darwinbeing/PB560/medtronic-pb560-ventilator-system-file-set-2/Mechanical Part Drawings/2963300/2963300_B_ECO-R214715.pdf

# 2963300, Revision B

Attribute Name | Attribute Value
Part Number | 2963300
Part Description | ELECTRIC FILTER WITH FOAM
Subclass | RSP PART - MECHANICAL
Product Family | RSP - VENTILATOR SYSTEMS
Part Category | FILTER
UOM | EA = EACH
Lifecycle Phase | Production
Release Date | 01/24/2013 13:55:03 GMT
Effectivity Date | 05/17/2013 07:00:00 GMT
Incorporation Date | 01/23/2013 21:19:53 GMT
Rev | B ECO-R214715

## Not Used

Owning Site: Agile Only | BOULDER
Model Number: Agile Only | RSP - PB560-520
Item Type: BPCS Add | P = Purchased Custom
Manufacturing Sites: Agile Only | N/A
Consuming Sites: Agile Only | GALWAY
Must Single Issue: BPCS Add | NO
Control Method: BPCS Add | NONE
Commodity Code: BPCS Add-Updt | RM10.00
Shelf Life Days:BPCS Add-Updt | 0
Item Class: BPCS Add-Updt | GL-66 PB500 Series Ventilators/Gen 1
Country of Origin: BPCS Add | FR = FRANCE
Legacy Site Agile BOM Load | USED FOR RSP AGILE DATA LOAD
Legacy Site Agile Part Load | USED FOR RSP AGILE DATA LOAD
Originator (Agile User Name) | Paul - RSP PLS Keller

## Attachment Destination Supplier

Notes | AIROX AML

## Replaced By (List new number) Supersedes (List old number) Matrix/Tab/Source Cntl Dwg #

## Page 1 of

# Pending Changes

ECO Number | ECO Type | Proposed Rev | Status | Description of Change | Change Analyst | Date Originated

## Page 2 of

# Change History

Rev | Lifecycle | Release Date | Incorp Date | Effective Date | ECO Number | ECO Type | Description of Change

Date Originated

B | Production | 01/24/2013 13:55:03 GMT | 01/23/2013 21:19:53 GMT | 05/17/2013 07:00:00 GMT | ECO-R214715 | RSP ECO - PRODUCTION
- UPDATE DRAWING
| | | | | | | TO COVIDIEN STANDARDS AS PER
| | | | | | | 10012400 DOCUMENT.
- UPDATED
| | | | | | | AFFECTED ITEMS PER ROHS PROCEDURE
| | | | | | | 10050020
- ADDED
| | | | | | | MANUFACTURE INFO ALONG WITH THE CERTIFICATE OF ROHS COMPLIANCE.
- ADDED COVIDIEN
| | | | | | | AS MANUFACTURER IN THE MANUFACTURE TAB.
- CHANGED ITEM
| | | | | | | TYPE FROM "P=PURCHASED" TO "P=PURCHASE CUSTOM" AND FROM "6=NON-INV" TO "6=NON-INV CUSTOM".
- FOR P/N
| | | | | | | 4096600.M00.023, ADDED ANGULAR TOLERANCE PER SHEET METAL TOLERANCE PROCEDURE 4- 070138-52.
- FOR #2963300
| | | | | | | CREATED BOM BY ADDING #10049689 AND #10049690.
- NO CHANGE IN FIT,
| | | | | | | FORM AND FUNCTION OF THE PARTS.
- PLEASE REFER
| | | | | | | CDP-RMS-0000518 AFFECTED ITEMS:
1) 2963300
2) 4096600.M00.002
3) 4096600.M00.003
4) 4096600.M00.023
5) 3821600

07/20/2012 07:55:30
GMT
A | Production | 01/14/2010 12:13:35 GMT | 01/14/2010 12:10:08 GMT | 05/13/2010 23:00:00 GMT | ECO-R179932 | RSP ECO -PRODUCTION | 1/BRINGING ITEMS TO CURRENT REV IN AGILE | 12/18/2009 08:55:43 GMT
00 | Production | 09/12/2007 10:40:32 GMT | 08/27/2007 08:13:20 GMT | 08/30/2007 23:00:00 GMT | ECO-R163956 | RSP ECO -PRODUCTION | INITIAL RELEASE OF LEGENDAIR XL2 AML PARTS, WITH REVISIONS. | 07/31/2007 09:10:08 GMT
| Pilot | 05/22/2007 13:21:27 GMT | | | ECO-R163056 | RSP ECO - BPCS PART UPDATE | INITIAL RELEASE OF LEGENDAIR XL2 P/NS ONTO GALWAY BPCS | 05/22/2007 12:35:01 GMT
| Pilot | 05/22/2007 07:44:32 GMT | | | ECO-R163013 | RSP ECO - BPCS PART UPDATE | INITIAL RELEASE OF LEGENDAIR XL2 P/NS ONTO GALWAY BPCS | 05/18/2007 11:52:27 GMT

## Page 3 of

# BOM

Part Number | Part Description | Rev | Qty | Line Item # | Ref Des | Notes | Alternate Part? | Balloon | Item Subclass | Lifecycle | Thumbnail
10049689 | IFU, GEN 1, FILTER, 6 PACK | C ECO-R250933 | 1 | 0 | | | NO | | RSP PART -LABEL/MANUAL | Production
10049690 | LABEL, GEN 1, FILTER, 6 PACK | C ECO-R250933 | 1 | 0 | | | NO | | RSP PART -LABEL/MANUAL | Production

## Page 4 of

# Manufacturers

Manufacturer Name | Manufacturer's Part number | Mfr. Part Status | Preference Code | Notes | Manufacturer Code | Manufacturer Status | RoHs Compliance Status | ROHS Inventory Status
AIR SAFETY LTD., | 7270 / 213 | QUALIFIED | PREFERRED | REFER TO COVIDIEN DRAWING 2963300 | | APPROVED | ROHS | Cleared

## Page 5 of

# Relationships

Criteria Met | Name | Description | Current Status | Rule | Type | Relation Note

## Page 6 of

# Attachments

Is Checked Out | Has Been Redlined | Filename | File Descripti on | File Size | File Type | Folder Number | Checkou t User | Checkou t Date | Modified Date | Last View Date | Checkou t Location | Version Create Date | Attachm ent Type | Thumbn ail | Checkin User | Label | Folder Descripti on | Folder Version
false | false | 2963300. SLDDRW | Approved Rev B, Source files | 681472.0 | SLDDRW | FOLDER0 306400 | | | 05/02/201 4 13:10:45 GMT | 05/02/201 4 13:10:44 GMT | | 11/20/201 2 11:24:57 GMT | | | Nikhil Mankar | | | 2
false | false | 2963300B 00.PDF | Approved Rev B | 29597.0 | PDF | FOLDER0 306399 | | | 05/02/201 4 13:16:49 GMT | 05/02/201 4 13:16:48 GMT | | 12/13/201 2 10:48:02 GMT | | | Nikhil Mankar | | | 3
false | false | 2963300A 00.pdf | Redlined Rev A to Rev B | 34547.0 | pdf | FOLDER0 306401 | | | 11/01/201 2 04:26:32 GMT | 11/01/201 2 04:26:32 GMT | | 11/01/201 2 04:26:32 GMT | | | Nikhil Mankar | | | 1

## Page 7 of

# History

Action | User | Local Client Time | User Action Time | Details | Comments | Rev
Get file attachment | Michael Duggan | 04/23/2015 11:03:58 GMT | 04/23/2015 12:03:58 PM | FOLDER0306399 V 3 2963300B00.PDF | | B ECO-R214715
Get file attachment | Michael Duggan | 04/23/2015 11:03:52 GMT | 04/23/2015 12:03:52 PM | FOLDER0306399 V 3 2963300B00.PDF | | B ECO-R214715
Get file attachment | Michael Duggan | 04/23/2015 09:27:04 GMT | 04/23/2015 10:27:04 AM | FOLDER0306399 V 3 2963300B00.PDF | | B ECO-R214715
Get file attachment | Brendan Boyle | 04/23/2015 09:17:01 GMT | 04/23/2015 10:17:01 AM | FOLDER0306399 V 3 2963300B00.PDF | | B ECO-R214715
Get file attachment | Tommy Duggan | 04/23/2015 09:16:48 GMT | 04/23/2015 10:16:48 AM | FOLDER0306399 V 3 2963300B00.PDF | | B ECO-R214715
Get file attachment | Martin Gargiulo | 03/20/2015 11:17:11 GMT | 03/20/2015 11:17:11 AM | FOLDER0306399 V 3 2963300B00.PDF | | B ECO-R214715
Get file attachment | Patricia Smith | 01/12/2015 09:28:06 GMT | 01/12/2015 09:28:06 AM | FOLDER0306399 V 3 2963300B00.PDF | | B ECO-R214715
Get file attachment | Sean Foley | 01/08/2015 16:34:33 GMT | 01/08/2015 04:34:33 PM | FOLDER0306399 V 3 2963300B00.PDF | | B ECO-R214715
Get file attachment | Liam Curley | 01/08/2015 12:25:46 GMT | 01/08/2015 12:25:46 PM | FOLDER0306399 V 3 2963300B00.PDF | | B ECO-R214715
Print Tab | Martin Gargiulo | 01/08/2015 09:47:50 GMT | 01/08/2015 09:47:50 AM | Manufacturers
Print Tab | Martin Gargiulo | 01/08/2015 09:47:30 GMT | 01/08/2015 09:47:30 AM | Manufacturers
Get file attachment | Martin Gargiulo | 01/08/2015 09:46:08 GMT | 01/08/2015 09:46:08 AM | FOLDER0306399 V 3 2963300B00.PDF | | B ECO-R214715
Get file attachment | Martin Gargiulo | 01/07/2015 14:53:24 GMT | 01/07/2015 02:53:24 PM | FOLDER0306399 V 3 2963300B00.PDF | | B ECO-R214715
Get file attachment | John Berry | 09/18/2014 10:22:37 GMT | 09/18/2014 11:22:37 AM | FOLDER0306399 V 3 2963300B00.PDF | | B ECO-R214715
Get file attachment | John Berry | 08/13/2014 13:52:04 GMT | 08/13/2014 02:52:04 PM | FOLDER0306399 V 3 2963300B00.PDF | | B ECO-R214715
Get file attachment | John Berry | 08/13/2014 13:51:58 GMT | 08/13/2014 02:51:58 PM | FOLDER0306399 V 3 2963300B00.PDF | | B ECO-R214715
Get file attachment | Sean Foley | 08/11/2014 10:22:22 GMT | 08/11/2014 11:22:22 AM | FOLDER0306399 V 3 2963300B00.PDF | | (B) ECO-R248733
Get file attachment | Sean Foley | 07/17/2014 08:15:34 GMT | 07/17/2014 09:15:34 AM | FOLDER0306399 V 3 2963300B00.PDF | | B ECO-R214715
Get file attachment | Gerard Cunningham | 07/07/2014 14:50:44 GMT | 07/07/2014 09:50:44 AM | FOLDER0306399 V 3 2963300B00.PDF | | B ECO-R214715
Get file attachment | Michael Munnelly | 06/23/2014 12:21:57 GMT | 06/23/2014 01:21:57 PM | FOLDER0306399 V 3 2963300B00.PDF | | B ECO-R214715
Get file attachment | Michael Munnelly | 06/23/2014 12:21:25 GMT | 06/23/2014 01:21:25 PM | OLDFILE575146 V 0 2963300A00.pdf | | A ECO-R179932
Get file attachment | Michael Munnelly | 06/23/2014 12:18:38 GMT | 06/23/2014 01:18:38 PM | FOLDER0306401 V 1 2963300A00.pdf
Get file attachment | Michael Munnelly | 06/23/2014 12:16:59 GMT | 06/23/2014 01:16:59 PM | FOLDER0306399 V 3 2963300B00.PDF | | B ECO-R214715
Get file attachment | Michael Munnelly | 06/23/2014 12:16:15 GMT | 06/23/2014 01:16:15 PM | FOLDER0306399 V 3 2963300B00.PDF | | B ECO-R214715
Get file attachment | Deirdre Smyth | 05/28/2014 08:46:12 GMT | 05/28/2014 09:46:12 AM | FOLDER0306399 V 3 2963300B00.PDF | | B ECO-R214715
Get file attachment | Deirdre Smyth | 05/28/2014 08:46:00 GMT | 05/28/2014 09:46:00 AM | FOLDER0306400 V 2 2963300.SLDDRW | | B ECO-R214715
View file attachment | Jennifer Wulff | 05/02/2014 13:16:48 GMT | 05/02/2014 06:16:48 AM | FOLDER0306399 V 3 2963300B00.PDF | | B ECO-R214715
View file attachment | Jennifer Wulff | 05/02/2014 13:11:23 GMT | 05/02/2014 06:11:23 AM | FOLDER0306399 V 3 2963300B00.PDF | | B ECO-R214715
View file attachment | Jennifer Wulff | 05/02/2014 13:10:44 GMT | 05/02/2014 06:10:44 AM | FOLDER0306400 V 2 2963300.SLDDRW | | B ECO-R214715

## Page 8 of

Get file attachment | Marie Burke | 04/23/2014 09:22:57 GMT | 04/23/2014 10:22:57 AM | FOLDER0306399 V 3 2963300B00.PDF | B ECO-R214715
Get file attachment | Adam Pearce | 04/23/2014 07:09:07 GMT | 04/23/2014 02:09:07 AM | FOLDER0306399 V 3 2963300B00.PDF | B ECO-R214715
Get file attachment | Sachiko Kageyama | 03/11/2014 05:15:04 GMT | 03/11/2014 12:15:04 AM | FOLDER0306399 V 3 2963300B00.PDF | B ECO-R214715
Get file attachment | Yvonne Spain | 11/06/2013 09:18:34 GMT | 11/06/2013 03:18:34 AM | FOLDER0306399 V 3 2963300B00.PDF | B ECO-R214715
Get file attachment | Dara O'Connor | 10/31/2013 08:25:18 GMT | 10/31/2013 08:25:18 AM | FOLDER0306399 V 3 2963300B00.PDF | B ECO-R214715
Get file attachment | Michael Feeney | 09/23/2013 14:40:23 GMT | 09/23/2013 03:40:23 PM | FOLDER0306399 V 3 2963300B00.PDF | B ECO-R214715
Get file attachment | Dara O'Connor | 09/11/2013 07:29:08 GMT | 09/11/2013 08:29:08 AM | FOLDER0306399 V 3 2963300B00.PDF | B ECO-R214715
Get file attachment | Melissa Vahey | 08/20/2013 10:50:14 GMT | 08/20/2013 03:50:14 AM | FOLDER0306399 V 3 2963300B00.PDF | B ECO-R214715
View file attachment | Deirdre Smyth | 06/25/2013 15:10:47 GMT | 06/25/2013 04:10:47 PM | FOLDER0306399 V 3 2963300B00.PDF | B ECO-R214715
View file attachment | Deirdre Smyth | 06/25/2013 14:36:32 GMT | 06/25/2013 03:36:32 PM | FOLDER0306399 V 3 2963300B00.PDF | B ECO-R214715
Get file attachment | Tommy Duggan | 05/17/2013 13:16:58 GMT | 05/17/2013 02:16:58 PM | FOLDER0306399 V 3 2963300B00.PDF | B ECO-R214715
Get file attachment | Mary Loftus-Burke | 05/17/2013 12:13:16 GMT | 05/17/2013 01:13:16 PM | FOLDER0306399 V 3 2963300B00.PDF | B ECO-R214715
Get file attachment | Dara O'Connor | 03/27/2013 11:44:28 GMT | 03/27/2013 11:44:28 AM | FOLDER0306399 V 3 2963300B00.PDF | B ECO-R214715
Get file attachment | Brian Keenan | 02/14/2013 11:41:16 GMT | 02/14/2013 05:41:16 AM | FOLDER0306399 V 3 2963300B00.PDF | B ECO-R214715
Open file attachment | Joseph Burke | 02/05/2013 10:14:51 GMT | 02/05/2013 10:14:51 AM | FOLDER0306399 V 3 2963300B00.PDF | B ECO-R214715
Print Tab | Patricia Smith | 01/24/2013 15:48:02 GMT | 01/24/2013 03:48:02 PM | BOM
Print Tab | Patricia Smith | 01/24/2013 15:43:46 GMT | 01/24/2013 03:43:46 PM | Manufacturers
Print Tab | Patricia Smith | 01/24/2013 15:38:53 GMT | 01/24/2013 03:38:53 PM | BOM
Get file attachment | Patricia Smith | 01/24/2013 15:34:41 GMT | 01/24/2013 03:34:41 PM | FOLDER0306399 V 3 2963300B00.PDF | B ECO-R214715
Modify Change Controlled | Teresa Searcy | 01/24/2013 13:55:04 GMT | 01/24/2013 06:55:04 AM | <Part Attributes.Item Type: BPCS Add>WAS<P=PURCHASED>I S<P = Purchased Custom> | B ECO-R214715
View file attachment | Sean Sidley | 01/24/2013 10:47:19 GMT | 01/24/2013 10:47:19 AM | FOLDER0306400 V 2 2963300.SLDDRW | (B) ECO-R214715
Get file attachment | Sean Sidley | 01/24/2013 10:47:14 GMT | 01/24/2013 10:47:14 AM | FOLDER0306400 V 2 2963300.SLDDRW
Get file attachment | Sean Sidley | 01/24/2013 10:47:05 GMT | 01/24/2013 10:47:05 AM | FOLDER0306399 V 3 2963300B00.PDF
Incorporate | Teresa Searcy | 01/23/2013 21:19:53 GMT | 01/23/2013 02:19:53 PM | | (B) ECO-R214715
Open file attachment | Teresa Searcy | 01/23/2013 21:19:26 GMT | 01/23/2013 02:19:26 PM | FOLDER0306399 V 3 2963300B00.PDF | (B) ECO-R214715
Open file attachment | Teresa Searcy | 01/23/2013 21:17:51 GMT | 01/23/2013 02:17:51 PM | FOLDER0306400 V 2 2963300.SLDDRW | (B) ECO-R214715
Modify | Teresa Searcy | 01/23/2013 21:17:00 GMT | 01/23/2013 02:17:00 PM | <Attachments.File Description>WAS<Proposed Rev B, Source files>IS<Approved Rev B, Source files> | (B) ECO-R214715
Modify | Teresa Searcy | 01/23/2013 21:16:51 GMT | 01/23/2013 02:16:51 PM | <Attachments.File Description>WAS<Proposed Rev B>IS<Approved Rev B> | (B) ECO-R214715
Unincorporate | Teresa Searcy | 01/23/2013 21:16:43 GMT | 01/23/2013 02:16:43 PM | | (B) ECO-R214715

## Page 9 of

View file attachment | Sean Sidley | 01/23/2013 16:49:43 GMT | 01/23/2013 04:49:43 PM | FOLDER0306400 V 2 2963300.SLDDRW | (B) ECO-R214715
Get file attachment | Sean Sidley | 01/23/2013 14:53:12 GMT | 01/23/2013 02:53:12 PM | FOLDER0306399 V 3 2963300B00.PDF | (B) ECO-R214715
Get file attachment | Sean Sidley | 01/23/2013 14:52:51 GMT | 01/23/2013 02:52:51 PM | FOLDER0306401 V 1 2963300A00.pdf | (B) ECO-R214715
Get file attachment | Tommy Duggan | 01/23/2013 13:08:30 GMT | 01/23/2013 01:08:30 PM | FOLDER0306399 V 3 2963300B00.PDF | (B) ECO-R214715
Get file attachment | Tommy Duggan | 01/23/2013 13:08:08 GMT | 01/23/2013 01:08:08 PM | FOLDER0306401 V 1 2963300A00.pdf | (B) ECO-R214715
Get file attachment | Patricia Smith | 01/23/2013 12:45:55 GMT | 01/23/2013 12:45:55 PM | FOLDER0306399 V 3 2963300B00.PDF | (B) ECO-R214715
Get file attachment | Patricia Smith | 01/23/2013 12:45:55 GMT | 01/23/2013 12:45:55 PM | FOLDER0306401 V 1 2963300A00.pdf | (B) ECO-R214715
Get file attachment | Derek Wynne | 01/23/2013 09:10:29 GMT | 01/23/2013 09:10:29 AM | FOLDER0306399 V 3 2963300B00.PDF
Get file attachment | Derek Wynne | 01/23/2013 09:08:56 GMT | 01/23/2013 09:08:56 AM | FOLDER0306401 V 1 2963300A00.pdf
Get file attachment | Gearoid Roche | 01/22/2013 18:21:14 GMT | 01/22/2013 12:21:14 PM | FOLDER0306399 V 3 2963300B00.PDF | (B) ECO-R214715
Get file attachment | Gearoid Roche | 01/22/2013 18:20:46 GMT | 01/22/2013 12:20:46 PM | FOLDER0306401 V 1 2963300A00.pdf | (B) ECO-R214715
Get file attachment | John Sheehan | 01/22/2013 17:01:10 GMT | 01/22/2013 05:01:10 PM | FOLDER0306399 V 3 2963300B00.PDF | (B) ECO-R214715
Get file attachment | John Sheehan | 01/22/2013 17:00:45 GMT | 01/22/2013 05:00:45 PM | FOLDER0306401 V 1 2963300A00.pdf | (B) ECO-R214715
Incorporate | Teresa Searcy | 01/22/2013 14:22:02 GMT | 01/22/2013 07:22:02 AM | | (B) ECO-R214715
Get file attachment | Sean Sidley | 01/16/2013 09:10:31 GMT | 01/16/2013 09:10:31 AM | FOLDER0306401 V 1 2963300A00.pdf | (B) ECO-R214715
Get file attachment | Sean Sidley | 01/16/2013 09:09:58 GMT | 01/16/2013 09:09:58 AM | FOLDER0306399 V 3 2963300B00.PDF | (B) ECO-R214715
Get file attachment | Nikhil Mankar | 01/16/2013 09:09:02 GMT | 01/16/2013 01:09:02 AM | FOLDER0306401 V 1 2963300A00.pdf
Get file attachment | Sean Sidley | 01/16/2013 09:08:46 GMT | 01/16/2013 09:08:46 AM | FOLDER0306401 V 1 2963300A00.pdf
Get file attachment | George Winski | 01/10/2013 18:03:22 GMT | 01/10/2013 12:03:22 PM | FOLDER0306399 V 3 2963300B00.PDF | (B) ECO-R214715
Get file attachment | George Winski | 01/10/2013 18:02:47 GMT | 01/10/2013 12:02:47 PM | OLDFILE575146 V 0 2963300A00.pdf | A ECO-R179932
Get file attachment | Sean Sidley | 01/10/2013 14:16:17 GMT | 01/10/2013 02:16:17 PM | FOLDER0306399 V 3 2963300B00.PDF
Get file attachment | Sean Sidley | 01/10/2013 14:15:58 GMT | 01/10/2013 02:15:58 PM | FOLDER0306401 V 1 2963300A00.pdf
Get file attachment | Nikhil Mankar | 01/10/2013 09:15:34 GMT | 01/10/2013 01:15:34 AM | OLDFILE575146 V 0 2963300A00.pdf | A ECO-R179932
Get file attachment | Nikhil Mankar | 01/10/2013 09:15:21 GMT | 01/10/2013 01:15:21 AM | FOLDER0306399 V 3 2963300B00.PDF | (B) ECO-R214715
Unincorporate | Teresa Searcy | 01/09/2013 14:16:26 GMT | 01/09/2013 07:16:26 AM | | (B) ECO-R214715
Get file attachment | Nikhil Mankar | 01/09/2013 13:52:24 GMT | 01/09/2013 05:52:24 AM | FOLDER0306399 V 3 2963300B00.PDF | (B) ECO-R214715
View file attachment | Mairead Kilbane | 01/09/2013 13:29:18 GMT | 01/09/2013 01:29:18 PM | OLDFILE575146 V 0 2963300A00.pdf | A ECO-R179932
View file attachment | Mairead Kilbane | 01/09/2013 13:26:25 GMT | 01/09/2013 01:26:25 PM | OLDFILE575146 V 0 2963300A00.pdf | A ECO-R179932
Get file attachment | Brian Keenan | 01/09/2013 13:13:23 GMT | 01/09/2013 07:13:23 AM | OLDFILE575146 V 0 2963300A00.pdf | A ECO-R179932
Get file attachment | Michael Feeney | 01/09/2013 13:10:03 GMT | 01/09/2013 01:10:03 PM | OLDFILE575146 V 0 2963300A00.pdf | A ECO-R179932

## Page 10 of

Get file attachment | Sean Sidley | 01/09/2013 13:09:33 GMT | 01/09/2013 01:09:33 PM | OLDFILE575146 V 0 2963300A00.pdf | A ECO-R179932
Get file attachment | Nikhil Mankar | 01/09/2013 12:59:23 GMT | 01/09/2013 04:59:23 AM | FOLDER0306401 V 1 2963300A00.pdf | (B) ECO-R214715
Get file attachment | Nikhil Mankar | 01/09/2013 12:59:03 GMT | 01/09/2013 04:59:03 AM | OLDFILE597544 V 0 2963300A00.pdf | A ECO-R179932
Get file attachment | Nikhil Mankar | 01/09/2013 12:58:48 GMT | 01/09/2013 04:58:48 AM | FOLDER0306399 V 3 2963300B00.PDF | (B) ECO-R214715
Get file attachment | George Winski | 01/07/2013 17:41:23 GMT | 01/07/2013 11:41:23 AM | FOLDER0306401 V 1 2963300A00.pdf | (B) ECO-R214715
Get file attachment | Nikhil Mankar | 01/07/2013 10:53:04 GMT | 01/07/2013 02:53:04 AM | FOLDER0306399 V 3 2963300B00.PDF
Get file attachment | Tommy Duggan | 01/04/2013 14:28:17 GMT | 01/04/2013 02:28:17 PM | FOLDER0306399 V 3 2963300B00.PDF | (B) ECO-R214715
Get file attachment | Nikhil Mankar | 01/04/2013 03:46:35 GMT | 01/03/2013 07:46:35 PM | FOLDER0306399 V 3 2963300B00.PDF
Get file attachment | George Winski | 01/03/2013 20:01:14 GMT | 01/03/2013 02:01:14 PM | FOLDER0306399 V 3 2963300B00.PDF | (B) ECO-R214715
Get file attachment | Tommy Duggan | 01/03/2013 16:38:44 GMT | 01/03/2013 04:38:44 PM | FOLDER0306399 V 3 2963300B00.PDF | (B) ECO-R214715
Get file attachment | Tommy Duggan | 01/03/2013 16:38:25 GMT | 01/03/2013 04:38:25 PM | FOLDER0306401 V 1 2963300A00.pdf | (B) ECO-R214715
Get file attachment | Derek Wynne | 01/02/2013 08:15:57 GMT | 01/02/2013 08:15:57 AM | FOLDER0306399 V 3 2963300B00.PDF
Get file attachment | George Winski | 12/20/2012 21:13:11 GMT | 12/20/2012 03:13:11 PM | FOLDER0306399 V 3 2963300B00.PDF | (B) ECO-R214715
Get file attachment | Sean Sidley | 12/20/2012 16:20:11 GMT | 12/20/2012 04:20:11 PM | FOLDER0306399 V 3 2963300B00.PDF
Get file attachment | Sean Sidley | 12/20/2012 16:19:55 GMT | 12/20/2012 04:19:55 PM | FOLDER0306401 V 1 2963300A00.pdf
Get file attachment | Sean Sidley | 12/20/2012 16:10:02 GMT | 12/20/2012 04:10:02 PM | FOLDER0306401 V 1 2963300A00.pdf
Get file attachment | Patricia Smith | 12/17/2012 11:15:50 GMT | 12/17/2012 11:15:50 AM | FOLDER0306399 V 3 2963300B00.PDF | (B) ECO-R214715
Get file attachment | Patricia Smith | 12/17/2012 11:15:50 GMT | 12/17/2012 11:15:50 AM | FOLDER0306401 V 1 2963300A00.pdf | (B) ECO-R214715
Get file attachment | Patricia Smith | 12/17/2012 11:15:43 GMT | 12/17/2012 11:15:43 AM | FOLDER0306399 V 3 2963300B00.PDF | (B) ECO-R214715
Get file attachment | Gearoid Roche | 12/14/2012 12:29:02 GMT | 12/14/2012 06:29:02 AM | FOLDER0306399 V 3 2963300B00.PDF | (B) ECO-R214715
Get file attachment | Gearoid Roche | 12/14/2012 12:28:36 GMT | 12/14/2012 06:28:36 AM | FOLDER0306401 V 1 2963300A00.pdf | (B) ECO-R214715
Get file attachment | John Sheehan | 12/13/2012 17:28:56 GMT | 12/13/2012 11:28:56 AM | FOLDER0306399 V 3 2963300B00.PDF | (B) ECO-R214715
Get file attachment | John Sheehan | 12/13/2012 17:28:06 GMT | 12/13/2012 11:28:06 AM | FOLDER0306401 V 1 2963300A00.pdf | (B) ECO-R214715
Get file attachment | Michael Jaramillo | 12/13/2012 17:05:40 GMT | 12/13/2012 10:05:40 AM | FOLDER0306401 V 1 2963300A00.pdf
Get file attachment | Michael Jaramillo | 12/13/2012 17:05:24 GMT | 12/13/2012 10:05:24 AM | FOLDER0306399 V 3 2963300B00.PDF
Incorporate | Teresa Searcy | 12/13/2012 15:28:26 GMT | 12/13/2012 08:28:26 AM | | (B) ECO-R214715
Get file attachment | Teresa Searcy | 12/13/2012 15:01:13 GMT | 12/13/2012 08:01:13 AM | FOLDER0306399 V 3 2963300B00.PDF | (B) ECO-R214715
Checkin file attachment | Nikhil Mankar | 12/13/2012 10:48:02 GMT | 12/13/2012 02:48:02 AM | FOLDER0306399 V 3 2963300B00.PDF | (B) ECO-R214715
Checkout file attachment | Nikhil Mankar | 12/13/2012 10:47:30 GMT | 12/13/2012 02:47:30 AM | FOLDER0306399 V 2 2963300B00.PDF | (B) ECO-R214715
Unincorporate | Teresa Searcy | 12/11/2012 14:23:23 GMT | 12/11/2012 07:23:23 AM | | (B) ECO-R214715

## Page 11 of

Get file attachment | Sean Sidley | 12/10/2012 12:18:18 GMT | 12/10/2012 12:18:18 PM | FOLDER0306401 V 1 2963300A00.pdf
Get file attachment | Sean Sidley | 12/10/2012 12:17:51 GMT | 12/10/2012 12:17:51 PM | FOLDER0306399 V 2 2963300B00.PDF
Get file attachment | Sean Sidley | 12/10/2012 12:17:22 GMT | 12/10/2012 12:17:22 PM | FOLDER0306401 V 1 2963300A00.pdf
Get file attachment | Gearoid Roche | 12/10/2012 10:55:06 GMT | 12/10/2012 04:55:06 AM | FOLDER0306399 V 2 2963300B00.PDF | (B) ECO-R214715
Get file attachment | Gearoid Roche | 12/10/2012 10:54:50 GMT | 12/10/2012 04:54:50 AM | FOLDER0306401 V 1 2963300A00.pdf | (B) ECO-R214715
Open file attachment | John Horiuchi | 12/05/2012 17:25:56 GMT | 12/05/2012 11:25:56 AM | FOLDER0306401 V 1 2963300A00.pdf | (B) ECO-R214715
Open file attachment | John Horiuchi | 12/05/2012 17:25:34 GMT | 12/05/2012 11:25:34 AM | FOLDER0306399 V 2 2963300B00.PDF | (B) ECO-R214715
Incorporate | Teresa Searcy | 12/05/2012 17:09:35 GMT | 12/05/2012 10:09:35 AM | | (B) ECO-R214715
Get file attachment | Teresa Searcy | 12/05/2012 17:00:05 GMT | 12/05/2012 10:00:05 AM | FOLDER0306399 V 2 2963300B00.PDF | (B) ECO-R214715
Modify | Teresa Searcy | 12/05/2012 16:48:30 GMT | 12/05/2012 09:48:30 AM | <Part Attributes.Model Number: Agile Only>WAS<>IS<RSP - PB560-520> | (B) ECO-R214715
Get file attachment | Teresa Searcy | 12/05/2012 16:47:13 GMT | 12/05/2012 09:47:13 AM | FOLDER0306399 V 2 2963300B00.PDF | (B) ECO-R214715
Get file attachment | Michael Jaramillo | 11/30/2012 20:12:59 GMT | 11/30/2012 01:12:59 PM | FOLDER0306399 V 2 2963300B00.PDF
Get file attachment | Michael Jaramillo | 11/30/2012 20:12:52 GMT | 11/30/2012 01:12:52 PM | FOLDER0306399 V 2 2963300B00.PDF
Get file attachment | Michael Feeney | 11/27/2012 14:43:30 GMT | 11/27/2012 02:43:30 PM | OLDFILE575146 V 0 2963300A00.pdf | A ECO-R179932
Get file attachment | Nikhil Mankar | 11/22/2012 03:42:30 GMT | 11/21/2012 07:42:30 PM | FOLDER0306399 V 2 2963300B00.PDF
Get file attachment | Michael Jaramillo | 11/21/2012 18:03:46 GMT | 11/21/2012 11:03:46 AM | FOLDER0306401 V 1 2963300A00.pdf
Get file attachment | Michael Jaramillo | 11/21/2012 17:54:31 GMT | 11/21/2012 10:54:31 AM | FOLDER0306399 V 2 2963300B00.PDF
Get file attachment | Sean Sidley | 11/20/2012 16:22:23 GMT | 11/20/2012 04:22:23 PM | FOLDER0306399 V 2 2963300B00.PDF
Get file attachment | Sean Sidley | 11/20/2012 16:22:09 GMT | 11/20/2012 04:22:09 PM | FOLDER0306401 V 1 2963300A00.pdf
Checkin file attachment | Nikhil Mankar | 11/20/2012 11:25:33 GMT | 11/20/2012 03:25:33 AM | FOLDER0306399 V 2 2963300B00.PDF | (B) ECO-R214715
Checkout file attachment | Nikhil Mankar | 11/20/2012 11:25:03 GMT | 11/20/2012 03:25:03 AM | FOLDER0306399 V 1 2963300B00.PDF | (B) ECO-R214715
Checkin file attachment | Nikhil Mankar | 11/20/2012 11:24:57 GMT | 11/20/2012 03:24:57 AM | FOLDER0306400 V 2 2963300.SLDDRW | (B) ECO-R214715
Checkout file attachment | Nikhil Mankar | 11/20/2012 11:24:28 GMT | 11/20/2012 03:24:28 AM | FOLDER0306400 V 1 2963300B00.zip | (B) ECO-R214715
Get file attachment | Nikhil Mankar | 11/20/2012 11:12:16 GMT | 11/20/2012 03:12:16 AM | FOLDER0306401 V 1 2963300A00.pdf | (B) ECO-R214715
Get file attachment | Nikhil Mankar | 11/20/2012 11:11:43 GMT | 11/20/2012 03:11:43 AM | FOLDER0306399 V 1 2963300B00.PDF
Get file attachment | Michael Feeney | 11/20/2012 09:04:18 GMT | 11/20/2012 09:04:18 AM | FOLDER0306401 V 1 2963300A00.pdf | (B) ECO-R214715
Get file attachment | Michael Feeney | 11/20/2012 09:04:12 GMT | 11/20/2012 09:04:12 AM | FOLDER0306399 V 1 2963300B00.PDF | (B) ECO-R214715
Get file attachment | Nikhil Mankar | 11/02/2012 10:11:34 GMT | 11/02/2012 03:11:34 AM | FOLDER0306399 V 1 2963300B00.PDF
Get file attachment | Nikhil Mankar | 11/02/2012 09:54:58 GMT | 11/02/2012 02:54:58 AM | FOLDER0306399 V 1 2963300B00.PDF

## Page 12 of

Get file attachment | Nikhil Mankar | 11/02/2012 09:54:28 GMT | 11/02/2012 02:54:28 AM | FOLDER0306401 V 1 2963300A00.pdf
Get file attachment | Nikhil Mankar | 11/02/2012 09:44:19 GMT | 11/02/2012 02:44:19 AM | FOLDER0306399 V 1 2963300B00.PDF
Add file attachment | Nikhil Mankar | 11/01/2012 04:26:32 GMT | 10/31/2012 09:26:32 PM | FOLDER0306400 V 1 2963300B00.zip | (B) ECO-R214715
Add file attachment | Nikhil Mankar | 11/01/2012 04:26:32 GMT | 10/31/2012 09:26:32 PM | FOLDER0306401 V 1 2963300A00.pdf | (B) ECO-R214715
Add file attachment | Nikhil Mankar | 11/01/2012 04:26:31 GMT | 10/31/2012 09:26:31 PM | FOLDER0306399 V 1 2963300B00.PDF | (B) ECO-R214715
Remove file attachment | Nikhil Mankar | 11/01/2012 04:25:14 GMT | 10/31/2012 09:25:14 PM | FOLDER0249370 V 1 2963300A00-REDLINE.pdf | (B) ECO-R214715
Remove file attachment | Nikhil Mankar | 11/01/2012 04:25:14 GMT | 10/31/2012 09:25:14 PM | FOLDER0249369 V 1 2963300B00.zip | (B) ECO-R214715
Remove file attachment | Nikhil Mankar | 11/01/2012 04:25:13 GMT | 10/31/2012 09:25:13 PM | FOLDER0249368 V 1 2963300B00.PDF | (B) ECO-R214715
Get file attachment | Nikhil Mankar | 11/01/2012 04:03:25 GMT | 10/31/2012 09:03:25 PM | FOLDER0249368 V 1 2963300B00.PDF
Open file attachment | John Horiuchi | 10/22/2012 13:58:06 GMT | 10/22/2012 08:58:06 AM | FOLDER0249370 V 1 2963300A00-REDLINE.pdf | (B) ECO-R214715
Open file attachment | John Horiuchi | 10/22/2012 13:57:03 GMT | 10/22/2012 08:57:03 AM | FOLDER0249368 V 1 2963300B00.PDF | (B) ECO-R214715
Get file attachment | Sean Sidley | 10/22/2012 13:25:03 GMT | 10/22/2012 02:25:03 PM | FOLDER0249368 V 1 2963300B00.PDF
Get file attachment | Sean Sidley | 10/22/2012 13:24:44 GMT | 10/22/2012 02:24:44 PM | FOLDER0249370 V 1 2963300A00-REDLINE.pdf
Get file attachment | Michael Feeney | 10/22/2012 11:28:15 GMT | 10/22/2012 12:28:15 PM | FOLDER0249370 V 1 2963300A00-REDLINE.pdf | (B) ECO-R214715
Get file attachment | Michael Feeney | 10/22/2012 11:28:06 GMT | 10/22/2012 12:28:06 PM | FOLDER0249368 V 1 2963300B00.PDF | (B) ECO-R214715
Get file attachment | Michael Feeney | 10/22/2012 11:27:59 GMT | 10/22/2012 12:27:59 PM | FOLDER0249369 V 1 2963300B00.zip | (B) ECO-R214715
Get file attachment | Nikhil Mankar | 10/22/2012 06:44:37 GMT | 10/21/2012 11:44:37 PM | FOLDER0249368 V 1 2963300B00.PDF | (B) ECO-R214715
Get file attachment | Nikhil Mankar | 10/19/2012 17:23:53 GMT | 10/19/2012 10:23:53 AM | FOLDER0249368 V 1 2963300B00.PDF
Get file attachment | Nikhil Mankar | 10/19/2012 06:22:49 GMT | 10/18/2012 11:22:49 PM | FOLDER0249368 V 1 2963300B00.PDF | (B) ECO-R214715
Get file attachment | Nikhil Mankar | 10/19/2012 06:22:29 GMT | 10/18/2012 11:22:29 PM | FOLDER0249368 V 1 2963300B00.PDF | (B) ECO-R214715
Get file attachment | Sara Jane Daly | 08/20/2012 10:48:32 GMT | 08/20/2012 11:48:32 AM | OLDFILE575146 V 0 2963300A00.pdf | A ECO-R179932
Get file attachment | Sara Jane Daly | 08/20/2012 08:07:57 GMT | 08/20/2012 09:07:57 AM | OLDFILE575146 V 0 2963300A00.pdf | A ECO-R179932
Get file attachment | George Winski | 08/13/2012 14:31:50 GMT | 08/13/2012 09:31:50 AM | OLDFILE575146 V 0 2963300A00.pdf | A ECO-R179932
Get file attachment | George Winski | 08/13/2012 14:24:20 GMT | 08/13/2012 09:24:20 AM | OLDFILE575146 V 0 2963300A00.pdf | A ECO-R179932
Get file attachment | George Winski | 08/08/2012 17:57:02 GMT | 08/08/2012 12:57:02 PM | FOLDER0249368 V 1 2963300B00.PDF | (B) ECO-R214715
Get file attachment | George Winski | 08/08/2012 17:56:49 GMT | 08/08/2012 12:56:49 PM | FOLDER0249370 V 1 2963300A00-REDLINE.pdf | (B) ECO-R214715
Get file attachment | George Winski | 08/08/2012 17:30:47 GMT | 08/08/2012 12:30:47 PM | FOLDER0249370 V 1 2963300A00-REDLINE.pdf | (B) ECO-R214715
Add file attachment | Rathnakara Narayana | 08/06/2012 09:11:02 GMT | 08/06/2012 02:11:02 AM | FOLDER0249368 V 1 2963300B00.PDF | (B) ECO-R214715
Add file attachment | Rathnakara Narayana | 08/06/2012 09:11:02 GMT | 08/06/2012 02:11:02 AM | FOLDER0249370 V 1 2963300A00-REDLINE.pdf | (B) ECO-R214715
Add file attachment | Rathnakara Narayana | 08/06/2012 09:11:02 GMT | 08/06/2012 02:11:02 AM | FOLDER0249369 V 1 2963300B00.zip | (B) ECO-R214715

## Page 13 of

Remove file attachment | Rathnakara Narayana | 08/06/2012 09:09:35 GMT | 08/06/2012 02:09:35 AM | FOLDER0249315 V 1 2963300B00.PDF | (B) ECO-R214715
Remove file attachment | Rathnakara Narayana | 08/06/2012 09:09:35 GMT | 08/06/2012 02:09:35 AM | FOLDER0249317 V 1 2963300A00-REDLINE.pdf | (B) ECO-R214715
Remove file attachment | Rathnakara Narayana | 08/06/2012 09:09:35 GMT | 08/06/2012 02:09:35 AM | FOLDER0249314 V 1 2963300B00.zip | (B) ECO-R214715
Get file attachment | Nikhil Mankar | 08/06/2012 09:01:09 GMT | 08/06/2012 02:01:09 AM | FOLDER0249317 V 1 2963300A00-REDLINE.pdf | (B) ECO-R214715
Get file attachment | Nikhil Mankar | 08/06/2012 08:56:45 GMT | 08/06/2012 01:56:45 AM | OLDFILE575146 V 0 2963300A00.pdf | A ECO-R179932
Get file attachment | Nikhil Mankar | 08/06/2012 08:56:33 GMT | 08/06/2012 01:56:33 AM | FOLDER0249315 V 1 2963300B00.PDF | (B) ECO-R214715
Add file attachment | Rathnakara Narayana | 08/06/2012 06:55:40 GMT | 08/05/2012 11:55:40 PM | FOLDER0249317 V 1 2963300A00-REDLINE.pdf | (B) ECO-R214715
Remove file attachment | Rathnakara Narayana | 08/06/2012 06:55:12 GMT | 08/05/2012 11:55:12 PM | FOLDER0249316 V 1 2963300B00.zip | (B) ECO-R214715
Add file attachment | Rathnakara Narayana | 08/06/2012 06:53:55 GMT | 08/05/2012 11:53:55 PM | FOLDER0249314 V 1 2963300B00.zip | (B) ECO-R214715
Add file attachment | Rathnakara Narayana | 08/06/2012 06:53:55 GMT | 08/05/2012 11:53:55 PM | FOLDER0249316 V 1 2963300B00.zip | (B) ECO-R214715
Add file attachment | Rathnakara Narayana | 08/06/2012 06:53:55 GMT | 08/05/2012 11:53:55 PM | FOLDER0249315 V 1 2963300B00.PDF | (B) ECO-R214715
Remove file attachment | Rathnakara Narayana | 08/06/2012 06:50:12 GMT | 08/05/2012 11:50:12 PM | FOLDER0249313 V 1 2963300A00.pdf | (B) ECO-R214715
Remove file attachment | Rathnakara Narayana | 08/06/2012 06:50:12 GMT | 08/05/2012 11:50:12 PM | FOLDER0249312 V 1 2963300A00.pdf | (B) ECO-R214715
Open file attachment | Rathnakara Narayana | 08/06/2012 06:05:05 GMT | 08/05/2012 11:05:05 PM | OLDFILE575146 V 0 | A ECO-R179932
View file attachment | Rathnakara Narayana | 08/06/2012 06:04:50 GMT | 08/05/2012 11:04:50 PM | OLDFILE575146 V 0 2963300A00.pdf | A ECO-R179932
Get file attachment | Michael Feeney | 08/02/2012 09:45:50 GMT | 08/02/2012 10:45:50 AM | OLDFILE575146 V 0 2963300A00.pdf | A ECO-R179932
Get file attachment | Nikhil Mankar | 07/30/2012 05:45:01 GMT | 07/29/2012 10:45:01 PM | OLDFILE575146 V 0 2963300A00.pdf | A ECO-R179932
Open file attachment | Rathnakara Narayana | 07/26/2012 11:16:57 GMT | 07/26/2012 04:16:57 AM | OLDFILE575146 V 0 | A ECO-R179932
Open file attachment | Rathnakara Narayana | 07/25/2012 13:40:55 GMT | 07/25/2012 06:40:55 AM | OLDFILE575146 V 0 | A ECO-R179932
Open file attachment | Rathnakara Narayana | 07/24/2012 09:21:52 GMT | 07/24/2012 02:21:52 AM | OLDFILE575146 V 0 | A ECO-R179932
Get file attachment | Brendan Ryan | 07/18/2012 14:19:37 GMT | 07/18/2012 09:19:37 AM | OLDFILE575146 V 0 2963300A00.pdf | A ECO-R179932
Get file attachment | Nikhil Mankar | 07/09/2012 11:20:23 GMT | 07/09/2012 04:20:23 AM | OLDFILE575146 V 0 2963300A00.pdf | A ECO-R179932
Get file attachment | Nikhil Mankar | 07/09/2012 11:19:55 GMT | 07/09/2012 04:19:55 AM | OLDFILE575146 V 0 2963300A00.pdf | A ECO-R179932
Get file attachment | Nikhil Mankar | 07/09/2012 11:19:55 GMT | 07/09/2012 04:19:55 AM | OLDFILE597544 V 0 2963300A00.pdf | A ECO-R179932
Get file attachment | George Winski | 06/22/2012 18:53:39 GMT | 06/22/2012 01:53:39 PM | OLDFILE575146 V 0 2963300A00.pdf | A ECO-R179932
Get file attachment | Nikhil Mankar | 05/25/2012 11:11:33 GMT | 05/25/2012 04:11:33 AM | OLDFILE597544 V 0 2963300A00.pdf | A ECO-R179932
Get file attachment | Nikhil Mankar | 05/25/2012 11:11:33 GMT | 05/25/2012 04:11:33 AM | OLDFILE575146 V 0 2963300A00.pdf | A ECO-R179932
Get file attachment | Nikhil Mankar | 05/25/2012 10:36:15 GMT | 05/25/2012 03:36:15 AM | OLDFILE597544 V 0 2963300A00.pdf | A ECO-R179932
Get file attachment | Nikhil Mankar | 05/25/2012 10:36:15 GMT | 05/25/2012 03:36:15 AM | OLDFILE575146 V 0 2963300A00.pdf | A ECO-R179932
Get file attachment | Deirdre Smyth | 05/11/2012 10:51:29 GMT | 05/11/2012 11:51:29 AM | OLDFILE575146 V 0 2963300A00.pdf | A ECO-R179932
Get file attachment | Michael Feeney | 04/27/2012 13:19:31 GMT | 04/27/2012 02:19:31 PM | OLDFILE597544 V 0 2963300A00.pdf | A ECO-R179932

## Page 14 of

Get file attachment | Martin Walsh | 04/27/2012 10:37:21 GMT | 04/27/2012 11:37:21 AM | OLDFILE597544 V 0 2963300A00.pdf | A ECO-R179932
Get file attachment | Patricia Smith | 04/17/2012 07:20:34 GMT | 04/17/2012 08:20:34 AM | OLDFILE575146 V 0 2963300A00.pdf | A ECO-R179932
Get file attachment | Nikhil Mankar | 03/27/2012 08:57:15 GMT | 03/27/2012 01:57:15 AM | OLDFILE575146 V 0 2963300A00.pdf | A ECO-R179932
Get file attachment | Nikhil Mankar | 03/27/2012 08:57:14 GMT | 03/27/2012 01:57:14 AM | OLDFILE597544 V 0 2963300A00.pdf | A ECO-R179932
Get file attachment | Sean Foley | 02/20/2012 11:34:24 GMT | 02/20/2012 11:34:24 AM | OLDFILE575146 V 0 2963300A00.pdf | A ECO-R179932
Get file attachment | Louise Murphy | 11/28/2011 11:47:07 GMT | 11/28/2011 05:47:07 AM | OLDFILE575146 V 0 2963300A00.pdf | A ECO-R179932
Get file attachment | Dara O'Connor | 11/28/2011 08:19:34 GMT | 11/28/2011 08:19:34 AM | OLDFILE575146 V 0 2963300A00.pdf | A ECO-R179932
Get file attachment | Padraic Murphy | 11/25/2011 13:20:51 GMT | 11/25/2011 01:20:51 PM | OLDFILE575146 V 0 2963300A00.pdf | A ECO-R179932
Get file attachment | Padraic Murphy | 11/25/2011 13:19:18 GMT | 11/25/2011 01:19:18 PM | OLDFILE575146 V 0 2963300A00.pdf | A ECO-R179932
Get file attachment | Thomas Stenson | 11/25/2011 12:15:01 GMT | 11/25/2011 12:15:01 PM | OLDFILE575146 V 0 2963300A00.pdf | A ECO-R179932
Get file attachment | Deirdre Smyth | 11/25/2011 10:49:46 GMT | 11/25/2011 10:49:46 AM | OLDFILE575146 V 0 2963300A00.pdf | A ECO-R179932
Get file attachment | Tommy Duggan | 11/24/2011 17:24:49 GMT | 11/24/2011 05:24:49 PM | OLDFILE575146 V 0 2963300A00.pdf | A ECO-R179932
View file attachment | Deirdre Smyth | 09/21/2011 11:29:12 GMT | 09/21/2011 06:29:12 AM | OLDFILE575146 V 0 2963300A00.pdf | A ECO-R179932
View file attachment | Thomas Stenson | 09/12/2011 13:08:12 GMT | 09/12/2011 02:08:12 PM | OLDFILE575146 V 0 2963300A00.pdf | A ECO-R179932
Get file attachment | John Berry | 08/11/2011 14:35:24 GMT | 08/11/2011 03:35:24 PM | OLDFILE575146 V 0 2963300A00.pdf | A ECO-R179932
Get file attachment | Enda Horrigan | 08/10/2011 12:41:23 GMT | 08/10/2011 01:41:23 PM | OLDFILE575146 V 0 2963300A00.pdf | A ECO-R179932
Get file attachment | John Berry | 08/02/2011 09:00:06 GMT | 08/02/2011 10:00:06 AM | OLDFILE575146 V 0 2963300A00.pdf | A ECO-R179932
Get file attachment | John Berry | 07/21/2011 11:29:41 GMT | 07/21/2011 06:29:41 AM | OLDFILE575146 V 0 2963300A00.pdf | A ECO-R179932
Get file attachment | John Berry | 07/21/2011 11:12:32 GMT | 07/21/2011 06:12:32 AM | OLDFILE597544 V 0 2963300A00.pdf | A ECO-R179932
Get file attachment | John Berry | 07/21/2011 11:08:59 GMT | 07/21/2011 06:08:59 AM | OLDFILE575146 V 0 2963300A00.pdf | A ECO-R179932
Get file attachment | Elizabeth - RSP BOU Malo | 07/11/2011 22:48:04 GMT | 07/11/2011 10:48:04 PM | approved rev A | A ECO-R179932
Get file attachment | Elizabeth - RSP BOU Malo | 07/11/2011 22:43:18 GMT | 07/11/2011 10:43:18 PM | approved rev A | A ECO-R179932
Get file attachment | Thomas - RSP GAL Stenson | 06/27/2011 14:19:41 GMT | 06/27/2011 03:19:40 PM | approved rev A | A ECO-R179932
Get file attachment | Rajiv - RSP GAL Kumar | 06/24/2011 08:17:40 GMT | 06/24/2011 03:17:40 PM | approved rev A | A ECO-R179932
Get file attachment | John - RSP GAL Berry | 06/01/2011 15:56:55 GMT | 06/01/2011 10:56:55 PM | approved rev A | A ECO-R179932
Get file attachment | Adam - RSP GOS Pearce | 02/15/2011 09:10:55 GMT | 02/15/2011 03:10:55 PM | approved rev A | A ECO-R179932
View file attachment | Adam - RSP GOS Pearce | 02/15/2011 09:10:25 GMT | 02/15/2011 03:10:25 PM | approved rev A | A ECO-R179932
Open file attachment | Chris - RSP BOU Vogel | 12/08/2010 16:21:42 GMT | 12/08/2010 03:21:41 PM | approved rev A | A ECO-R179932
Get file attachment | Pat - RSP GAL Finn | 11/25/2010 11:56:02 GMT | 11/25/2010 05:56:02 PM | approved rev A | A ECO-R179932
Get file attachment | Andrew - RSP BOU Gano | 10/19/2010 22:51:28 GMT | 10/19/2010 10:51:28 PM | proposed rev A | A ECO-R179932
Get file attachment | Sean - RSP GAL Knight | 10/14/2010 17:08:23 GMT | 10/15/2010 12:08:23 AM | approved rev A | A ECO-R179932
Get file attachment | Dara - RSP GAL O'Connor | 10/04/2010 10:09:37 GMT | 10/04/2010 05:09:37 PM | approved rev A | A ECO-R179932
Get file attachment | Tom - RSP GAL Tuohy | 09/29/2010 13:46:45 GMT | 09/29/2010 08:46:45 PM | proposed rev A | A ECO-R179932
View file attachment | Tom - RSP GAL Tuohy | 09/29/2010 13:46:29 GMT | 09/29/2010 08:46:29 PM | approved rev A | A ECO-R179932
Get file attachment | Tom - RSP GAL Tuohy | 09/29/2010 13:43:25 GMT | 09/29/2010 08:43:25 PM | proposed rev A | A ECO-R179932
View file attachment | Sean - RSP GAL Knight | 09/22/2010 12:18:59 GMT | 09/22/2010 07:19:00 PM | approved rev A | A ECO-R179932

## Page 15 of

Get file attachment | Sean - RSP GAL Knight | 09/22/2010 12:18:52 GMT | 09/22/2010 07:18:53 PM | approved rev A | A ECO-R179932
Get file attachment | Sean - RSP GAL Knight | 09/22/2010 12:18:39 GMT | 09/22/2010 07:18:40 PM | approved rev A | A ECO-R179932
Get file attachment | Tony - RSP GAL Naughton | 09/14/2010 23:18:32 GMT | 09/15/2010 12:18:32 AM | approved rev A | A ECO-R179932
Get file attachment | Tony - RSP GAL Naughton | 09/14/2010 23:18:20 GMT | 09/15/2010 12:18:20 AM | approved rev A | A ECO-R179932
Get file attachment | Deirdre - RSP GAL Smyth | 09/14/2010 13:59:01 GMT | 09/14/2010 08:59:01 PM | approved rev A | A ECO-R179932
Get file attachment | Niall - RSP GAL Meenaghan | 09/09/2010 13:52:41 GMT | 09/09/2010 08:52:41 PM | approved rev A | A ECO-R179932
Get file attachment | Dara - RSP GAL O'Connor | 09/08/2010 12:32:34 GMT | 09/08/2010 07:32:34 PM | approved rev A | A ECO-R179932
Get file attachment | Sean - RSP GAL Knight | 09/08/2010 11:34:07 GMT | 09/08/2010 06:34:07 PM | approved rev A | A ECO-R179932
Get file attachment | Michael - RSP GAL Feeney | 09/08/2010 08:42:10 GMT | 09/08/2010 03:42:10 PM | approved rev A | A ECO-R179932
Get file attachment | Sean - RSP GAL Knight | 09/08/2010 08:19:14 GMT | 09/08/2010 03:19:15 PM | approved rev A | A ECO-R179932
Get file attachment | Michael - RSP GAL Feeney | 09/07/2010 12:40:16 GMT | 09/07/2010 07:40:16 PM | approved rev A | A ECO-R179932
Get file attachment | Niall - RSP GAL Meenaghan | 09/01/2010 15:10:52 GMT | 09/01/2010 10:10:52 PM | approved rev A | A ECO-R179932
Get file attachment | Deirdre - RSP GAL Smyth | 08/25/2010 14:15:41 GMT | 08/25/2010 09:15:41 PM | approved rev A | A ECO-R179932
Get file attachment | Niall - RSP GAL Meenaghan | 08/11/2010 11:55:59 GMT | 08/11/2010 06:55:59 PM | approved rev A | A ECO-R179932
Get file attachment | Niall - RSP GAL Meenaghan | 08/11/2010 11:47:40 GMT | 08/11/2010 06:47:40 PM | approved rev A | A ECO-R179932
Get file attachment | Sean - RSP GAL Knight | 08/11/2010 11:04:51 GMT | 08/11/2010 06:04:50 PM | approved rev A | A ECO-R179932
Get file attachment | Deirdre - RSP GAL Smyth | 08/10/2010 15:35:50 GMT | 08/10/2010 10:35:50 PM | approved rev A | A ECO-R179932
Get file attachment | Deirdre - RSP GAL Smyth | 08/10/2010 15:32:34 GMT | 08/10/2010 10:32:34 PM | approved rev A | A ECO-R179932
Get file attachment | Sean - RSP GAL Knight | 08/09/2010 15:38:57 GMT | 08/09/2010 10:38:57 PM | approved rev A | A ECO-R179932
Get file attachment | Sean - RSP GAL Knight | 07/23/2010 13:54:27 GMT | 07/23/2010 08:54:27 PM | approved rev A | A ECO-R179932
Get file attachment | Brian - RSP GAL Keenan | 07/12/2010 11:55:49 GMT | 07/12/2010 06:55:49 PM | approved rev A | A ECO-R179932
Get file attachment | Martin - RSP GAL Gargiulo | 06/18/2010 11:34:45 GMT | 06/18/2010 06:34:45 PM | approved rev A | A ECO-R179932
Get file attachment | Mairead - RSP GAL Kilbane | 06/09/2010 09:58:23 GMT | 06/09/2010 04:58:23 PM | approved rev A | A ECO-R179932
Get file attachment | Martin - RSP GAL Gargiulo | 06/01/2010 08:54:24 GMT | 06/01/2010 03:54:24 PM | approved rev A | A ECO-R179932
Get file attachment | Martin - RSP GAL Gargiulo | 06/01/2010 08:44:30 GMT | 06/01/2010 03:44:30 PM | approved rev A | A ECO-R179932
Get file attachment | Deirdre - RSP GAL Smyth | 05/19/2010 08:45:55 GMT | 05/19/2010 03:45:55 PM | approved rev A | A ECO-R179932
Get file attachment | Deirdre - RSP GAL Smyth | 05/19/2010 07:55:21 GMT | 05/19/2010 02:55:21 PM | approved rev A | A ECO-R179932
Get file attachment | Deirdre - RSP GAL Smyth | 05/19/2010 07:48:34 GMT | 05/19/2010 02:48:34 PM | approved rev A | A ECO-R179932
Get file attachment | Deirdre - RSP GAL Smyth | 05/19/2010 07:41:55 GMT | 05/19/2010 02:41:55 PM | approved rev A | A ECO-R179932
Get file attachment | Michael - RSP GAL Duggan | 05/07/2010 10:25:23 GMT | 05/07/2010 05:25:23 PM | approved rev A | A ECO-R179932
Get file attachment | Deirdre - RSP GAL Smyth | 05/05/2010 12:51:37 GMT | 05/05/2010 07:51:37 PM | approved rev A | A ECO-R179932
Get file attachment | Siobhán - RSP GAL McGrath | 05/04/2010 13:58:34 GMT | 05/04/2010 08:58:34 PM | approved rev A | A ECO-R179932
Get file attachment | Siobhán - RSP GAL McGrath | 05/04/2010 13:40:27 GMT | 05/04/2010 08:40:27 PM | proposed rev A | A ECO-R179932
Get file attachment | Sean - RSP GAL Sidley | 04/23/2010 10:30:49 GMT | 04/23/2010 05:30:49 PM | approved rev A | A ECO-R179932
Get file attachment | Sean - RSP GAL Sidley | 04/20/2010 11:57:07 GMT | 04/20/2010 06:57:07 PM | approved rev A | A ECO-R179932
Get file attachment | Sean - RSP GAL Sidley | 03/19/2010 09:19:18 GMT | 03/19/2010 03:19:18 PM | approved rev A | A ECO-R179932
Get file attachment | Patricia - RSP GAL Mooney | 03/16/2010 18:23:17 GMT | 03/17/2010 12:23:17 AM | approved rev A | A ECO-R179932
Get file attachment | Sean - RSP GAL Sidley | 03/09/2010 08:59:58 GMT | 03/09/2010 02:59:58 PM | approved rev A | A ECO-R179932
Get file attachment | Niamh - RSP GAL Healy | 02/18/2010 15:45:54 GMT | 02/18/2010 09:45:54 PM | approved rev A | A ECO-R179932
Get file attachment | Martin - RSP GAL Gargiulo | 02/16/2010 16:55:04 GMT | 02/16/2010 10:55:04 PM | approved rev A | A ECO-R179932
Get file attachment | Martin - RSP GAL Gargiulo | 02/08/2010 15:31:43 GMT | 02/08/2010 09:31:43 PM | proposed rev A | A ECO-R179932
Get file attachment | Sean - RSP GAL Sidley | 02/02/2010 11:36:03 GMT | 02/02/2010 05:36:03 PM | approved rev A | A ECO-R179932
Get file attachment | Sean - RSP GAL Sidley | 02/02/2010 11:35:35 GMT | 02/02/2010 05:35:35 PM | approved rev A | A ECO-R179932
Get file attachment | Martina - RSP GAL O'Connor | 01/20/2010 15:11:20 GMT | 01/20/2010 09:11:20 PM | approved rev A | A ECO-R179932
Open file attachment | Martin - RSP GAL Gargiulo | 01/19/2010 15:46:21 GMT | 01/19/2010 09:46:21 PM | approved rev A | A ECO-R179932
Get file attachment | Martina - RSP GAL O'Connor | 01/14/2010 14:59:58 GMT | 01/14/2010 08:59:58 PM | approved rev A | A ECO-R179932
Incorporate | Martina - RSP GAL O'Connor | 01/14/2010 12:10:08 GMT | 01/14/2010 06:10:08 PM | | (A)
Get file attachment | Matthew - RSP GAL O'Neill | 01/14/2010 11:55:39 GMT | 01/14/2010 05:55:39 PM | approved rev A | (A) ECO-R179932
Get file attachment | Martina - RSP GAL O'Connor | 01/14/2010 11:24:06 GMT | 01/14/2010 05:24:06 PM | approved rev A | (A) ECO-R179932

## Page 16 of

Get file attachment | Martin - RSP GAL Gargiulo | 01/14/2010 09:27:40 GMT | 01/14/2010 03:27:40 PM | approved rev A | (A) ECO-R179932
Get file attachment | Martin - RSP GAL Gargiulo | 01/14/2010 09:23:35 GMT | 01/14/2010 03:23:35 PM | approved rev A | (A) ECO-R179932
Get file attachment | Martin - RSP GAL Gargiulo | 01/14/2010 09:23:12 GMT | 01/14/2010 03:23:12 PM | proposed rev A | (A) ECO-R179932
Add file attachment | Matthew - RSP GAL O'Neill | 01/11/2010 08:29:29 GMT | 01/11/2010 02:29:29 PM | approved rev A | (A) ECO-R179932
Get file attachment | Matthew - RSP GAL O'Neill | 01/08/2010 10:02:20 GMT | 01/08/2010 04:02:20 PM | proposed rev A | (A) ECO-R179932
Get file attachment | Matthew - RSP GAL O'Neill | 01/08/2010 08:28:58 GMT | 01/08/2010 02:28:58 PM | proposed rev A | (A) ECO-R179932
Unincorporate | Martina - RSP GAL O'Connor | 01/07/2010 15:18:16 GMT | 01/07/2010 09:18:16 PM | | (A)
Get file attachment | Paul - RSP GAL Sherlock | 01/07/2010 13:57:56 GMT | 01/07/2010 07:57:56 PM | proposed rev A | (A) ECO-R179932
Get file attachment | Nicolas - RSP GAL Richard | 01/07/2010 10:54:06 GMT | 01/07/2010 04:54:07 PM | proposed rev A | (A) ECO-R179932
View file attachment | Nicolas - RSP GAL Richard | 01/07/2010 10:53:55 GMT | 01/07/2010 04:53:56 PM | proposed rev A | 00 ECO-R163956
Get file attachment | Martin - RSP GAL Gargiulo | 01/06/2010 12:19:58 GMT | 01/06/2010 06:19:58 PM | proposed rev A | (A) ECO-R179932
Get file attachment | Derek - RSP GAL Kelly | 01/04/2010 09:49:54 GMT | 01/04/2010 03:49:54 PM | proposed rev A | (A) ECO-R179932
Get file attachment | Matthew - RSP GAL O'Neill | 12/31/2009 10:24:40 GMT | 12/31/2009 04:24:40 PM | proposed rev A | (A) ECO-R179932
Get file attachment | Caroline - RSP GAL Greaney | 12/23/2009 14:16:41 GMT | 12/23/2009 08:16:41 PM | proposed rev A | (A) ECO-R179932
Get file attachment | Derek - RSP GAL Wynne | 12/23/2009 12:52:19 GMT | 12/23/2009 06:52:19 PM | proposed rev A | (A) ECO-R179932
Get file attachment | Derek - RSP GAL Wynne | 12/23/2009 12:41:49 GMT | 12/23/2009 06:41:49 PM | proposed rev A | (A) ECO-R179932
Get file attachment | Tommy - RSP GAL Duggan | 12/23/2009 12:18:02 GMT | 12/23/2009 06:18:02 PM | proposed rev A | (A) ECO-R179932
Incorporate | Martina - RSP GAL O'Connor | 12/23/2009 11:21:37 GMT | 12/23/2009 05:21:38 PM | | (A)
Get file attachment | Martin - RSP GAL Gargiulo | 12/23/2009 10:24:48 GMT | 12/23/2009 04:24:48 PM | proposed rev A | (A) ECO-R179932
Get file attachment | Gearoid - RSP GAL Roche | 12/21/2009 09:34:55 GMT | 12/21/2009 03:34:55 PM | proposed rev A | (A) ECO-R179932
Get file attachment | Michael - RSP GAL Feeney | 12/18/2009 14:24:18 GMT | 12/18/2009 08:24:18 PM | proposed rev A | (A) ECO-R179932
Get file attachment | Martina - RSP GAL O'Connor | 12/18/2009 13:51:03 GMT | 12/18/2009 07:51:03 PM | proposed rev A | (A) ECO-R179932
Add file attachment | Matthew - RSP GAL O'Neill | 12/18/2009 10:49:26 GMT | 12/18/2009 04:49:26 PM | proposed rev A | (A) ECO-R179932
Remove file attachment | Matthew - RSP GAL O'Neill | 12/18/2009 10:41:39 GMT | 12/18/2009 04:41:39 PM | proposed rev A | (A) ECO-R179932
Add file attachment | Matthew - RSP GAL O'Neill | 12/18/2009 10:41:20 GMT | 12/18/2009 04:41:20 PM | proposed rev A | (A) ECO-R179932
Print Tab | Elizabeth - RSP CB Mladenik | 11/12/2008 00:18:49 GMT | 11/11/2008 10:18:49 PM | Manufacturers
Get file attachment | Francis - RSP PAU Labadesse | 07/30/2008 14:40:46 GMT | 07/30/2008 01:40:46 PM | Proposed Rev A | (A) ECO-R168700
Get file attachment | Claude - RSP PAU Andrieux | 07/29/2008 12:38:26 GMT | 07/29/2008 11:38:26 AM | Proposed Rev A | (A) ECO-R168700
Get file attachment | Michael - RSP GAL Duggan | 07/29/2008 08:46:51 GMT | 07/29/2008 03:46:51 PM | Proposed Rev A | (A) ECO-R168700
View file attachment | Declan - RSP GAL McKinney | 07/29/2008 08:34:46 GMT | 07/29/2008 03:34:45 PM | Proposed Rev A | 00 ECO-R163956
Modify | Liam - RSP GAL Curley | 07/29/2008 08:32:45 GMT | 07/29/2008 03:32:45 PM | <Part Attributes.Item Class: BPCS Add-Updt> WAS <GL-48>; IS <GL-66> | (A) ECO-R168700
View file attachment | Declan - RSP GAL McKinney | 07/29/2008 07:58:00 GMT | 07/29/2008 02:58:00 PM | Proposed Rev A | 00 ECO-R163956
Get file attachment | Declan - RSP GAL McKinney | 07/29/2008 07:55:49 GMT | 07/29/2008 02:55:49 PM | Proposed Rev A | (A) ECO-R168700
Get file attachment | Claude - RSP PAU Andrieux | 07/29/2008 07:22:56 GMT | 07/29/2008 06:22:56 AM | Proposed Rev A | (A) ECO-R168700
Get file attachment | Claude - RSP PAU Andrieux | 07/29/2008 07:18:59 GMT | 07/29/2008 06:18:59 AM | Proposed Rev A | (A) ECO-R168700
View file attachment | Claude - RSP PAU Andrieux | 07/29/2008 07:18:41 GMT | 07/29/2008 06:18:41 AM | Proposed Rev A | 00 ECO-R163956
View file attachment | Darlene - RSP BOU Johnson | 07/28/2008 19:23:42 GMT | 07/28/2008 07:23:40 PM | Proposed Rev A | (A) ECO-R168700
Incorporate | Darlene - RSP BOU Johnson | 07/28/2008 19:23:41 GMT | 07/28/2008 07:23:39 PM | | (A)
Get file attachment | Donal - RSP CB Nolan | 07/25/2008 19:15:54 GMT | 07/25/2008 06:15:54 PM | Proposed Rev A | (A) ECO-R168700
Get file attachment | Michael - RSP GAL Duggan | 07/25/2008 10:53:09 GMT | 07/25/2008 05:53:09 PM | Proposed Rev A | (A) ECO-R168700
Get file attachment | Fabien - RSP PAU Cotteaux | 07/25/2008 09:22:32 GMT | 07/25/2008 08:22:32 AM | Proposed Rev A | (A) ECO-R168700
Get file attachment | Gearoid - RSP GAL Roche | 07/25/2008 08:02:00 GMT | 07/25/2008 03:02:00 PM | Proposed Rev A | (A) ECO-R168700
Get file attachment | Kenneth - RSP GAL Burke | 07/25/2008 08:00:20 GMT | 07/25/2008 03:00:20 PM | Proposed Rev A | (A) ECO-R168700
Get file attachment | Kenneth - RSP GAL Burke | 07/25/2008 07:57:45 GMT | 07/25/2008 02:57:45 PM | Proposed Rev A | (A) ECO-R168700
Get file attachment | Francis - RSP PAU Labadesse | 07/25/2008 06:40:54 GMT | 07/25/2008 05:40:54 AM | Proposed Rev A | (A) ECO-R168700
Open file attachment | Susan - RSP BOU Heuman | 07/24/2008 22:27:59 GMT | 07/24/2008 10:27:59 PM | Proposed Rev A | (A) ECO-R168700

## Page 17 of

Get file attachment | Gabe - RSP CB Sanchez | 07/24/2008 19:57:10 GMT | 07/24/2008 06:57:11 PM | Proposed Rev A | (A) ECO-R168700
Add file attachment | Bijal - RSP CB Patel | 07/24/2008 19:10:18 GMT | 07/24/2008 06:10:18 PM | Proposed Rev A | (A) ECO-R168700
Modify | Shirley - RSP BOU Reed | 05/21/2008 16:33:13 GMT | 05/21/2008 04:33:13 PM | <Part Attributes.Owning Site: Agile Only> WAS <PLEASANTON>; IS <BOULDER> | 00 ECO-R163956
Modify | Shirley - RSP BOU Reed | 05/21/2008 16:33:13 GMT | 05/21/2008 04:33:13 PM | <Part Attributes.Country of Origin: BPCS Add> WAS <FR>; IS <FR = FRANCE> | 00 ECO-R163956
Print Tab | Pauline - RSP GAL Coyne | 09/27/2007 13:43:36 GMT | 09/27/2007 08:43:36 PM | Manufacturers
Incorporate | Mary - RSP GAL Loftus-Burke | 08/27/2007 08:13:20 GMT | 08/27/2007 03:13:20 PM | | (00)
Modify | Martin - RSP GAL Gargiulo | 08/03/2007 07:43:16 GMT | 08/03/2007 02:43:16 PM | <Title Block.Part Description> WAS <TBD>; IS <ELECTRIC FILTER WITH FOAM> | (00) ECO-R163956
Modify | Martin - RSP GAL Gargiulo | 07/31/2007 09:05:29 GMT | 07/31/2007 04:05:29 PM | <Additional Info.Notes> WAS <NULL>; IS <AIROX AML> | (AML) ECO-R162955
Create | Paul - RSP PLS Keller | 05/11/2007 16:58:19 GMT | 05/11/2007 03:58:19 PM

## Page 18 of
