darwinbeing/PB560/pb560-vent-files-4/Purchased Part Drawings/10073069/10073069D00.docx

NOTES: UNLESS OTHERWISE SPECIFIED.

1. APPLICABLE STANDARDS/SPECIFICATIONS:

ASME Y14.3-2012, ORTHOGRAPHIC AND PICTORIAL VIEWS.

ASME Y14.5-2009, DIMENSIONS AND TOLERANCES.

ASME Y14.38.-2013, ABBREVIATIONS AND ACRONYMS.

2. ALL DIMENSIONS ARE IN MILLIMETERS.
3. MATERIAL: 125 MICRONS MATTE POLYCARBONATE (LEXAN 8B35) SUBSURFACE PRINT.
4. COLOR/TINTS: BLACK PANTONE 2C, COOL GREY PANTONE 6C.
5. ADHESIVE: PRESSURE SENSITIVE ADHESIVE (3M467)
6. SCREEN PRINTING PER ARTWORK 10073068 REV D. ARTWORK FOR REFERENCE ONLY.
7. PRINT AS PER LOCAL MANUFACTURING PROCEDURES. CENTER ARTWORK ON LABEL.
8. ALCOHOL RESISTANT INK.
9. PART/COMPONENT TO BE RoHS COMPLIANT.

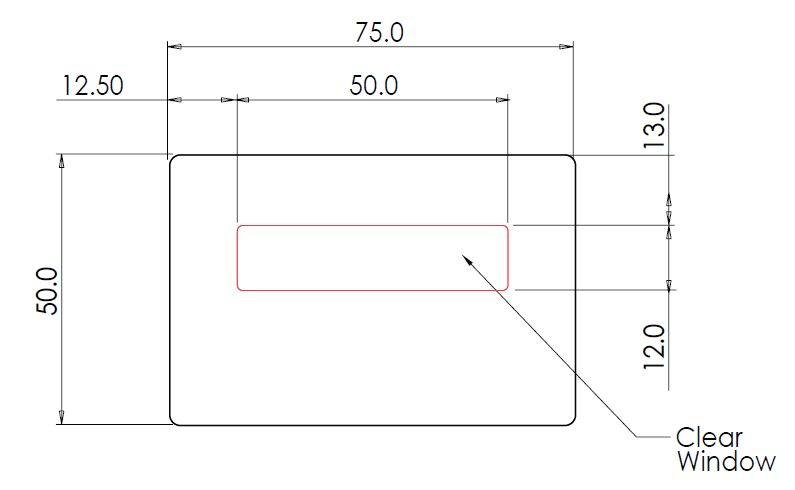
[picture p15: figure]

COVIDIEN 6135 Gunbarrel Avenue Boulder, CO 80301 ã 2016 COVIDIEN ALL RIGHTS RESERVED. TITLE: LABEL,560 PRODUCT LABEL, 4096600 A DRAWING NUMBER 10073069 SHEET 2 of 2 REV D PROPRIETARY & CONFIDENTIAL: THIS DOCUMENT MAY NOT BE COPIED, DISCLOSED, OR USED IN WHOLE OR IN PART WITHOUT THE CONSENT OF COVI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

PROPRIETARY & CONFIDENTIAL: THIS DOCUMENT MAY NOT BE COPIED, DISCLOSED, OR USED IN WHOLE OR IN PART WITHOUT THE CONSENT OF COVIDIEN TITLE: COVIDIEN LABEL,560 PRODUCT LABEL, 4096600 6135 Gunbarrel Avenue Boulder, Colorado 80301 GENERAL DIMENSIONAL TOLERANCES © 2016 COVIDIEN ALL RIGHTS RESERVED. DEC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

REVISIONS REV DESCRIPTION D RELEASE/CHANGE PER EC037804
