darwinbeing/PB560/pb560-vent-files-4/BOM Drawings/PB560 Ventilator/10073069D00.pdf

## REVISIONS

REV | DESCRIPTION
D | RELEASE/CHANGE PER EC037804

PROPRIETARY & CONFIDENTIAL: THIS DOCUMENT MAY NOT BE COPIED, DISCLOSED, OR USED IN WHOLE OR IN PART WITHOUT THE CONSENT OF COVIDIEN
TITLE: | COVIDIEN

### LABEL,560 PRODUCT LABEL, 4096600

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

GENERAL DIMENSIONAL TOLERANCES | © 2 0 1 6 C O V I D I E N A L L R I G H T S R E S E R V E D .
DEC. | DEC. | DEC. | DRAWN: DATE: 1/27/16 | SIZE | DRAWING NUMBER | REV.
.X ± | .XX ± | .XXX ± | CHECKED: SEE AGILE DATE: SEE AGILE | A | 10073069 | D
0.25 | .2 | N/A | APPROVED: SEE AGILE DATE: SEE AGILE | SCALE: NTS | SHEET 1 OF 2

Template 10026665 Rev B

NOTES: UNLESS OTHERWISE SPECIFIED.

## 1. APPLICABLE STANDARDS/SPECIFICATIONS:

ASME Y14.3-2012, ORTHOGRAPHIC AND PICTORIAL VIEWS. ASME Y14.5-2009, DIMENSIONS AND TOLERANCES.
ASME Y14.38.-2013, ABBREVIATIONS AND ACRONYMS.
2. ALL DIMENSIONS ARE IN MILLIMETERS.

## 3. MATERIAL: 125 MICRONS MATTE POLYCARBONATE (LEXAN 8B35)

SUBSURFACE PRINT.

4. COLOR/TINTS: BLACK PANTONE 2C, COOL GREY PANTONE 6C.

## 5. ADHESIVE: PRESSURE SENSITIVE ADHESIVE (3M467)

## 6. SCREEN PRINTING PER ARTWORK 10073068 REV D. ARTWORK FOR

REFERENCE ONLY.

7. PRINT AS PER LOCAL MANUFACTURING PROCEDURES. CENTER ARTWORK ON LABEL.
8. ALCOHOL RESISTANT INK.
9. PART/COMPONENT TO BE RoHS COMPLIANT.

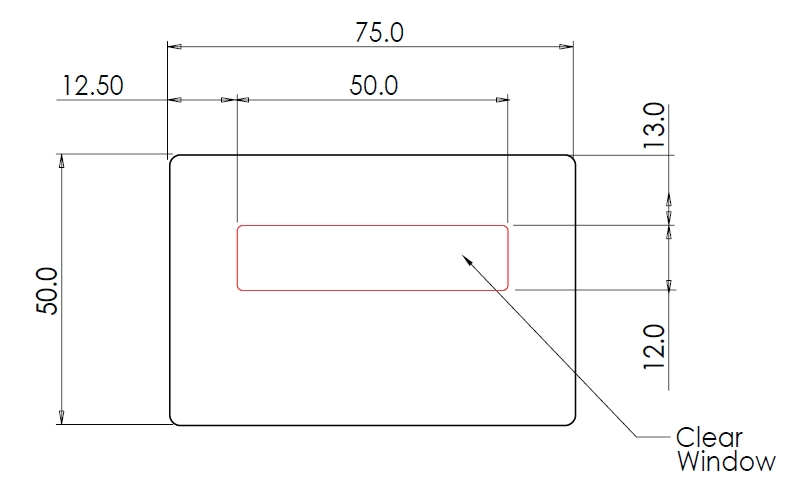
[picture p21: figure]

### COVIDIEN

6135 Gunbarrel Avenue
Boulder, CO 80301
ã 2016 COVIDIEN ALL RIGHTS RESERVED.

TITLE:
LABEL,560 PRODUCT LABEL,
4096600

A

DRAWING NUMBER
10073069

SHEET 2 of 2

REV
D

PROPRIETARY & CONFIDENTIAL: THIS DOCUMENT MAY NOT BE COPIED, DISCLOSED, OR USED IN WHOLE OR IN PART WITHOUT THE CONSENT OF COVIDIEN.
Template 10026665 Rev B
