darwinbeing/PB560/pb560-vent-files-4/BOMS/4096600 - PB560 Ventilator.xls

Level | Bubble Number | Item Number | Item Description | Item Rev | Qty | UOM | Item Lifecycle Phase | Ref Des | Subclass | Sites | Preferred Status
1 | 1 | PT00100434 | PRINT SPEC, LABEL, CARTON, PB560 | A EC116124 | 2 | Each | Production |  | Part | GYRM
2 | 10 | 10053480 | 7.87" [200 MM] X 3.94" [100 MM] BLANK LABEL ROLL STOCK | B MC010040 | 1 | Each | Production |  | Part | GYRM | Preferred
2 | 20 | DC00102634 | ARTWORK, SHIPPING LABEL, PB560 | A EC116124 | 0 |  | Production |  | Document | GYRM
1 | 2 | 10002231 | LABEL, BATTERY CHARGE DATE, LEGENDAIR, XL2 | A MC007914 | 1 | Each | Production |  | Part | GYRM | Preferred
1 | 3 | PT00098355 | LABEL, PB 540, CLASS 9 UN 3481 | A EC119189 | 1 | Each | Production |  | Part | GYRM | Preferred
1 | 4 | 10047943 | OUTER SHIPPING CARTON 15.83" X 13.07" X 15.43" | A ECO-R219449 | 1 | Each | Production |  | Part | GYRM | Preferred
1 | 5 | 2962700 | O2 FITTING MALE | A ECO-R223442 | 1 | Each | Production |  | Part | GYRM | Preferred
1 | 6 | 10106588 | PB560 PORTABLE VENTILATOR | H EC123596 | 1 | Each | Production |  | Part | GYRM | Preferred
2 | 10 | 10029086 | LOW STATIC POLYIMIDE FILM TAPE, REF: 5419 | C ECO-R252636 | 0 | Millimeter | Production |  | Part | GYRM | Preferred
2 | 11 | 2969500 | SILICONE TUBING DIAMETER 3.2 ID | 01 ECO-R219109 | .82 | Meter | Production |  | Part | GYRM | Preferred
2 | 12 | 2969600 | SILICONE TUBING DIAMETER 1.6X4.8 | A ECO-R224023 | .47 | Meter | Production |  | Part | GYRM | Alternate
2 | 13 | 10038115 | SILICONE TUBING DIAMETER 15X21 | A ECO-R222677 | 0.062 | Meter | Production |  | Part | GYRM | Preferred
2 | 14 | 2970400 | T-SHAPED CONNECTOR 2.4 PLASTIC | A ECO-R224891 | 1 | Each | Production |  | Part | GYRM | Preferred
2 | 15 | 2970300 | STRAIGHT CONNECTOR 2.4X3.2 PLASTIC | A ECO-R224891 | 1 | Each | Production |  | Part | GYRM | Preferred
2 | 16 | 2966800 | POLYAMIDE TUBING 6X4(0.2) | 02 ECO-R217722 | .200 | Meter | Production |  | Part | GYRM | Preferred
2 | 20 | 3832100 | SOFTWARE REFERENCE DRAWING PB540 POWER SUPPLY | F ECO-R196247 | 1 | Each | Production |  | Part | GYRM
2 | 21 | 10079556 | CONICAL FITTING, INSPIRATORY MODULE, PB560 | B ECO-R214792 | 1 | Each | Production |  | Part | GYRM | Preferred
2 | 22 | 10038094 | LABEL, INSPIRATORY FIO2, PB560 | B01 ECO-R214654 | 1 | Each | Production |  | Part | GYRM
3 | 0 | 10046719 | PB560, ARTWORK, INSPIRATORY FIO2 LABEL | A ECO-R256379 | 1 |  | Production |  | Document | BDRM
2 | 23 | 10038096 | LABEL, EXHAL. VALVE, PROX PRESSURE, PB560 | A01 ECO-R214654 | 1 | Each | Production |  | Part | GYRM
3 | 0 | 10038087 | PB560, ARTWORK, EXHAL VALVE / PROX PRESSURE LABEL | A ECO-R256379 | 1 |  | Production |  | Document | BDRM
2 | 24 | 3842600 | INTERNAL FIO2 CABLE RB 0505 | C ECO-R213924 | 1 | Each | Production |  | Part | GYRM
2 | 30 | 3835500 | USB FIRMWARE | A ECO-R171373 | 1 | Each | Production |  | Part | GYRM
2 | 31 | 3824300 | EXPIRATION BLOC | B ECO-R214792 | 1 | Each | Production |  | Part | GYRM | Preferred
2 | 32 | 10038095 | LABEL, EXPIRATORY SINGLE USE, PB560 | A01 ECO-R214654 | 1 | Each | Production |  | Part | GYRM
3 | 0 | 10038088 | PB560, ARTWORK, EXPIRATORY SINGLE USE LABEL | A ECO-R256379 | 1 |  | Production |  | Document | BDRM
2 | 33 | 3824200 | PB500 EXPIRATORY CONICAL FITTING SUPPORT | B ECO-R213924 | 1 | Each | Production |  | Part | GYRM
3 | 0 | 3808800 | EXPIRATORY CONICAL FITTING SUPPORT | A ECO-R234515 | 0 | Each | Production |  | Part | BDRM
2 | 34 | 2964000 | BAFFLE CONDUIT, FLUTED | A ECO-R223442 | 2 | Each | Production |  | Part | GYRM | Preferred
2 | 35 | 10038091 | LABEL, VALVE CONNECTION, PB560 | B01 ECO-R216094 | 1 | Each | Production |  | Part | GYRM | Preferred
3 | 0 | 10046718 | PB560, ARTWORK, VALVE CONNECTION LABEL | A ECO-R256379 | 1 |  | Production |  | Document | BDRM
2 | 41 | 3811100 | LABEL, PB 540, BATTERY ASSY. | A01 ECO-R215328 | 1 | Each | Production |  | Part | GYRM | Preferred
2 | 42 | 2966300 | ADHESIVE STOP DIAMETER 8 THICKNESS 2.2 | B ECO-R217722 | 6 | Each | Production |  | Part | GYRM | Alternate
2 | 43 | 3823900 | BATTERY COVER RB0505 | C ECO-R213924 | 1 | Each | Production |  | Part | GYRM
3 | 0 | 3822700 | BATTERY HOUSING LEGENDAIR | B ECO-R226884 | 0 | Each | Production |  | Part | BDRM | Preferred
2 | 44 | 10044547 | LABEL, PRODUCT, 520, 540, 560, O2 RA | A01 ECO-R216094 | 1 | Each | Production |  | Part | GYRM | Preferred
3 | 0 | 10044548 | A/W, LABEL, PRODUCT, 520, 560, O2 RA | A ECO-R256379 | 1 |  | Production |  | Document | CBRM
2 | 45 | 10004932 | LOWER HOUSING,R/A II,PB540/560 | C ECO-R214792 | 1 | Each | Production |  | Part | GYRM | Preferred
3 | 0 | 10000916 | LOWER HOUSING,R/A II,PB5X0 | B ECO-R214792 | 0 | Each | Production |  | Part | CBRM | Preferred
2 | 46 | 2973900 | SILICONE STOPPER | 00 ECO-R216078 | 2 | Each | Production |  | Part | GYRM | Preferred
2 | 51 | 2966100 | ZINC-PLATED STEEL TCB SCREW HEXALOBE M3X5 | A ECO-R224554 | 4 | Each | Production |  | Part | GYRM | Preferred
2 | 52 | 3812500 | SHIELDING PLATE MOTOR HARNESS | A ECO-R214584 | 1 | Each | Production |  | Part | GYRM | Preferred
2 | 53 | 10096315 | BLOWER DRIVER CARD | A ECO-R252633 | 1 | Each | Production |  | Part | GYRM | Preferred
3 | 0 | 10022135 | CAPACITOR CERAMIC, 100NF, +/-10%, 50V, X7R,0805 | C ECO-R252633 | 12 | Each | Production | C1,C3,C5,C6,C9,C12,C15,C19,C21,C24,C25,C26 | Part | CBRM | Preferred
3 | 0 | 10022506 | CAPACITOR,100UF,+/-20%,50V | E ECO-R252633 | 1 | Each | Production | C2 | Part | CBRM | Preferred
3 | 0 | 10022507 | CAPACITOR CERAMIC, 2.2NF, +/-10%,50V, X7R, 0603 | C ECO-R252633 | 4 | Each | Production | C7,C11,C14,C17 | Part | CBRM | Preferred
3 | 0 | 10022508 | CAPACITOR CERAMIC,10NF,+/-10%,50V,0603 | C ECO-R252633 | 2 | Each | Production | C8,C20 | Part | CBRM | Preferred
3 | 0 | 10022509 | CAPACITOR,220NF,+/-10% ,50V, X7R,1206 | C ECO-R252633 | 3 | Each | Production | C10,C13,C16 | Part | CBRM | Preferred
3 | 0 | 10022510 | CAPACITOR,330NF,+/-10%,16V,0805,X7R | C ECO-R252633 | 1 | Each | Production | C18 | Part | CBRM | Preferred
3 | 0 | 10022514 | DIODE ZENER, 3W-600W,30V,SMB | D EC103617 | 7 | Each | Production | D1,D18,D19,D20,D21,D22,D23 | Part | CBRM | Alternate
3 | 0 | 10022515 | DIODE SCHOTTKY, 500MA,40V,SOD323 | C ECO-R252633 | 6 | Each | Production | D2,D3,D4,D5,D6,D7 | Part | CBRM | Preferred
3 | 0 | 10022517 | DIODE ZENER, 15V, 500MW,SOD80 | C ECO-R252633 | 3 | Each | Production | D11,D12,D13 | Part | CBRM | Preferred
3 | 0 | 10022518 | DIODE SCHOTTKY, 200MA,30V,SOD23DIO | C ECO-R252633 | 4 | Each | Production | D14,D15,D16,D24 | Part | CBRM | Preferred
3 | 0 | 10022519 | DIODE SCHOTTKY, 15A, 45V,TO-252 | B ECO-R252633 | 1 | Each | Production | D17 | Part | CBRM | Preferred
3 | 0 | 10022531 | FUSE 5A + SUPPORT CMS | B ECO-R252633 | 1 | Each | Production | F1 | Part | CBRM | Preferred
3 | 0 | 10022533 | FILTER, 1K, 100MHZ, 0.8OHM, 50MA, 0603 | B ECO-R252633 | 7 | Each | Production | FI3,FI4,FI5,FI6,FI7,FI8,FI9 | Part | CBRM | Preferred
3 | 0 | 10022534 | IC BRUSHLESS DC MOTOR CONTROLLER | C ECO-R252633 | 1 | Each | Production | IC1 | Part | CBRM | Preferred
3 | 0 | 10022536 | RECTIFIER SINGLE CHANNEL DRIVER | C ECO-R252633 | 3 | Each | Production | IC3,IC4,IC5 | Part | CBRM | Preferred
3 | 0 | 10022537 | IC, VOLTAGE REGULATOR, 15V,500MA,DPACK | B ECO-R252633 | 1 | Each | Production | IC6 | Part | CBRM | Preferred
3 | 0 | 10022538 | CONNECTOR, 2 CONTACTS,MICROFIT 3.0 | B ECO-R252633 | 1 | Each | Production | J1 | Part | CBRM | Preferred
3 | 0 | 10022541 | COPPER WIRE, SWG20 DIA: 0.91 | B ECO-R252633 | 1 | Each | Production | J4 | Part | CBRM | Preferred
3 | 0 | 10022542 | CONNECTOR, O2 VALVE, 2 CONTACTS | C ECO-R252633 | 1 | Each | Production | J3 | Part | CBRM | Preferred
3 | 0 | 10022543 | CONNECTOR,8 CONTACTS, 2.54PIN PITCH | C ECO-R252633 | 1 | Each | Production | J6 | Part | CBRM | Preferred
3 | 0 | 10022547 | RESISTOR, 0.047 OHM, 1W, +/-5%,2512 | C ECO-R252633 | 1 | Each | Production | R1 | Part | CBRM | Preferred
3 | 0 | 10022549 | RESISTOR,100KOHM,0.063W,+/-1%,0603 | C ECO-R252633 | 3 | Each | Production | R3,R4,R7 | Part | CBRM | Preferred
3 | 0 | 10022550 | RESISTOR,680OHM, 0.063W, +/-1%,0603 | C ECO-R252633 | 3 | Each | Production | R6,R9,R10 | Part | CBRM | Preferred
3 | 0 | 10022555 | RESISTOR,0.1 OHM,1W,+/-5%,2512 | C ECO-R252633 | 1 | Each | Production | R40 | Part | CBRM | Preferred
3 | 0 | 10022558 | TRANSISTOR MOSFET, 30V, 0.93A, 0.25 OHM, N CHANNEL | B ECO-R252633 | 3 | Each | Production | T1,T8,T10 | Part | CBRM | Preferred
3 | 0 | 10022559 | TRANSISTOR MOSFET, 60V, 16.7A, N CHANNEL | B ECO-R252633 | 6 | Each | Production | T2,T3,T4,T5,T6,T7 | Part | CBRM | Preferred
3 | 0 | 10022561 | CAPACITOR TANTALUM,22UF,+/-10%,35V | D ECO-R252633 | 1 | Each | Production | C4 | Part | CBRM | Preferred
3 | 0 | 10022562 | DIODE SCHOTTKY, 1A, 200V,SMA | C ECO-R252633 | 3 | Each | Production | D8,D9,D10 | Part | CBRM | Preferred
3 | 0 | 10022924 | TEST POINT | B ECO-R252633 | 1 | Each | Production | PT1 | Part | CBRM | Preferred
3 | 0 | 10052305 | PCB CONNECTOR HE10, 10 PINS | B ECO-R252633 | 1 | Each | Production | J2 | Part | CBRM | Preferred
3 | 0 | 10095969 | CAPACITOR,470UF, +/-20%,25V | A ECO-R252633 | 1 | Each | Production | C27 | Part | CBRM | Preferred
3 | 0 | 10095970 | IC TIMER | A ECO-R252633 | 1 | Each | Production | IC2 | Part | CBRM | Preferred
3 | 0 | 10095971 | INDUCTOR 22UH,1.8-2A | A ECO-R252633 | 1 | Each | Production | L1 | Part | CBRM | Preferred
3 | 0 | 10095972 | TRANSISTOR MOSFET, 60V, 50A, P CHANNEL | A ECO-R255176 | 1 | Each | Production | T9 | Part | CBRM | Preferred
3 | 0 | 10095973 | CAPACITOR ARRAY, 47PF, 50V, +/-10%,NPO,0612 | A ECO-R252633 | 2 | Each | Production | C22,C23 | Part | CBRM | Preferred
3 | 0 | 10095974 | CAPACITOR,1000UF,+/-20%,35V | A ECO-R252633 | 2 | Each | Production | C28,C29 | Part | CBRM | Preferred
3 | 0 | 10095975 | RESISTOR,10K OHM.0.063W,+/-1%,0603 | A ECO-R252633 | 4 | Each | Production | R2,R5,R37,R42 | Part | CBRM | Preferred
3 | 0 | 10095977 | RESISTOR,4.7KOHM,0.063W,+/-1% | A ECO-R252633 | 1 | Each | Production | R8 | Part | CBRM | Preferred
3 | 0 | 10095979 | RESISTOR,100 OHM,0.063W,+/-1%, 0603 | A ECO-R252633 | 3 | Each | Production | R11,R12,R13 | Part | CBRM | Preferred
3 | 0 | 10095980 | RESISTOR, 10 OHM,0.063W, +/-1%, 0603 | A ECO-R252633 | 6 | Each | Production | R20,R30,R31,R32,R33,R35 | Part | CBRM | Preferred
3 | 0 | 10095981 | RESISTOR, 1K OHM, 0.063W,+/-1%, 0603 | A ECO-R252633 | 3 | Each | Production | R38,R39,R50 | Part | CBRM | Preferred
3 | 0 | 10095983 | RESISTOR, 22 K OHM,0.063W, +/-1%,0603 | A ECO-R252633 | 1 | Each | Production | R41 | Part | CBRM | Preferred
3 | 0 | 10095984 | RESISTOR,1 KOHM,0.25W,+/-1%,1206 | A ECO-R252633 | 3 | Each | Production | R58,R59,R60 | Part | CBRM | Preferred
3 | 0 | 10096505 | PRINTED CIRCUIT, DRIVER BOARD RB0505 | A MC002637 | 1 | Each | Production |  | Part | CBRM | Preferred
3 | 0 | 4096600.E00.001 | BLOWER COMMAND BOARD SCH | 03 ECO-R256396 | 1 |  | Production |  | Document | CBRM
3 | 1 | 3846100 | CPU/BLOWER DRIVER HARNESS | D ECO-R252633 | 1 | Each | Production |  | Part | CBRM | Preferred
3 | 2 | 3838600 | PC BOARD TRACABILITY LABEL | C ECO-R252633 | 1 | Each | Production |  | Part | CBRM | Preferred
2 | 54 | 3812400 | HEXAGONAL SPACER M/F M3 LG5 | A ECO-R214792 | 4 | Each | Production |  | Part | GYRM | Preferred
2 | 55 | 2877500 | NEOPRENE CELLULAR ADHESIVE STRIP | B ECO-R224554 | .2 | Meter | Production |  | Part | GYRM | Preferred
2 | 56 | 3828200 | BLOWER | C EC088044 | 1 | Each | Production |  | Part | GYRM | Preferred
2 | 57 | 10037006 | P-CLIP PLASTIC COLLAR | C ECO-R223442 | 1 | Each | Production |  | Part | GYRM | Preferred
2 | 59 | 3822500 | POWER SUPPLY/BLOWER DRIVER HARNESS RB0505 | C ECO-R215345 | 1 | Each | Production |  | Part | GYRM | Preferred
2 | 61 | 3823600 | UPPER HOUSING RB0505 | C ECO-R213924 | 1 | Each | Production |  | Part | GYRM
3 | 0 | 3808400 | LEGENDAIR UPPER CASING | B ECO-R226884 | 0 | Each | Production |  | Part | BDRM | Preferred
2 | 62 | 3825500 | KEYPAD PB560 | E EC098854 | 1 | Each | Production |  | Part | GYRM | Preferred
2 | 63 | 3823200 | HANDLE RB0505 | B ECO-R226544 | 1 | Each | Production |  | Part | GYRM
2 | 64 | 2960600 | ZINC-PLATED STEEL COUNTERSUNK SCREW HEXALOBE M4X10 | A ECO-R224554 | 7 | Each | Production |  | Part | GYRM | Preferred
2 | 65 | 3828300 | LABEL, PB 540, TUBING DIAGRAM | A01 ECO-R215328 | 1 | Each | Production |  | Part | GYRM | Preferred
2 | 66 | PT00096186 | EMI Aluminum Foil Shielding Tape 1170, 3/4 in, 18yd | A EC117729 | 0.06 | Roll | Production |  | Part | GYRM | Preferred
2 | 67 | 4-076684-00 | GASKET, EMC, CHOMERICS, 8.5" LONG GUI COMMS | A MC009888 | 0.05 | Each | Production |  | Part | GYRM | Preferred
2 | 71 | 2962600 | O2 FEMALE CONNECTOR WITH VALVE | A ECO-R223442 | 1 | Each | Production |  | Part | GYRM | Preferred
2 | 72 | 2951700 | LABEL ELECTROSTATIC PROTECTION | 00 ECO-R220499 | 1 | Each | Production |  | Part | GYRM | Preferred
2 | 73 | PT00094490 | LABEL, AIR INLET, PB560 | A EC116124 | 1 | Each | Production |  | Part | GYRM | Preferred
3 | 10 | DC00088905 | ARTWORK, PB560, AIR INLET LABEL | A EC116124 | 0 |  | Production |  | Document | BDRM
2 | 74 | 10093284 | PB500 POWER SWITCH COVER RETAINER | A ECO-R224662 | 1 | Each | Production |  | Part | GYRM
2 | 75 | 10000915 | ALARM REPEATER HARNESS,R/A II,PB5X0 | B ECO-R214584 | 1 | Each | Production |  | Part | GYRM | Preferred
2 | 77 | 3814200 | SWITCH COVER | A ECO-R214792 | 1 | Each | Production |  | Part | GYRM | Preferred
2 | 78 | 2699400 | DIN 6799 Ø3.2 RETAINING RING | 00 MC002909 | 1 | Each | Production |  | Part | GYRM | Preferred
2 | 79 | 3809700 | KNURLED CAPTIVE KNOB | A ECO-R214584 | 1 | Each | Production |  | Part | GYRM | Preferred
2 | 81 | 10049560 | COOLING FAN WITH CABLE | D EC119181 | 1 | Each | Production |  | Part | GYRM | Preferred
2 | 82 | 10000265 | ZINC-PLATED STEEL TCB SCREW HEXALOBE D3.0X25 | B ECO-R223089 | 2 | Each | Production |  | Part | GYRM | Preferred
2 | 83 | 10096510 | BATTERY CONNECTION CARD RB0505 | A ECO-R252633 | 1 | Each | Production |  | Part | GYRM | Preferred
3 | 0 | 10022508 | CAPACITOR CERAMIC,10NF,+/-10%,50V,0603 | C ECO-R252633 | 2 | Each | Production | C1,C2 | Part | BDRM | Preferred
3 | 0 | 10022532 | FILTER CC, 1MHZ-1GHZ, 10A, 50V | B EC130338 | 1 | Each | Production | FI1 | Part | BDRM | Preferred
3 | 0 | 10022623 | CAPACITOR,47 PF,+/-5%,50V,0402 | C ECO-R252636 | 2 | Each | Production | C3,C4 | Part | BDRM | Preferred
3 | 0 | 10022907 | SMD FERRITE 200MA | B ECO-R252636 | 2 | Each | Production | FI2,FI3 | Part | BDRM | Preferred
3 | 0 | 10023418 | CONNECTOR, 10 CONTACTS, HE10 | A ECO-R252633 | 1 | Each | Production | J1 | Part | BDRM | Preferred
3 | 0 | 10023419 | CONNECTOR, 1 CONTACTS, TEST PROBE | A ECO-R252636 | 1 | Each | Production | J6 | Part | BDRM | Preferred
3 | 0 | 10023420 | CONNECTOR, 2 CONTACTS, PIN SPACE 2.54, SM | B ECO-R252636 | 3 | Each | Production | J3,J4,J5 | Part | BDRM | Preferred
3 | 0 | 10096506 | PRINTED CIRCUIT, BATTERY BOARD | A MC002637 | 1 | Each | Production |  | Part | BDRM | Preferred
3 | 0 | 4096600.E01.001 | BATTERY CONNECTION BOARD SCH | 02 ECO-R256396 | 1 |  | Production |  | Document | BDRM
3 | 1 | 3838600 | PC BOARD TRACABILITY LABEL | C ECO-R252633 | 1 | Each | Production |  | Part | BDRM | Preferred
2 | 84 | 10096511 | POWER SUPPLY BOARD - TANTALUM LESS | C EC123226 | 1 | Each | Production |  | Part | GYRM | Preferred
3 | 0 | 10022131 | RESISTOR, 27K OHM, 0.063W, +/-0.1%,0603 | C ECO-R252636 | 2 | Each | Production | R1,R124 | Part | CBRM | Preferred
3 | 0 | 10022135 | CAPACITOR CERAMIC, 100NF, +/-10%, 50V, X7R,0805 | C ECO-R252633 | 15 | Each | Production | C23,C31,C55,C70,C79,C106,C109,C110,C112,C113,C131,C132,C133,C140,C141 | Part | CBRM | Preferred
3 | 0 | 10022508 | CAPACITOR CERAMIC,10NF,+/-10%,50V,0603 | C ECO-R252633 | 15 | Each | Production | C18,C19,C22,C37,C47,C49,C52,C83,C99,C111,C115,C116,C117,C118,C119 | Part | CBRM | Preferred
3 | 0 | 10022510 | CAPACITOR,330NF,+/-10%,16V,0805,X7R | C ECO-R252633 | 1 | Each | Production | C76 | Part | CBRM | Preferred
3 | 0 | 10022532 | FILTER CC, 1MHZ-1GHZ, 10A, 50V | B EC130338 | 3 | Each | Production | FLTR1,FLTR2,FLTR3 | Part | CBRM | Preferred
3 | 0 | 10022539 | RESISTOR, 39K OHM, 0.063W, +/-0.1%, 0603 | B ECO-R252636 | 1 | Each | Production | R121 | Part | CBRM | Preferred
3 | 0 | 10022546 | CAPACITOR, 1UF, +/-10%, 16V, 0805 | A ECO-R252636 | 2 | Each | Production | C32,C57 | Part | CBRM | Preferred
3 | 0 | 10022549 | RESISTOR,100KOHM,0.063W,+/-1%,0603 | C ECO-R252633 | 15 | Each | Production | R15,R20,R31,R32,R42,R43,R53,R54,R58,R65,R94,R96,R97,R111,R123 | Part | CBRM | Preferred
3 | 0 | 10022558 | TRANSISTOR MOSFET, 30V, 0.93A, 0.25 OHM, N CHANNEL | B ECO-R252633 | 2 | Each | Production | T23,T29 | Part | CBRM | Preferred
3 | 0 | 10022559 | TRANSISTOR MOSFET, 60V, 16.7A, N CHANNEL | B ECO-R252633 | 2 | Each | Production | T24,T27 | Part | CBRM | Preferred
3 | 0 | 10022607 | CAPACITOR,100NF,16V,+/-10%,X7R,0402 | D EC113997 | 43 | Each | Production | C1,C3,C4,C5,C6,C8,C9,C12,C13,C15,C17,C25,C35,C36,C46,C58,C59,C63,C64,C69,C71,C75,C78,C82,C85,C86,C87,C88,C91,C92,C93,C96,C97,C101,C102,C103,C104,C105,C108,C122,C123,C124,C126 | Part | CBRM | Preferred
3 | 0 | 10022609 | CAPACITOR, 33PF, +/-5%,50V,NPO, 0603 | B ECO-R252636 | 1 | Each | Production | C7 | Part | CBRM | Preferred
3 | 0 | 10022613 | CAPACITOR CERAMIC,4.7NF,+/-10%,50V,0603 | C ECO-R252636 | 1 | Each | Production | C24 | Part | CBRM | Alternate
3 | 0 | 10022616 | CAPACITOR,4.7UF,+/-10%,16V, X5R, 0805 | A ECO-R252636 | 2 | Each | Production | C30,C80 | Part | CBRM | Preferred
3 | 0 | 10022618 | CAPACITOR,2.2UF,+/-10%,16V,1206 | A ECO-R252636 | 1 | Each | Production | C33 | Part | CBRM | Preferred
3 | 0 | 10022620 | CAPACITOR,220NF,+/-20%,16V,0603 | C ECO-R252636 | 2 | Each | Production | C38,C39 | Part | CBRM | Preferred
3 | 0 | 10022621 | CAPACITOR ELECTROLYTIC, 330UF,35V | A ECO-R252636 | 2 | Each | Production | C42,C125 | Part | CBRM | Preferred
3 | 0 | 10022622 | CAPACITOR ELECTROLYTIC, 220UF,16V+/-20% | C ECO-R252636 | 1 | Each | Production | C44 | Part | CBRM | Preferred
3 | 0 | 10022623 | CAPACITOR,47 PF,+/-5%,50V,0402 | C ECO-R252636 | 7 | Each | Production | C48,C120,C121,C127,C128,C129,C130 | Part | CBRM | Preferred
3 | 0 | 10022625 | CAPACITOR ELECTROLYTIC, 100UF,35V,+/-10% | A ECO-R252636 | 1 | Each | Production | C54 | Part | CBRM | Preferred
3 | 0 | 10022627 | CAPACITOR,33NF,+/-10%,16V,X7R,0603 | B ECO-R252636 | 1 | Each | Production | C72 | Part | CBRM | Preferred
3 | 0 | 10022628 | CAPACITOR,1NF,+/-10%,50V,X7R,0603 | A ECO-R252636 | 1 | Each | Production | C74 | Part | CBRM | Preferred
3 | 0 | 10022630 | CAPACITOR,1UF,+/-10%,6.3V,X5R,0603 | A ECO-R252636 | 1 | Each | Production | C84 | Part | CBRM | Preferred
3 | 0 | 10022632 | CAPACITOR CERAMIC,22PF,+/-5%,50V,0603 | C ECO-R252636 | 2 | Each | Production | C94,C95 | Part | CBRM | Preferred
3 | 0 | 10022652 | DIODE SCHOTTKY, 30V, 200MA | C ECO-R252636 | 4 | Each | Production | D1,D17,D18,D20 | Part | CBRM | Preferred
3 | 0 | 10022653 | DIODE SCHOTTKY DOUBLE,30V, 200MA,SOT23 | C ECO-R252636 | 5 | Each | Production | D2,D7,D14,D15,D16 | Part | CBRM | Preferred
3 | 0 | 10022654 | DIODE TRANSIENT 600W,36V | C EC093850 | 2 | Each | Production | D3,D21 | Part | CBRM | Preferred
3 | 0 | 10022655 | DIODE ZENER, 0.35W,4.7V | C ECO-R252636 | 1 | Each | Production | D4 | Part | CBRM | Preferred
3 | 0 | 10022656 | DIODE SCHOTTKY, 3A, 40V | B ECO-R252636 | 3 | Each | Production | D5,D6,D11 | Part | CBRM | Preferred
3 | 0 | 10022657 | DIODE ZENER, 0.35,5.1V, SOT23 | B ECO-R252636 | 2 | Each | Production | D10,D12 | Part | CBRM | Preferred
3 | 0 | 10022658 | DIODE, 33V, VCL 53.3V, 1500W | A ECO-R252636 | 1 | Each | Production | D13 | Part | CBRM | Preferred
3 | 0 | 10022695 | RESISTOR,27K OHM, 0.063W, +/-1%, 0603 | B ECO-R252636 | 1 | Each | Production | R18 | Part | CBRM | Preferred
3 | 0 | 10022696 | RESISTOR,10.2K OHM, 0.063W, +/-0.1%,0603 | A ECO-R252636 | 1 | Each | Production | R2 | Part | CBRM | Preferred
3 | 0 | 10022697 | RESISTOR,470 OHM, 0.125W,+/-1%, 0805 | C ECO-R252636 | 1 | Each | Production | R3 | Part | CBRM | Preferred
3 | 0 | 10022698 | RESISTOR,12K OHM,0.063W,+/-1%,0603 | B ECO-R252636 | 1 | Each | Production | R4 | Part | CBRM | Preferred
3 | 0 | 10022699 | RESISTOR,27 OHM,0.063W,+/-1%,0603 | B ECO-R252636 | 2 | Each | Production | R5,R6 | Part | CBRM | Preferred
3 | 0 | 10022700 | RESISTOR,1.5K OHM,0.063W,+/-1%,0603 | C ECO-R252636 | 1 | Each | Production | R7 | Part | CBRM | Preferred
3 | 0 | 10022704 | RESISTOR,470 OHM, 0.063W,+/-1%,0603 | B ECO-R252636 | 1 | Each | Production | R14 | Part | CBRM | Preferred
3 | 0 | 10022708 | RESISTOR,110K OHM,0.603W,+/-0.1%,0603 | A ECO-R252636 | 2 | Each | Production | R19,R33 | Part | CBRM | Preferred
3 | 0 | 10022710 | RESISTOR, 0.015 OHM, 1W,+/-1%,2010 | C ECO-R252636 | 1 | Each | Production | R45 | Part | CBRM | Preferred
3 | 0 | 10022712 | RESISTOR,33K OHM,0.063W,+/-1%,0603 | B ECO-R252636 | 2 | Each | Production | R52,R109 | Part | CBRM | Preferred
3 | 0 | 10022713 | RESISTOR,40.2K OHM,0.063W,+/-0.1%,0603 | B ECO-R252636 | 2 | Each | Production | R55,R120 | Part | CBRM | Preferred
3 | 0 | 10022714 | RESISTOR,5.6K OHM,0.063W,+/-1%,0603 | B ECO-R252636 | 1 | Each | Production | R59 | Part | CBRM | Preferred
3 | 0 | 10022716 | RESISTOR,0.015 OHM, 0.5W,+/-1%,1206 | B ECO-R252636 | 1 | Each | Production | R62 | Part | CBRM | Alternate
3 | 0 | 10022720 | RESISTOR,1.24K OHM,0.063W.+/-1%,0603 | C ECO-R252636 | 2 | Each | Production | R74,R76 | Part | CBRM | Preferred
3 | 0 | 10022721 | RESISTOR,0.015 OHM,2W,+/-1%,2512 | B ECO-R252636 | 1 | Each | Production | R75 | Part | CBRM | Alternate
3 | 0 | 10022722 | RESISTOR,1.5M OHM,0.063W,+/-1%,0603 | B ECO-R252636 | 2 | Each | Production | R79,R108 | Part | CBRM | Preferred
3 | 0 | 10022723 | RESISTOR,0.05 OHM,1W,+/-1%,2010 | C ECO-R252636 | 1 | Each | Production | R80 | Part | CBRM | Preferred
3 | 0 | 10022726 | RESISTOR,2.87K OHM,0.063W,+/-0.1%,0603 | B ECO-R252636 | 1 | Each | Production | R85 | Part | CBRM | Preferred
3 | 0 | 10022727 | RESISTOR,86.6K OHM,0.063W,+/-1%,0603 | A ECO-R252636 | 1 | Each | Production | R87 | Part | CBRM | Preferred
3 | 0 | 10022728 | RESISTOR,390 OHM,2W,+.-5%,SM2 | B ECO-R252636 | 2 | Each | Production | R88,R126 | Part | CBRM | Preferred
3 | 0 | 10022730 | RESISTOR,16.2K OHM,0.063W,+/-0.1%,0603 | B ECO-R252636 | 1 | Each | Production | R91 | Part | CBRM | Preferred
3 | 0 | 10022731 | RESISTOR,3.3K OHM,0.063W,+/-1%,0603 | C ECO-R252636 | 1 | Each | Production | R92 | Part | CBRM | Preferred
3 | 0 | 10022733 | RESISTOR,33 OHM,0.063W,+/-1%,0603 | B ECO-R252636 | 1 | Each | Production | R95 | Part | CBRM | Preferred
3 | 0 | 10022734 | RESISTOR,47K OHM,0.063W,+/-1%,0603 | B ECO-R252636 | 2 | Each | Production | R8,R102 | Part | CBRM | Preferred
3 | 0 | 10022735 | RESISTOR,2.7K OHM,0.063W,+/-1%,0603 | B ECO-R252636 | 1 | Each | Production | R103 | Part | CBRM | Preferred
3 | 0 | 10022736 | RESISTOR,1M OHM,0.063W,+/-1%,0603 | C ECO-R252636 | 3 | Each | Production | R104,R110,R113 | Part | CBRM | Preferred
3 | 0 | 10022737 | RESISTOR,66.5K OHM,0.063W,+/-0.1%,0603 | B ECO-R252636 | 1 | Each | Production | R107 | Part | CBRM | Preferred
3 | 0 | 10022739 | IC, COMPARATOR, SOT23-6 | B ECO-R252636 | 1 | Each | Production | IC6 | Part | CBRM | Alternate
3 | 0 | 10022740 | RESISTOR,1.5K OHM,0.250W,+/-1%,1206 | B ECO-R252636 | 1 | Each | Production | R114 | Part | CBRM | Preferred
3 | 0 | 10022741 | INDUCTOR, POWER CHOKE, 47UH, 8A | A ECO-R252636 | 1 | Each | Production | L3 | Part | CBRM | Preferred
3 | 0 | 10022742 | RESISTOR,100 OHM,0.25W,+/-1%,1206 | A ECO-R252636 | 1 | Each | Production | R116 | Part | CBRM | Preferred
3 | 0 | 10022743 | RESISTOR,270 OHM,0.125W,+/-1%,0805 | B ECO-R252636 | 1 | Each | Production | R117 | Part | CBRM | Preferred
3 | 0 | 10022744 | RESISTOR,470K OHM,0.063W,+/-1%,0603 | C ECO-R252636 | 2 | Each | Production | R118,R122 | Part | CBRM | Preferred
3 | 0 | 10022867 | USB MINI B | B ECO-R252636 | 1 | Each | Production | J1 | Part | CBRM | Preferred
3 | 0 | 10022868 | CONNECTOR, ZH RIGHT, PINS 6 / 1.5 MM 1A/50V | A ECO-R252636 | 1 | Each | Production | J2 | Part | CBRM | Preferred
3 | 0 | 10022871 | IC SOCKET CONNECTOR SIZE 1, 6 CIRCUITS, 4.5 A | B ECO-R252636 | 1 | Each | Production | J5 | Part | CBRM | Alternate
3 | 0 | 10022872 | CONNECTOR HEADER, 2 CIRCUITS, 2.54MM, 4A, 250V | B ECO-R252636 | 1 | Each | Production | J6 | Part | CBRM | Preferred
3 | 0 | 10022874 | CONNECTOR MICRO-FIT, 2 CIRCUITS,3MM,5A,250V | B ECO-R252636 | 1 | Each | Production | J9 | Part | CBRM | Preferred
3 | 0 | 10022875 | CONNECTOR FEMALE,2.54MM SPACING,8.5MM +/-0.15 | B ECO-R252636 | 1 | Each | Production | J10 | Part | CBRM | Preferred
3 | 0 | 10022876 | CONNECTOR USB A | B ECO-R252636 | 2 | Each | Production | J12,J13 | Part | CBRM | Preferred
3 | 0 | 10022877 | ZH RIGHT CONNECTOR PINS 4 / 1.5 MM 1A/50V | A ECO-R252636 | 1 | Each | Production | J14 | Part | CBRM | Preferred
3 | 0 | 10022878 | FUSE HOLDER 5X20 | B ECO-R252636 | 1 | Each | Production | F1 | Part | CBRM | Preferred
3 | 0 | 10022886 | DUAL DIFFERENTIAL COMPARATOR, SOIC8 | C ECO-R252636 | 1 | Each | Production | IC1 | Part | CBRM | Preferred
3 | 0 | 10022887 | SINGLE 2 INPUT POSITIVE AND GATE, SOT23 | A ECO-R252636 | 1 | Each | Production | IC2 | Part | CBRM | Preferred
3 | 0 | 10022888 | MICROCON,8 BIT, FLASH 64K,RAM3966 BYTES,TQFP64 | A ECO-R252636 | 1 | Each | Production | IC3 | Part | CBRM | Preferred
3 | 0 | 10022890 | IC, SERIAL TO 1-WIRE DRIVER, SOIC8 | B ECO-R252636 | 1 | Each | Production | IC5 | Part | CBRM | Preferred
3 | 0 | 10022891 | IC,CURRENT SHUNT MONITOR,MSOP | A ECO-R252636 | 1 | Each | Production | IC7 | Part | CBRM | Preferred
3 | 0 | 10022892 | REGULATOR 3.3 V 2% 500MA LOW DROPOUT,DPACK | B ECO-R252636 | 1 | Each | Production | IC8 | Part | CBRM | Preferred
3 | 0 | 10022895 | REGULATOR, 5.5V TO 36V,3A | C ECO-R252636 | 1 | Each | Production | IC11 | Part | CBRM | Preferred
3 | 0 | 10022898 | IC,MICROCONTROLLER,TQFP100 | A ECO-R252636 | 1 | Each | Production | IC15 | Part | CBRM | Preferred
3 | 0 | 10022900 | IC,EEPROM,2.5V-5.5V,12C SERIES, 64KBYTES, SOIC8 | B ECO-R252636 | 1 | Each | Production | IC17 | Part | CBRM | Preferred
3 | 0 | 10022901 | IC,NON INVERTING BUS TRANSCEIVER,MSOP | B ECO-R252636 | 3 | Each | Production | IC18,IC19,IC20 | Part | CBRM | Alternate
3 | 0 | 10022904 | IC,REGULATOR, 24V +/-4%, 500MA, DPACK | A ECO-R252636 | 1 | Each | Production | IC25 | Part | CBRM | Preferred
3 | 0 | 10022905 | IC,BUS SWITCH,SC70 | B ECO-R252636 | 2 | Each | Production | IC26,IC27 | Part | CBRM | Preferred
3 | 0 | 10022906 | IC,VOLTAGE REGULATOR,5V +/-4%,500MA, DPACK | B ECO-R252636 | 1 | Each | Production | IC28 | Part | CBRM | Preferred
3 | 0 | 10022907 | SMD FERRITE 200MA | B ECO-R252636 | 18 | Each | Production | L6,L15,L16,L17,L18,L19,L20,L21,L22,L23,L43,L44,L45,L46,L47,L48,L49,L50 | Part | CBRM | Preferred
3 | 0 | 10022908 | INDUCTOR,33UH +/-10% | B ECO-R252636 | 1 | Each | Production | L2 | Part | CBRM | Preferred
3 | 0 | 10022910 | INDUCTOR, MINIATURE, 220UH, 220MA,WE-TPC | A ECO-R252636 | 1 | Each | Production | L4 | Part | CBRM | Preferred
3 | 0 | 10022911 | SMD FERRITE, 1A,1206 | B ECO-R252636 | 2 | Each | Production | L5,L61 | Part | CBRM | Preferred
3 | 0 | 10022912 | INDUCTOR, 47UH +/-20%,3.8A,WE-PD-XXL | A ECO-R252636 | 1 | Each | Production | L12 | Part | CBRM | Preferred
3 | 0 | 10022913 | INDUCTOR,470NH,450MA +/-20%,C1206 | A ECO-R252636 | 2 | Each | Production | L13,L14 | Part | CBRM | Preferred
3 | 0 | 10022922 | IC,RESONATOR, 6MHZ +/-0.5%,CMS | A ECO-R252636 | 1 | Each | Production | Q1 | Part | CBRM | Preferred
3 | 0 | 10022924 | TEST POINT | B ECO-R252633 | 1 | Each | Production | PT1 | Part | CBRM | Preferred
3 | 0 | 10022926 | SMD VARISTOR, 5.5V,C0603 | A ECO-R252636 | 5 | Each | Production | ML1,ML2,ML3,ML6,ML8 | Part | CBRM | Preferred
3 | 0 | 10022927 | VARISTOR, CMS PROTECTION, 30VRMS, 38 VDC, 1206, | A ECO-R252636 | 1 | Each | Production | ML4 | Part | CBRM | Preferred
3 | 0 | 10022928 | RESETTABLE FUSE, 1.1A,C1812 | A ECO-R252636 | 1 | Each | Production | PCT1 | Part | CBRM | Preferred
3 | 0 | 10022929 | THERMISTOR, 10K OHM, B4300. +/-5% | A ECO-R252636 | 1 | Each | Production | CT1 | Part | CBRM | Preferred
3 | 0 | 10022930 | SWITCH SOCKET 2 POLES | A ECO-R252636 | 1 | Each | Production | SW1 | Part | CBRM | Preferred
3 | 0 | 10022933 | RSPTRANSISTOR MOSFET, P CHANNEL, 30V,0.6A | B ECO-R252636 | 5 | Each | Production | T2,T6,T11,T16,T31 | Part | CBRM | Preferred
3 | 0 | 10022946 | VARISTOR, CMS PROTECTION ESD SURGE SUPPRESSOR,C0603 | B ECO-R252636 | 6 | Each | Production | PG1,PG2,PG3,PG4,PG5,PG6 | Part | CBRM | Preferred
3 | 0 | 10039579 | CAPACITOR CERAMIC, 10UF,+/-10%,16V | A ECO-R252636 | 2 | Each | Production | C2,C45 | Part | CBRM | Preferred
3 | 0 | 10039581 | CAPACITOR CERAMIC, 10UF,+/-10%,50V | C EC114250 | 19 | Each | Production | C10,C11,C14,C20,C26,C27,C28,C40,C41,C43,C51,C60,C66,C67,C73,C114,C136,C137,C138 | Part | CBRM | Preferred
3 | 0 | 10039582 | CAPACITOR CERAMIC, 4.7UF,+/-10%,50V | B EC114250 | 5 | Each | Production | C21,C29,C90,C134,C135 | Part | CBRM | Preferred
3 | 0 | 10039583 | CAPACITOR CERAMIC, 22UF,+/-10%,25V | A ECO-R252636 | 1 | Each | Production | C107 | Part | CBRM | Preferred
3 | 0 | 10039584 | CAPACITOR CERAMIC, 22UF,+/-10%,16V | B ECO-R252636 | 2 | Each | Production | C34,C65 | Part | CBRM | Preferred
3 | 0 | 10039585 | CAPACITOR CERAMIC, 100UF,+/-20%,6.3V | A ECO-R252636 | 1 | Each | Production | C89 | Part | CBRM | Preferred
3 | 0 | 10039586 | DIODE SCHOTTKY, 40V, 500MA | A ECO-R252636 | 2 | Each | Production | D8,D9 | Part | CBRM | Preferred
3 | 0 | 10039587 | FERRITE, SMD, 220OHM | A ECO-R252636 | 6 | Each | Production | L1,L7,L10,L24,L25,L26 | Part | CBRM | Preferred
3 | 0 | 10039588 | COMMON MODE CHOKE COIL 550OHM | A ECO-R252636 | 3 | Each | Production | L8,L9,L11 | Part | CBRM | Preferred
3 | 0 | 10039639 | POWER SUPPLY BOARD - TANTALUM LESS SCHEMATIC | C ECO-R256396 | 1 |  | Production |  | Document | CBRM
3 | 0 | 10052332 | HEADER CONNECTOR, VERTICAL, 26 PINS | A ECO-R252636 | 1 | Each | Production | J7 | Part | CBRM | Preferred
3 | 0 | 10095972 | TRANSISTOR MOSFET, 60V, 50A, P CHANNEL | A ECO-R255176 | 9 | Each | Production | T3,T4,T5,T9,T10,T14,T15,T25,T26 | Part | CBRM | Preferred
3 | 0 | 10095973 | CAPACITOR ARRAY, 47PF, 50V, +/-10%,NPO,0612 | A ECO-R252633 | 5 | Each | Production | C53,C61,C62,C98,C100 | Part | CBRM | Preferred
3 | 0 | 10095975 | RESISTOR,10K OHM.0.063W,+/-1%,0603 | A ECO-R252633 | 32 | Each | Production | R10,R12,R16,R21,R23,R24,R25,R27,R28,R29,R30,R34,R36,R37,R38,R39,R40,R41,R46,R49,R50,R51,R60,R68,R77,R83,R84,R86,R89,R98,R105,R106 | Part | CBRM | Preferred
3 | 0 | 10095977 | RESISTOR,4.7KOHM,0.063W,+/-1% | A ECO-R252633 | 2 | Each | Production | R17,R26 | Part | CBRM | Preferred
3 | 0 | 10095979 | RESISTOR,100 OHM,0.063W,+/-1%, 0603 | A ECO-R252633 | 1 | Each | Production | R11 | Part | CBRM | Preferred
3 | 0 | 10095981 | RESISTOR, 1K OHM, 0.063W,+/-1%, 0603 | A ECO-R252633 | 2 | Each | Production | R82,R93 | Part | CBRM | Preferred
3 | 0 | 10095983 | RESISTOR, 22 K OHM,0.063W, +/-1%,0603 | A ECO-R252633 | 1 | Each | Production | R119 | Part | CBRM | Preferred
3 | 0 | 10095984 | RESISTOR,1 KOHM,0.25W,+/-1%,1206 | A ECO-R252633 | 3 | Each | Production | R69,R99,R115 | Part | CBRM | Preferred
3 | 0 | 10096508 | PRINTED CIRCUIT, PS BOARD TANTALUM LESS | A MC002637 | 1 | Each | Production |  | Part | CBRM | Preferred
3 | 0 | 10097253 | DIODE SCHOTTKY, 40V, 1A | A ECO-R252636 | 3 | Each | Production | CR1,CR2,D19 | Part | CBRM | Preferred
3 | 0 | 10097270 | RESISTOR,1.37K OHM,0.063W,+/-0.1%,0603 | A ECO-R252636 | 1 | Each | Production | R90 | Part | CBRM | Preferred
3 | 0 | 10097271 | RESISTOR, 100K OHM, 0.063W,+/-0.1%,0603 | A ECO-R252636 | 3 | Each | Production | R44,R64,R125 | Part | CBRM | Preferred
3 | 0 | 10097272 | RESISTOR, PRECISION,10K OHM, 0.063W,+/-0.1%,0603 | A ECO-R252636 | 12 | Each | Production | R9,R22,R35,R47,R56,R57,R66,R70,R71,R72,R78,R112 | Part | CBRM | Preferred
3 | 0 | 10097273 | RESISTOR,PRECISION, 3.24K OHM, 0.063W,+/-0.1%,0603 | A ECO-R252636 | 1 | Each | Production | R73 | Part | CBRM | Preferred
3 | 0 | 10097274 | TRANSISTOR MOSFET N CHANNEL 60V, 0.18A | A ECO-R252636 | 8 | Each | Production | T7,T8,T12,T13,T17,T18,T28,T30 | Part | CBRM | Preferred
3 | 0 | 10098978 | CAPACITOR,470PF,+/-10%,50V,0402 | A ECO-R252636 | 1 | Each | Production | C16 | Part | CBRM | Preferred
3 | 0 | 10098979 | CAPACITOR,220NF,+/-10%,16V,X7R,1206 | A ECO-R252636 | 1 | Each | Production | C50 | Part | CBRM | Preferred
3 | 0 | 10098980 | CAPACITOR,56PF,50V,+/-5%,0603,NPO | A ECO-R252636 | 1 | Each | Production | C68 | Part | CBRM | Preferred
3 | 0 | 10098981 | CAPACITOR,100PF,50V,+/-5%,C0G,0402 | A ECO-R252636 | 2 | Each | Production | C77,C81 | Part | CBRM | Preferred
3 | 0 | 10098993 | RESISTOR,39K OHM,0.063W,+/-1%,0603 | A ECO-R252636 | 2 | Each | Production | R48,R61 | Part | CBRM | Preferred
3 | 0 | 10098999 | RESISTOR,47K OHM,0.063W,+/-0.1%,0603 | A ECO-R252636 | 1 | Each | Production | R63 | Part | CBRM | Preferred
3 | 0 | 10099001 | RESISTOR,1.62K OHM,0.063W,+/0.1%,0603 | A ECO-R252636 | 1 | Each | Production | R67 | Part | CBRM | Preferred
3 | 0 | 10099002 | RESISTOR,13.7K OHM,0.063W,+/-0.1%,0603 | A ECO-R252636 | 1 | Each | Production | R81 | Part | CBRM | Preferred
3 | 0 | 10099005 | CONNECTOR KK PC BOARD 12 CIRCUITS, 3.96MM,5A,250V | A ECO-R252636 | 1 | Each | Production | J3 | Part | CBRM | Preferred
3 | 0 | 10099008 | CONNECTOR KK PC BOARD, 3 CIRCUITS, 3.96MM, 5A, 250V | A ECO-R252636 | 1 | Each | Production | J4 | Part | CBRM | Preferred
3 | 0 | 10099011 | MOSFET TRANS N CHANNEL,40V,12A,0.007 OHM, SO8 | A ECO-R252636 | 4 | Each | Production | T19,T20,T21,T22 | Part | CBRM | Preferred
3 | 0 | 10099014 | USB/UART, LQFP | A ECO-R252636 | 1 | Each | Production | IC4 | Part | CBRM | Preferred
3 | 0 | 10099015 | IC,CURRENT AMPLIFIER,MSOP | A ECO-R252636 | 2 | Each | Production | IC9,IC14 | Part | CBRM | Preferred
3 | 0 | 10099016 | IC,SYNCHRONOUS CONTROLLER,SSOP | A ECO-R252636 | 1 | Each | Production | IC10 | Part | CBRM | Preferred
3 | 0 | 10099017 | IC,SWITCHING REGULATOR,SSOP | A ECO-R252636 | 1 | Each | Production | IC13 | Part | CBRM | Preferred
3 | 0 | 10099018 | IC,RAM,3V3,64KX16,10NS,TSOP | A ECO-R252636 | 1 | Each | Production | IC16 | Part | CBRM | Preferred
3 | 0 | 10099020 | IC,RAIL TO RAIL COMPARATOR, 44V, SOT23 | A ECO-R252636 | 2 | Each | Production | IC21,IC22 | Part | CBRM | Preferred
3 | 0 | 10099522 | DIL SWITCH, 2 WAY, SMD, 25MA | A ECO-R252636 | 1 | Each | Production | SW2 | Part | CBRM | Preferred
3 | 0 | 10099523 | IC,VOLTAGE REFERENCE,5MA,3V +/-2%,SOT23 | A ECO-R252636 | 1 | Each | Production | IC12 | Part | CBRM | Preferred
3 | 0 | 10099524 | IC,VOLTAGE REFERENCE,SHUNT, 5V,SOT23 | A ECO-R252636 | 2 | Each | Production | IC23,IC24 | Part | CBRM | Preferred
3 | 0 | 10103068 | CRYSTAL,QUARTZ, 12MHZ, ROHS | A ECO-R252636 | 1 | Each | Production | Q3 | Part | CBRM | Preferred
3 | 0 | 10103070 | LARGE CYLINDRICAL HEAD DOMED 6 LOBES STAINLESS M3X12, ROHS | A ECO-R252636 | 1 | Each | Production |  | Part | CBRM | Preferred
3 | 0 | PT00101516 | POWER SUPPLY, 220VAC, 33VDC, 100W | A MC010712 | 1 | Each | Production |  | Part | CBRM | Preferred
3 | 1 | 10022925 | PLASTIC HEXAGONAL SPACERS CLIP 16MM | B ECO-R252636 | 2 | Each | Production |  | Part | CBRM | Preferred
3 | 3 | 10022707 | ADHESIVE, DP460 | A ECO-R252636 | 1 | Each | Production |  | Part | CBRM | Preferred
3 | 4 | 10023294 | PLASTIC SPACER, 2 M3 LG12 | B ECO-R252636 | 1 | Each | Production |  | Part | CBRM | Preferred
3 | 5 | 10100017 | HEXAGONAL SPACER, THREADED F/F, M4, LG8 | B EC114250 | 2 | Each | Production |  | Part | CBRM | Preferred
3 | 6 | 10100018 | PLASTIC PCB SPACER, CLIP/THREAD, M4, 15.9MM | A ECO-R252636 | 2 | Each | Production |  | Part | CBRM | Preferred
3 | 7 | 3838600 | PC BOARD TRACABILITY LABEL | C ECO-R252633 | 1 | Each | Production |  | Part | CBRM | Preferred
3 | 8 | 3826300 | LABEL, ATTENTION/CAUTION, MAINS WARNING, PURITAN BENNETT 540 | A01 ECO-R252636 | 1 | Each | Production |  | Part | CBRM | Preferred
3 | 9 | 10022909 | FUSE, 10A | B ECO-R252636 | 1 | Each | Production |  | Part | CBRM | Preferred
2 | 85 | 2957500 | ZINC-PLATED STEEL TCB SCREW HEXALOBE D3.5X8 | A ECO-R224891 | 8 | Each | Production |  | Part | GYRM | Preferred
2 | 86 | 3810200 | STOP COMMUTATION CARD | A ECO-R215345 | 1 | Each | Production |  | Part | GYRM | Preferred
2 | 87 | 3845900 | CPU/POWER SUPPLY HARNESS | D ECO-R214792 | 1 | Each | Production |  | Part | GYRM | Preferred
2 | 88 | GR106768 | BUZZER PCBA | B ECO-R252636 | 1 | Each | Production |  | Part | GYRM | Preferred
3 | 0 | 10021385 | RESISTOR,4.7 KOHM,+/-1%.0.063W,0402 | A ECO-R252636 | 1 | Each | Production | R40 | Part | BDRM | Preferred
3 | 0 | 10021387 | RESISTOR, 220 OHM,+/-1%, 0.063W, 0402 | B ECO-R252636 | 1 | Each | Production | R37 | Part | BDRM | Preferred
3 | 0 | 10021388 | RESISTOR, 180 KOHM, +/-1%, 0.063W.0402 | B ECO-R252636 | 1 | Each | Production | R41 | Part | BDRM | Preferred
3 | 0 | 10021389 | RESISTOR, 1.5 MOHM,0.063W, 0402 | B ECO-R252636 | 1 | Each | Production | R43 | Part | BDRM | Preferred
3 | 0 | 10021390 | CAPACITOR,4.7NF,16V,+/-10%,0402 | B ECO-R252636 | 1 | Each | Production | C35 | Part | BDRM | Preferred
3 | 0 | 10021391 | RESISTOR, 680 KOHM,+/-1%, 0.063W, 0402 | B ECO-R252636 | 1 | Each | Production | R44 | Part | BDRM | Preferred
3 | 0 | 10021462 | RESISTOR, 1 MOHM, +/-1%,0.063W,0402 | B ECO-R252636 | 1 | Each | Production | R46 | Part | BDRM | Preferred
3 | 0 | 10021463 | CAPACITOR,47UF,16V,1210,X5R | C ECO-R252636 | 2 | Each | Production | C21,C23 | Part | BDRM | Preferred
3 | 0 | 10021468 | RESISTOR, 137 KOHM, +/-1%,0.063W,0402 | B ECO-R252636 | 1 | Each | Production | R26 | Part | BDRM | Preferred
3 | 0 | 10021556 | RESISTOR, 68 KOHM,+/-1%, 0.063W, 0402 | B ECO-R252636 | 1 | Each | Production | R27 | Part | BDRM | Preferred
3 | 0 | 10021557 | RESISTOR,0 OHM,0.063W,0402 | B ECO-R252636 | 2 | Each | Production | R30,R31 | Part | BDRM | Preferred
3 | 0 | 10021558 | RESISTOR, 33 K OHM, +/-1%, 0.063W,0402 | B ECO-R252636 | 1 | Each | Production | R35 | Part | BDRM | Preferred
3 | 0 | 10022129 | BATTERY NI-MH TYPE V150H 4.8V | B ECO-R252636 | 1 | Each | Production | BAT1 | Part | BDRM | Preferred
3 | 0 | 10022130 | BUZZER | B ECO-R252636 | 2 | Each | Production | BUZ1,BUZ2 | Part | BDRM | Preferred
3 | 0 | 10022132 | CAPACITOR, CERAMIC, 680 PF, 50V, +/-5%, 0402 | B ECO-R252636 | 2 | Each | Production | C4,C6 | Part | BDRM | Preferred
3 | 0 | 10022133 | CAPACITOR ELECTROLYTIC,470UF,40V,+/-20% | A ECO-R252636 | 1 | Each | Production | C12 | Part | BDRM | Preferred
3 | 0 | 10022134 | CAPACITOR CERAMIC, 330 NF, 16V, X7R, 0603,+/-10% | A ECO-R252636 | 1 | Each | Production | C20 | Part | BDRM | Preferred
3 | 0 | 10022137 | CAPACITOR CERAMIC,10UF,16V,X5R,+/-10%,1206 | B EC123352 | 3 | Each | Production | C22,C26,C29 | Part | BDRM | Alternate
3 | 0 | 10022139 | DIODE ZENER, 2.7V, 0.35W, SOT23 | B ECO-R252636 | 1 | Each | Production | D5 | Part | BDRM | Preferred
3 | 0 | 10022140 | DIODE SCHOTTKY, 20V, 1A, DO216AA | A ECO-R252636 | 6 | Each | Production | D8,D10,D11,D12,D13,D14 | Part | BDRM | Preferred
3 | 0 | 10022141 | FUSE, FAST ACTING, SMD, 500MA | A ECO-R252636 | 1 | Each | Production | FU1 | Part | BDRM | Preferred
3 | 0 | 10022144 | IC, DOUBLE LOW POWER OPERATIONAL AMPLIFIER | A ECO-R252636 | 2 | Each | Production | IC2,IC3 | Part | BDRM | Preferred
3 | 0 | 10022145 | OPERATIONAL AMPLIFIER, SOT23-5 | A ECO-R252636 | 1 | Each | Production | IC4 | Part | BDRM | Preferred
3 | 0 | 10022147 | IC, CHARGE CONTROLLER, NICD/NIMH | B ECO-R252636 | 1 | Each | Production | IC6 | Part | BDRM | Preferred
3 | 0 | 10022148 | IC, COMPARATOR WITH VOLTAGE REF, 1.8V, SOT23 | B ECO-R252636 | 2 | Each | Production | IC7,IC9 | Part | BDRM | Alternate
3 | 0 | 10022149 | RESISTOR 100K OHM, 0.063W, +/-1%, 0402 | B ECO-R252636 | 14 | Each | Production | R1,R2,R3,R10,R24,R29,R38,R39,R42,R47,R59,R63,R64,R67 | Part | BDRM | Preferred
3 | 0 | 10022150 | RESISTOR,10K OHM, 0.063W, +/-1%, 0402 | B ECO-R252636 | 14 | Each | Production | R4,R5,R16,R17,R32,R34,R49,R51,R52,R61,R62,R66,R68,R70 | Part | BDRM | Preferred
3 | 0 | 10022151 | RESISTOR 59 KOHMS, 0.063W, +/-1% 0402 | B ECO-R252636 | 2 | Each | Production | R6,R45 | Part | BDRM | Preferred
3 | 0 | 10022152 | RESISTOR, 51.1 KOHM, 0.063W, +/-1%,0402 | B ECO-R252636 | 1 | Each | Production | R7 | Part | BDRM | Preferred
3 | 0 | 10022153 | RESISTOR, 1 KOHM, 0.063W,+/-1%, 0402 | B ECO-R252636 | 2 | Each | Production | R8,R33 | Part | BDRM | Preferred
3 | 0 | 10022154 | RESISTOR,32.4 KOHMS,0.063W,+/-1%,0402 | B ECO-R252636 | 2 | Each | Production | R9,R28 | Part | BDRM | Preferred
3 | 0 | 10022155 | RESISTOR,105 KOHM,0.063W,+/-1%,0402 | B ECO-R252636 | 1 | Each | Production | R11 | Part | BDRM | Preferred
3 | 0 | 10022156 | RESISTOR, 470 OHM, 0.063W, +/-1%, 0402 | B ECO-R252636 | 2 | Each | Production | R12,R22 | Part | BDRM | Preferred
3 | 0 | 10022158 | SWITCHING REGULATOR,40V, 1.3 A | A ECO-R252636 | 1 | Each | Production | IC8 | Part | BDRM | Preferred
3 | 0 | 10022162 | INDUCTOR, STORAGE 10UH, WE-TPC | A ECO-R252636 | 1 | Each | Production | L2 | Part | BDRM | Preferred
3 | 0 | 10022518 | DIODE SCHOTTKY, 200MA,30V,SOD23DIO | C ECO-R252633 | 3 | Each | Production | D3,D4,D9 | Part | BDRM | Preferred
3 | 0 | 10022607 | CAPACITOR,100NF,16V,+/-10%,X7R,0402 | D EC113997 | 16 | Each | Production | C5,C7,C8,C9,C10,C11,C15,C16,C17,C18,C19,C25,C30,C31,C32,C33 | Part | BDRM | Preferred
3 | 0 | 10022624 | INDUCTOR, STORAGE, 15UH, WE-TPC | A ECO-R252636 | 2 | Each | Production | L3,L4 | Part | BDRM | Preferred
3 | 0 | 10022627 | CAPACITOR,33NF,+/-10%,16V,X7R,0603 | B ECO-R252636 | 2 | Each | Production | C13,C14 | Part | BDRM | Preferred
3 | 0 | 10022653 | DIODE SCHOTTKY DOUBLE,30V, 200MA,SOT23 | C ECO-R252636 | 4 | Each | Production | D2,D6,D16,D17 | Part | BDRM | Preferred
3 | 0 | 10022657 | DIODE ZENER, 0.35,5.1V, SOT23 | B ECO-R252636 | 1 | Each | Production | D7 | Part | BDRM | Preferred
3 | 0 | 10022697 | RESISTOR,470 OHM, 0.125W,+/-1%, 0805 | C ECO-R252636 | 1 | Each | Production | R71 | Part | BDRM | Preferred
3 | 0 | 10022725 | RESISTOR, 1.5 OHM,+/-1%,0.063W,0402 | B ECO-R252636 | 4 | Each | Production | R13,R14,R19,R20 | Part | BDRM | Preferred
3 | 0 | 10022745 | RESISTOR, 33 OHM, +/-1%,0.063W, 0402 | B ECO-R252636 | 1 | Each | Production | R15 | Part | BDRM | Preferred
3 | 0 | 10022881 | RESISTOR, 150 KOHM,+/-1%,0.063W,0402 | B ECO-R252636 | 2 | Each | Production | R18,R21 | Part | BDRM | Preferred
3 | 0 | 10022911 | SMD FERRITE, 1A,1206 | B ECO-R252636 | 1 | Each | Production | L1 | Part | BDRM | Preferred
3 | 0 | 10022957 | RESISTOR, 2.2 KOHM, +/-1%, 0.063W, 0402 | B ECO-R252636 | 2 | Each | Production | R23,R65 | Part | BDRM | Preferred
3 | 0 | 10022958 | CAPACITOR, 10NF, 16V +/2%, 0805 | A ECO-R252636 | 1 | Each | Production | C3 | Part | BDRM | Preferred
3 | 0 | 10022966 | CAPACITOR CERAMIC, 220PF, 50V,+/-5%, NPO,0402 | C ECO-R252636 | 1 | Each | Production | C2 | Part | BDRM | Preferred
3 | 0 | 10023292 | RESISTOR,200 KOHM,+/-1%,0.063W,0402 | B ECO-R252636 | 1 | Each | Production | R69 | Part | BDRM | Preferred
3 | 0 | 10024439 | RESISTOR, 15 KOHM, +/-1%,0.063W,0402 | B ECO-R252636 | 1 | Each | Production | R55 | Part | BDRM | Preferred
3 | 0 | 10024440 | RESISTOR, 182 KOHM,+/-1%, 0.063W,0402 | B ECO-R252636 | 1 | Each | Production | R56 | Part | BDRM | Preferred
3 | 0 | 10024441 | RESISTOR, 54.9 KOHM, +/-1%, 0.063W,0402 | B ECO-R252636 | 1 | Each | Production | R57 | Part | BDRM | Preferred
3 | 0 | 10024442 | RESISTOR, 4.99 KOHM, +/-1%, 1/16W,0402 | B ECO-R252636 | 1 | Each | Production | R58 | Part | BDRM | Preferred
3 | 0 | 10024443 | TRANSISTOR, BIPOLAR, NPN, 45V, 100MA, SOT23 | B ECO-R252636 | 2 | Each | Production | T1,T3 | Part | BDRM | Preferred
3 | 0 | 10024444 | TRANSISTOR, BIPOLAR, PNP, 45V, 100MA, SOT23 | B ECO-R252636 | 2 | Each | Production | T2,T4 | Part | BDRM | Preferred
3 | 0 | 10024445 | TRANSISTOR, MOSFET, N CHANNEL, 20V, 5A, SOT23 | A ECO-R252636 | 5 | Each | Production | T5,T7,T9,T10,T13 | Part | BDRM | Preferred
3 | 0 | 10024446 | TRANSISTOR, MOSFET, P CHANNEL, 12V, 3.8A, SOT23 | A ECO-R252636 | 4 | Each | Production | T6,T8,T11,T12 | Part | BDRM | Preferred
3 | 0 | 10025553 | DIL, SLIDE SWITCH | A ECO-R252636 | 1 | Each | Production | SW1 | Part | BDRM | Preferred
3 | 0 | 10025554 | RESISTOR, 47 KOHM +/-1% 0,063W,0402 | B ECO-R252636 | 2 | Each | Production | R53,R54 | Part | BDRM | Preferred
3 | 0 | 10025604 | RESISTOR 33 OHM +/- 1% 0,125W,0805 | B ECO-R252636 | 1 | Each | Production | R36 | Part | BDRM | Preferred
3 | 0 | 10025605 | DIODE ZENER 0,35W 6,8V 2% | B ECO-R252636 | 1 | Each | Production | D15 | Part | BDRM | Preferred
3 | 0 | 10095973 | CAPACITOR ARRAY, 47PF, 50V, +/-10%,NPO,0612 | A ECO-R252633 | 1 | Each | Production | C1 | Part | BDRM | Preferred
3 | 0 | 10098981 | CAPACITOR,100PF,50V,+/-5%,C0G,0402 | A ECO-R252636 | 2 | Each | Production | C27,C28 | Part | BDRM | Preferred
3 | 0 | 10099021 | CAPACITOR CERAMIC,X7R,1UF,25V,+/10%, 0805 | A ECO-R252636 | 1 | Each | Production | C24 | Part | BDRM | Preferred
3 | 0 | 10099024 | FERRITE, 1K AT 100MHZ, 0.8 OHM, 50MA | A ECO-R252636 | 1 | Each | Production | FI1 | Part | BDRM | Preferred
3 | 0 | 10099025 | VOLTAGE COMPARATOR | A ECO-R252636 | 1 | Each | Production | IC1 | Part | BDRM | Preferred
3 | 0 | 10099026 | IC,ADJUSTABLE REGULATOR,0.1A | A ECO-R252636 | 1 | Each | Production | IC5 | Part | BDRM | Preferred
3 | 0 | 10099028 | CONNECTOR,FEMALE 7-PIN CPU | A ECO-R252636 | 1 | Each | Production | J2 | Part | BDRM | Preferred
3 | 0 | 10125624 | SCHEMATIC DIAGRAM BUZZER CARD | A ECO-R256396 | 1 |  | Production |  | Document | BDRM
3 | 0 | GR106771 | PRINTED CIRCUIT, BUZZER BOARD RB0505 | A MC002637 | 1 | Each | Production |  | Part | BDRM | Preferred
3 | 1 | 10099027 | CONNECTOR, CRIMP | A ECO-R252636 | 7 | Each | Production |  | Part | BDRM | Preferred
3 | 2 | 10022165 | WHITE CABLE, LENGTH 60 MM, FOR J1 | B EC062254 | 7 | Each | Production |  | Part | BDRM | Preferred
3 | 3 | 10022161 | ADHESIVE | A ECO-R252636 | 1 | Each | Production |  | Part | BDRM | Preferred
3 | 4 | 3838600 | PC BOARD TRACABILITY LABEL | C ECO-R252633 | 1 | Each | Production |  | Part | BDRM | Preferred
2 | 92 | GR106769 | CPU CARD | B ECO-R251873 | 1 | Each | Production |  | Part | GYRM | Preferred
3 | 0 | 10020993 | QUARTZ, 8 MHZ, 100PPM,SMD | C ECO-R252636 | 1 | Each | Production | Q1 | Part | CBRM | Preferred
3 | 0 | 10020994 | DIODE ZENER, 500MW, 12V, SOD-80C | C ECO-R252636 | 1 | Each | Production | D12 | Part | CBRM | Preferred
3 | 0 | 10022135 | CAPACITOR CERAMIC, 100NF, +/-10%, 50V, X7R,0805 | C ECO-R252633 | 6 | Each | Production | C46,C62,C69,C79,C82,C105 | Part | CBRM | Preferred
3 | 0 | 10022157 | TRANSISTOR, P CHANNEL, 50V, 0.13A, 5 OHM, SOT23 | C ECO-R252636 | 2 | Each | Production | T3,T19 | Part | CBRM | Preferred
3 | 0 | 10022505 | UART, LQFP64 | B ECO-R252636 | 1 | Each | Production | IC1 | Part | CBRM | Preferred
3 | 0 | 10022508 | CAPACITOR CERAMIC,10NF,+/-10%,50V,0603 | C ECO-R252633 | 6 | Each | Production | C39,C43,C45,C50,C53,C97 | Part | CBRM | Preferred
3 | 0 | 10022510 | CAPACITOR,330NF,+/-10%,16V,0805,X7R | C ECO-R252633 | 1 | Each | Production | C6 | Part | CBRM | Preferred
3 | 0 | 10022511 | TRANSCEIVER, 3.3V TO 5V,TSSOP | C ECO-R252636 | 1 | Each | Production | IC2 | Part | CBRM | Alternate
3 | 0 | 10022542 | CONNECTOR, O2 VALVE, 2 CONTACTS | C ECO-R252633 | 1 | Each | Production | J21 | Part | CBRM | Preferred
3 | 0 | 10022544 | RESISTOR, 470 OHM, 0.063W, +/-5% | C ECO-R252636 | 1 | Each | Production | L5 | Part | CBRM | Preferred
3 | 0 | 10022607 | CAPACITOR,100NF,16V,+/-10%,X7R,0402 | D EC113997 | 45 | Each | Production | C2,C4,C5,C9,C10,C11,C20,C22,C23,C24,C25,C26,C27,C28,C29,C30,C33,C36,C37,C42,C44,C49,C51,C60,C63,C66,C70,C74,C76,C77,C78,C80,C83,C87,C90,C91,C93,C95,C98,C103,C107,C110,C116,C120,C140 | Part | CBRM | Preferred
3 | 0 | 10022608 | CAPACITOR TANTALUM, 10UF, 25V, +/-10% | D EC074855 | 3 | Each | Production | C81,C85,C108 | Part | CBRM | Alternate
3 | 0 | 10022612 | MICROCONTROLLER, 16BITS, 512BYTE FLASH, 320KBYTE XFLASH | B ECO-R252636 | 1 | Each | Production | IC4 | Part | CBRM | Preferred
3 | 0 | 10022613 | CAPACITOR CERAMIC,4.7NF,+/-10%,50V,0603 | C ECO-R252636 | 6 | Each | Production | C61,C64,C68,C71,C96,C104 | Part | CBRM | Alternate
3 | 0 | 10022617 | RESISTOR, 4.7 K OHM, 0.063W +/-5% | C ECO-R252636 | 8 | Each | Production | R33,R34,R37,R38,R41,R42,R51,R72 | Part | CBRM | Preferred
3 | 0 | 10022622 | CAPACITOR ELECTROLYTIC, 220UF,16V+/-20% | C ECO-R252636 | 1 | Each | Production | C106 | Part | CBRM | Preferred
3 | 0 | 10022623 | CAPACITOR,47 PF,+/-5%,50V,0402 | C ECO-R252636 | 4 | Each | Production | C12,C13,C15,C86 | Part | CBRM | Preferred
3 | 0 | 10022632 | CAPACITOR CERAMIC,22PF,+/-5%,50V,0603 | C ECO-R252636 | 3 | Each | Production | C1,C3,C16 | Part | CBRM | Preferred
3 | 0 | 10022652 | DIODE SCHOTTKY, 30V, 200MA | C ECO-R252636 | 3 | Each | Production | D9,D10,D13 | Part | CBRM | Preferred
3 | 0 | 10022653 | DIODE SCHOTTKY DOUBLE,30V, 200MA,SOT23 | C ECO-R252636 | 1 | Each | Production | D14 | Part | CBRM | Preferred
3 | 0 | 10022654 | DIODE TRANSIENT 600W,36V | C EC093850 | 1 | Each | Production | D4 | Part | CBRM | Preferred
3 | 0 | 10022655 | DIODE ZENER, 0.35W,4.7V | C ECO-R252636 | 1 | Each | Production | D8 | Part | CBRM | Preferred
3 | 0 | 10022656 | DIODE SCHOTTKY, 3A, 40V | B ECO-R252636 | 1 | Each | Production | D11 | Part | CBRM | Preferred
3 | 0 | 10022697 | RESISTOR,470 OHM, 0.125W,+/-1%, 0805 | C ECO-R252636 | 2 | Each | Production | R66,R67 | Part | CBRM | Preferred
3 | 0 | 10022700 | RESISTOR,1.5K OHM,0.063W,+/-1%,0603 | C ECO-R252636 | 1 | Each | Production | R18 | Part | CBRM | Preferred
3 | 0 | 10022703 | FUSE, 500MA | B ECO-R252636 | 1 | Each | Production | FU2 | Part | CBRM | Preferred
3 | 0 | 10022705 | IC,16 BIT D TYPE 3STATE OP, LATCHES,SSOP | C ECO-R252636 | 1 | Each | Production | IC14 | Part | CBRM | Preferred
3 | 0 | 10022706 | IC AIR FLOW SENSOR,(0-1 LITRE) | A ECO-R252636 | 2 | Each | Production | IC15,IC17 | Part | CBRM | Preferred
3 | 0 | 10022731 | RESISTOR,3.3K OHM,0.063W,+/-1%,0603 | C ECO-R252636 | 1 | Each | Production | R11 | Part | CBRM | Preferred
3 | 0 | 10022732 | RESISTOR,100 K OHM, 0.063W +/-5% | C ECO-R252636 | 16 | Each | Production | R7,R8,R9,R12,R20,R21,R24,R26,R48,R55,R56,R59,R60,R61,R65,R68 | Part | CBRM | Preferred
3 | 0 | 10022736 | RESISTOR,1M OHM,0.063W,+/-1%,0603 | C ECO-R252636 | 1 | Each | Production | R4 | Part | CBRM | Preferred
3 | 0 | 10022879 | OCTAL BUS TRANSCEIVER | C ECO-R252636 | 1 | Each | Production | IC40 | Part | CBRM | Preferred
3 | 0 | 10022884 | LITHIUM, 3V, 35MAH | C ECO-R252636 | 1 | Each | Production | G1 | Part | CBRM | Preferred
3 | 0 | 10022892 | REGULATOR 3.3 V 2% 500MA LOW DROPOUT,DPACK | B ECO-R252636 | 1 | Each | Production | IC26 | Part | CBRM | Preferred
3 | 0 | 10022895 | REGULATOR, 5.5V TO 36V,3A | C ECO-R252636 | 1 | Each | Production | IC29 | Part | CBRM | Preferred
3 | 0 | 10022905 | IC,BUS SWITCH,SC70 | B ECO-R252636 | 1 | Each | Production | IC44 | Part | CBRM | Preferred
3 | 0 | 10022907 | SMD FERRITE 200MA | B ECO-R252636 | 36 | Each | Production | L1,L3,L4,L6,L9,L10,L12,L14,L15,L16,L17,L18,L21,L23,L24,L25,L26,L29,L31,L32,L33,L34,L35,L37,L42,L43,L44,L45,L46,L47,L48,L49,L50,L51,L52,L53 | Part | CBRM | Preferred
3 | 0 | 10022908 | INDUCTOR,33UH +/-10% | B ECO-R252636 | 1 | Each | Production | L2 | Part | CBRM | Preferred
3 | 0 | 10022911 | SMD FERRITE, 1A,1206 | B ECO-R252636 | 7 | Each | Production | L7,L8,L11,L19,L20,L22,L61 | Part | CBRM | Preferred
3 | 0 | 10022924 | TEST POINT | B ECO-R252633 | 2 | Each | Production | PT1,PT2 | Part | CBRM | Preferred
3 | 0 | 10022933 | RSPTRANSISTOR MOSFET, P CHANNEL, 30V,0.6A | B ECO-R252636 | 1 | Each | Production | T17 | Part | CBRM | Preferred
3 | 0 | 10022956 | TRANSISTOR, MOSFET, N-CHANNEL, 60V, 0.5A.SOT23 | B ECO-R252636 | 1 | Each | Production | T20 | Part | CBRM | Preferred
3 | 0 | 10022959 | CAPACITOR TANTALUM, 1UF,35V, +/-10% | D EC074855 | 5 | Each | Production | C7,C8,C31,C32,C34 | Part | CBRM | Alternate
3 | 0 | 10022960 | IC, 2 INPUT OR-GATE,SOT353 | C ECO-R252636 | 3 | Each | Production | IC5,IC42,IC43 | Part | CBRM | Preferred
3 | 0 | 10022961 | IC, FLASH MEMORY,TSOP48 | B ECO-R261408 | 1 | Each | Production | IC7 | Part | CBRM | Preferred
3 | 0 | 10022962 | CAPACITOR TANALUM, 47UF, 10V +/-10% | C EC074855 | 2 | Each | Production | C19,C75 | Part | CBRM | Preferred
3 | 0 | 10022963 | CAPACITOR ELECTROLYTIC, 100UF, 35V +/-20% | B ECO-R252636 | 1 | Each | Production | C21 | Part | CBRM | Preferred
3 | 0 | 10022964 | BUFFER WITH OPEN DRAIN OUTPUT,SOT23 | C ECO-R252636 | 3 | Each | Production | IC8,IC9,IC20 | Part | CBRM | Preferred
3 | 0 | 10022965 | IC,REALTIMECLOCK, TSSOP | C ECO-R252636 | 1 | Each | Production | IC10 | Part | CBRM | Alternate
3 | 0 | 10022966 | CAPACITOR CERAMIC, 220PF, 50V,+/-5%, NPO,0402 | C ECO-R252636 | 1 | Each | Production | C47 | Part | CBRM | Preferred
3 | 0 | 10022967 | CAPACITOR CERAMIC,1UF,16V,+/-10%, 0805 | D ECO-R252636 | 3 | Each | Production | C54,C112,C114 | Part | CBRM | Preferred
3 | 0 | 10022968 | CAP CERAMIC,220NF,25V,X7R,+/-10%,0805 | B ECO-R252636 | 4 | Each | Production | C59,C65,C94,C102 | Part | CBRM | Preferred
3 | 0 | 10022969 | DOUBLE AMPLIFIER RAIL TO RAIL, SO8 | C ECO-R252636 | 1 | Each | Production | IC11 | Part | CBRM | Preferred
3 | 0 | 10022970 | IC,MICROPROCESSOR SUPERVISOR CIRCUIT,SO8 | C ECO-R252636 | 1 | Each | Production | IC12 | Part | CBRM | Preferred
3 | 0 | 10022971 | CAPACITOR CERAMIC, 1NF,50V,+/-10%, 0402 | C ECO-R252636 | 1 | Each | Production | C84 | Part | CBRM | Preferred
3 | 0 | 10022973 | CAPACITOR TANTALUM, 22UF, 10V,+/-10% | C EC074855 | 2 | Each | Production | C89,C92 | Part | CBRM | Preferred
3 | 0 | 10022974 | RESET CIRCUIT, SUPERVISOR VOLTAGE 5V,SOT23 | B ECO-R252636 | 2 | Each | Production | IC24,IC25 | Part | CBRM | Preferred
3 | 0 | 10022975 | CAPACITOR CERAMIC, 150PF,50V,+/-5,NPO, 0402 | C ECO-R252636 | 6 | Each | Production | C99,C115,C121,C122,C123,C124 | Part | CBRM | Preferred
3 | 0 | 10022976 | CAPACITOR CERAMIC,4.7NF,25V,+/-10%,0402 | B ECO-R252636 | 1 | Each | Production | C101 | Part | CBRM | Preferred
3 | 0 | 10022978 | CAPACITOR TANTALUM,10UF, 50V,+/-10% | D EC074855 | 1 | Each | Production | C117 | Part | CBRM | Preferred
3 | 0 | 10023039 | IC,REFERENCE VOLTAGE 5V FIXED - 10 MA,SO8 | B ECO-R252636 | 1 | Each | Production | IC21 | Part | CBRM | Preferred
3 | 0 | 10023040 | IC,REFERENCE VOLTAGE 10V FIXED - 10 MA,SO8 | B ECO-R252636 | 1 | Each | Production | IC23 | Part | CBRM | Preferred
3 | 0 | 10023041 | IC, SUPERVISOR VOLTAGE 3.3 V,SOT23 | B ECO-R252636 | 1 | Each | Production | IC36 | Part | CBRM | Preferred
3 | 0 | 10023117 | IC, PRESSURE TRANSDUCER,(-10/+100 MBAR) | B ECO-R252636 | 3 | Each | Production | IC16,IC18,IC22 | Part | CBRM | Preferred
3 | 0 | 10023118 | IC, INVERTER,SOT353 | C ECO-R252636 | 2 | Each | Production | IC39,IC41 | Part | CBRM | Preferred
3 | 0 | 10023119 | 2 INPUT AND-GATE,SOT353 | C ECO-R252636 | 1 | Each | Production | IC38 | Part | CBRM | Preferred
3 | 0 | 10023158 | EEPROM, SOIC8 | A ECO-R252636 | 1 | Each | Production | IC32 | Part | CBRM | Preferred
3 | 0 | 10023159 | IC, BAROMETRIC PRESSURE SENSOR | B ECO-R252636 | 1 | Each | Production | IC33 | Part | CBRM | Preferred
3 | 0 | 10023185 | RESISTANCE, 0 OHM,0603 | C ECO-R252636 | 4 | Each | Production | JP1,JP6,R45,R69 | Part | CBRM | Preferred
3 | 0 | 10023186 | FERRITE, 2.5, 3A | B ECO-R252636 | 1 | Each | Production | L30 | Part | CBRM | Preferred
3 | 0 | 10023187 | RESISTOR 1.5K OHM, 0603, +/-5% | C ECO-R252636 | 2 | Each | Production | R2,R10 | Part | CBRM | Preferred
3 | 0 | 10023188 | RESISTOR, 220 K OHM, 0603,+/-5% | C ECO-R252636 | 1 | Each | Production | R3 | Part | CBRM | Preferred
3 | 0 | 10023189 | RESISTOR, 100 OHM, 0.063W +/-5% | C ECO-R252636 | 1 | Each | Production | R1 | Part | CBRM | Preferred
3 | 0 | 10023190 | RESISTOR, 620 OHM, 0.125W,+/-5%,0805 | B ECO-R252636 | 3 | Each | Production | R13,R25,R27 | Part | CBRM | Preferred
3 | 0 | 10023235 | RESISTOR, 56K OHM, 0603, +/-1% | C ECO-R252636 | 1 | Each | Production | R14 | Part | CBRM | Preferred
3 | 0 | 10023237 | RESISTOR, 150 OHM, 0805, +/-5% | C ECO-R252636 | 1 | Each | Production | R16 | Part | CBRM | Preferred
3 | 0 | 10023238 | RESISTOR, 15K OHM, 0603, +/-1% | D ECO-R252636 | 2 | Each | Production | R17,R40 | Part | CBRM | Preferred
3 | 0 | 10023239 | RESISTOR, 75K OHM, 0603, +/-1% | B ECO-R252636 | 2 | Each | Production | R19,R36 | Part | CBRM | Preferred
3 | 0 | 10023240 | RESISTOR, 180 OHM, 0805, +/-5% | C ECO-R252636 | 5 | Each | Production | R22,R23,R31,R35,R44 | Part | CBRM | Preferred
3 | 0 | 10023242 | RESISTOR 10 OHM, 0.125W, +/-5%,0805 | C ECO-R252636 | 1 | Each | Production | R52 | Part | CBRM | Preferred
3 | 0 | 10023243 | RSP TRANSISTOR, BIPOLAR, PNP, 100V, 5A, SOT223 | B ECO-R252636 | 3 | Each | Production | T10,T11,T12 | Part | CBRM | Preferred
3 | 0 | 10023244 | BUZZER, 12V, 30MA, 85DB | B ECO-R252636 | 1 | Each | Production | BUZ1 | Part | CBRM | Preferred
3 | 0 | 10023250 | CRYSTAL QUARTZ 32.768KHZ | C ECO-R252636 | 1 | Each | Production | Q5 | Part | CBRM | Preferred
3 | 0 | 10023251 | MEMORY NAND FLASH, 1G, 2.7 TO 3.6V, BUS X 8,TSOP | E ECO-R252636 | 1 | Each | Production | IC13 | Part | CBRM | Preferred
3 | 0 | 10023252 | RELAY,LOW VOLTAGE 1A COIL 5VDC | D ECO-R252636 | 1 | Each | Production | RL1 | Part | CBRM | Preferred
3 | 0 | 10023253 | RESISTOR ARRAY, 6.8K OHM, +/-5%, 1206 | D ECO-R252636 | 6 | Each | Production | RS1,RS3,RS4,RS5,RS6,RS8 | Part | CBRM | Preferred
3 | 0 | 10023254 | RSP RESISTOR ARRAY, 15K OHM,+/-5%, 1206 | C ECO-R252636 | 2 | Each | Production | RS2,RS7 | Part | CBRM | Preferred
3 | 0 | 10023291 | CRYSTAL, QUARTZ, 3.6864MHZ | D ECO-R252636 | 1 | Each | Production | Q2 | Part | CBRM | Preferred
3 | 0 | 10023295 | FLAT FERRITE CORE | B ECO-R252636 | 1 | Each | Production | FER1 | Part | CBRM | Preferred
3 | 0 | 10025112 | 3 WAY, PROPORTIONAL VALVE | B ECO-R252636 | 1 | Each | Production | V2 | Part | CBRM | Preferred
3 | 0 | 10052329 | HEADER CONNECTOR, RIGHT ANGLE, 10 PINS | B ECO-R252636 | 1 | Each | Production | J4 | Part | CBRM | Preferred
3 | 0 | 10052331 | HEADER CONNECTOR, RIGHT ANGLE, 26 PINS | B ECO-R252636 | 1 | Each | Production | J7 | Part | CBRM | Preferred
3 | 0 | 10095973 | CAPACITOR ARRAY, 47PF, 50V, +/-10%,NPO,0612 | A ECO-R252633 | 11 | Each | Production | C14,C17,C18,C38,C41,C52,C55,C56,C58,C100,C111 | Part | CBRM | Preferred
3 | 0 | 10095983 | RESISTOR, 22 K OHM,0.063W, +/-1%,0603 | A ECO-R252633 | 1 | Each | Production | R46 | Part | CBRM | Preferred
3 | 0 | 10097252 | CAPACITOR ELECTROLYTIC, 1000UF,35V,+/-20% | A ECO-R252636 | 1 | Each | Production | C88 | Part | CBRM | Preferred
3 | 0 | 10097253 | DIODE SCHOTTKY, 40V, 1A | A ECO-R252636 | 4 | Each | Production | D6,D7,D15,D16 | Part | CBRM | Preferred
3 | 0 | 10097255 | STATIC RAM, 256K X 16 BIT, TSOP2 | A ECO-R252636 | 1 | Each | Production | IC3 | Part | CBRM | Preferred
3 | 0 | 10097256 | CONNECTOR, 22 CONTACTS | B ECO-R252636 | 1 | Each | Production | J1 | Part | CBRM | Preferred
3 | 0 | 10097257 | CONNECTOR, 8 CONTACTS | A ECO-R252636 | 1 | Each | Production | J2 | Part | CBRM | Preferred
3 | 0 | 10097259 | CONNECTOR, SPO2, 12 CONTACTS | A ECO-R252636 | 1 | Each | Production | J3 | Part | CBRM | Preferred
3 | 0 | 10097260 | CONNECTOR, TEMPERATURE MEASURE, 2 CONTACTS | A ECO-R252636 | 2 | Each | Production | J5,J19 | Part | CBRM | Preferred
3 | 0 | 10097262 | CONNECTOR,FIO2, 3 CONTACTS | A ECO-R252636 | 1 | Each | Production | J11 | Part | CBRM | Preferred
3 | 0 | 10097263 | CONNECTOR, 40 CONTACTS | A ECO-R252636 | 1 | Each | Production | J17 | Part | CBRM | Preferred
3 | 0 | 10097265 | CONNECTOR, BUZZER CARD, 7 CONTACTS | A ECO-R252636 | 1 | Each | Production | J18 | Part | CBRM | Preferred
3 | 0 | 10097266 | RESISTOR,10K OHM, 0.063W,+/-5%,0603 | A ECO-R252636 | 10 | Each | Production | R5,R6,R28,R29,R32,R43,R53,R54,R62,R70 | Part | CBRM | Preferred
3 | 0 | 10097268 | RESISTOR, 10.5K OHM, 0603, +/-0.1% | A ECO-R252636 | 1 | Each | Production | R15 | Part | CBRM | Preferred
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
