darwinbeing/PB560/pb560-vent-files-4/BOM Drawings/PB560 PowerPack/10106052C00/MOLEX 52207-1960.SLDASM

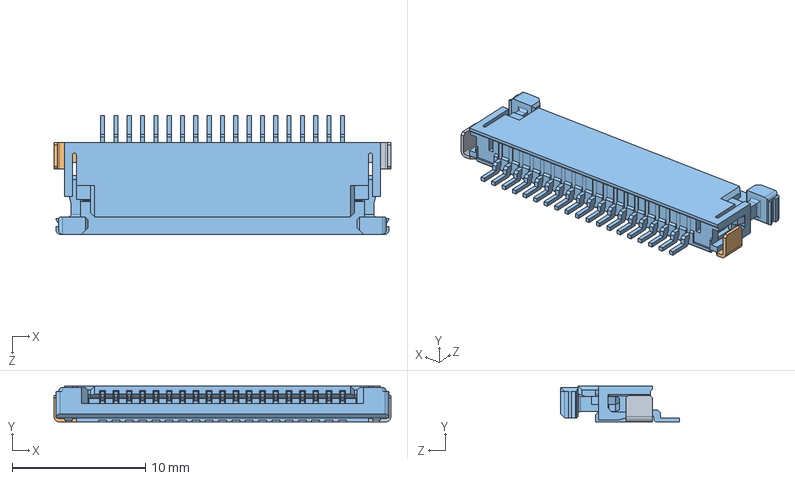
[picture p22: CAD file, 2020-04-04]
pb560-vent-files-4/BOM Drawings/PB560 PowerPack/10106052C00/MOLEX 52207-1960.SLDASM
25.3 x 2.70 x 8.90 mm
