darwinbeing/PB560/medtronic-pb560-ventilator-system-file-set-2/3D CAD Models/PB560 Assy/alimentation xp.sldasm

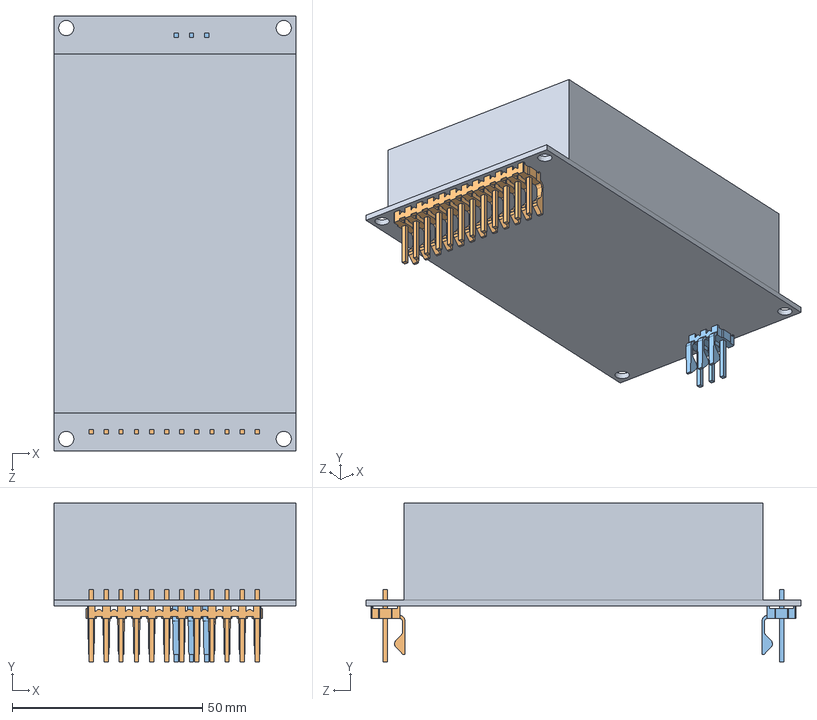
[picture p23: CAD file, 2020-04-04]
medtronic-pb560-ventilator-system-file-set-2/3D CAD Models/PB560 Assy/alimentation xp.sldasm
63.5 x 41.7 x 114.3 mm
alimentation phase 2
