darwinbeing/PB560/medtronic-pb560-ventilator-system-file-set-2/3D CAD Models/PB560 Assy/Batt Assy.SLDASM

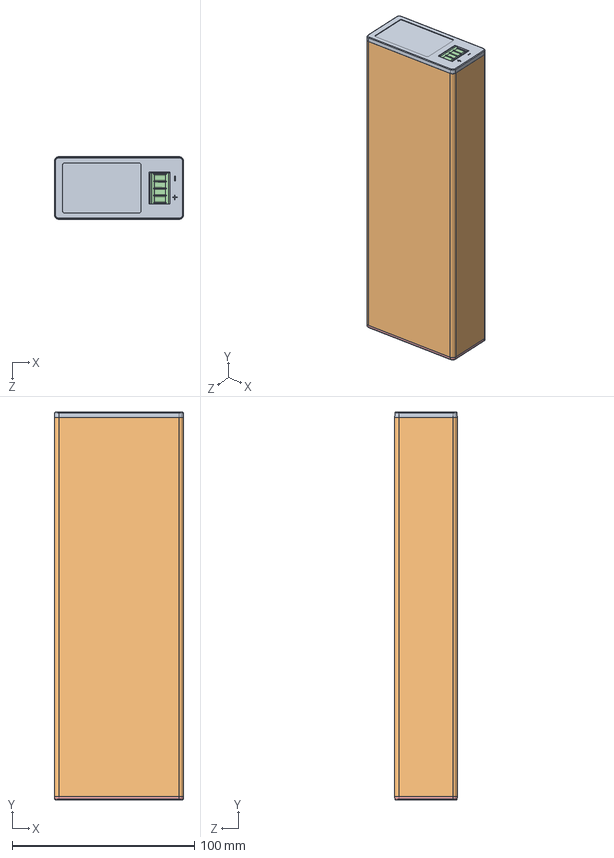
[picture p24: CAD file, 2020-04-04]
medtronic-pb560-ventilator-system-file-set-2/3D CAD Models/PB560 Assy/Batt Assy.SLDASM
71.0 x 213.0 x 34.5 mm
Front End Cap
Extruded housing
Batt PCB
Batt Contacts tab
Back End Cap
