darwinbeing/PB560/medtronic-pb560-ventilator-system-file-set-2/3D CAD Models/PB560 Assy/valve chiprop.SLDASM

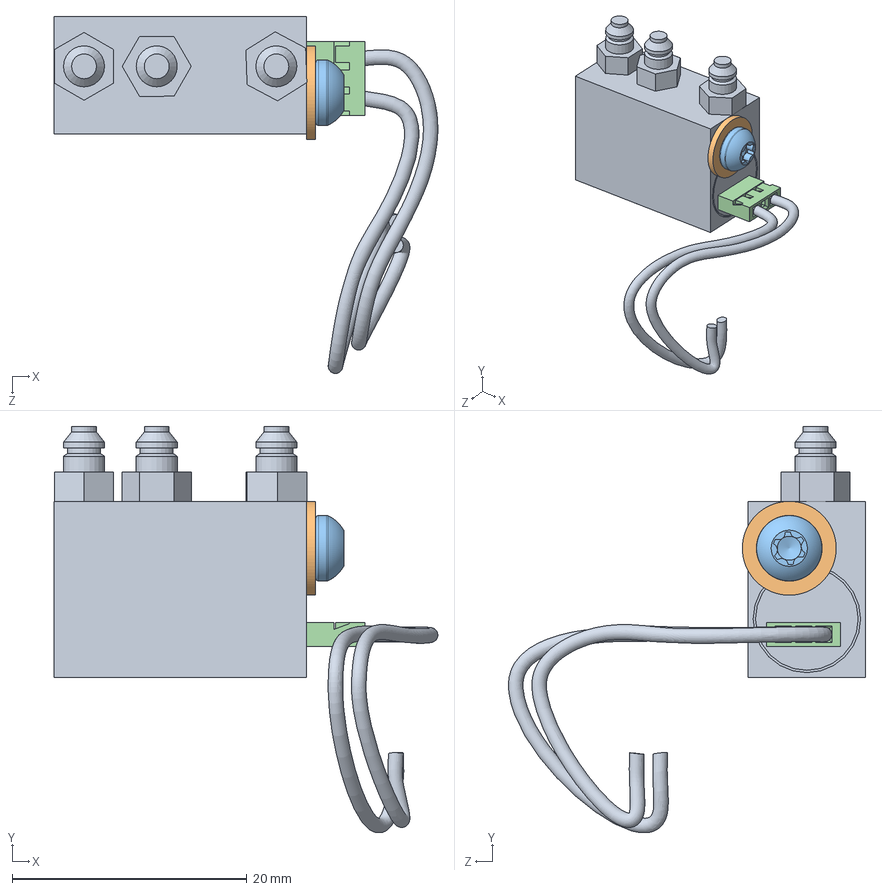
[picture p25: CAD file, 2020-04-04]
medtronic-pb560-ventilator-system-file-set-2/3D CAD Models/PB560 Assy/valve chiprop.SLDASM
32.7 x 34.7 x 30.4 mm
valve chiprop
2004200 Rondelle plate - MN INOX 3 x 8 EP 0.8
2966100 Vis TCB M3 x 5 exalobes acier zingué
Exh Valve connector
