darwinbeing/PB560/medtronic-pb560-ventilator-system-file-set-2/3D CAD Models/PB560 Assy/Batt PCB Assy.SLDASM

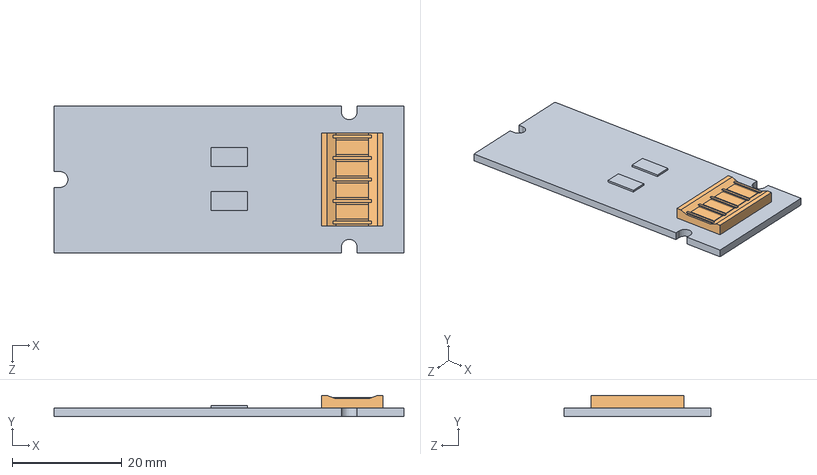
[picture p26: CAD file, 2020-04-04]
medtronic-pb560-ventilator-system-file-set-2/3D CAD Models/PB560 Assy/Batt PCB Assy.SLDASM
63.9 x 3.85 x 26.9 mm
Batt PCB
Batt Contacts tab
