darwinbeing/PB560/pb560-vent-files-4/BOM Drawings/PB560 Ventilator/10096510/10096506/10096506A00/10096506A00/eqfs.dxf

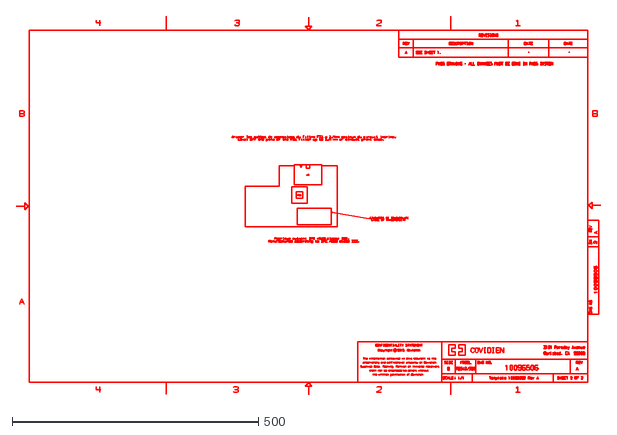
[picture p28: CAD file, 2020-04-04]
pb560-vent-files-4/BOM Drawings/PB560 Ventilator/10096510/10096506/10096506A00/10096506A00/eqfs.dxf
1186.1 x 768.8
