darwinbeing/PB560/pb560-vent-files-4/BOM Drawings/PB560 PowerPack/10109797A00/HS Label.SLDPRT

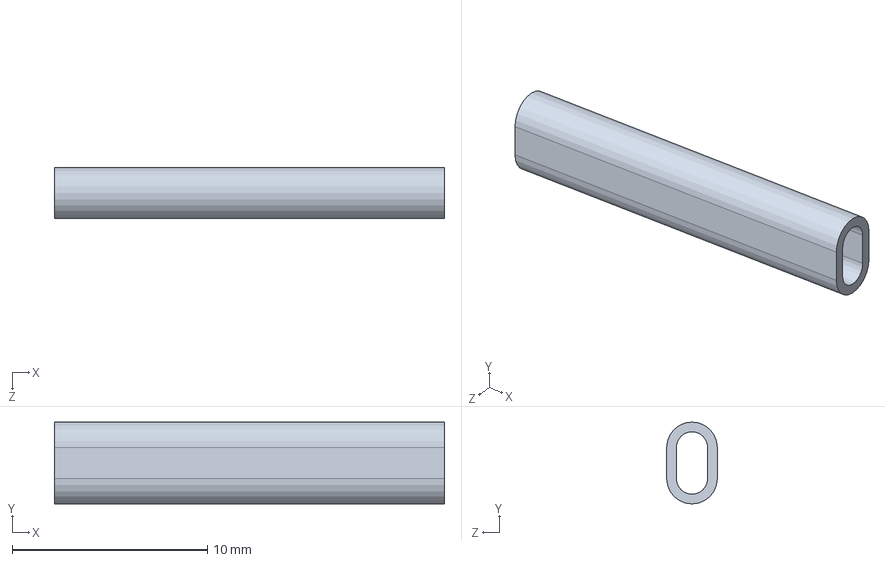
[picture p29: CAD file, 2020-04-04]
pb560-vent-files-4/BOM Drawings/PB560 PowerPack/10109797A00/HS Label.SLDPRT
20.0 x 4.20 x 2.60 mm
