darwinbeing/PB560/pb560-vent-files-4/BOM Drawings/PB560 PowerPack/10113688A00/2-520336-2.SLDPRT

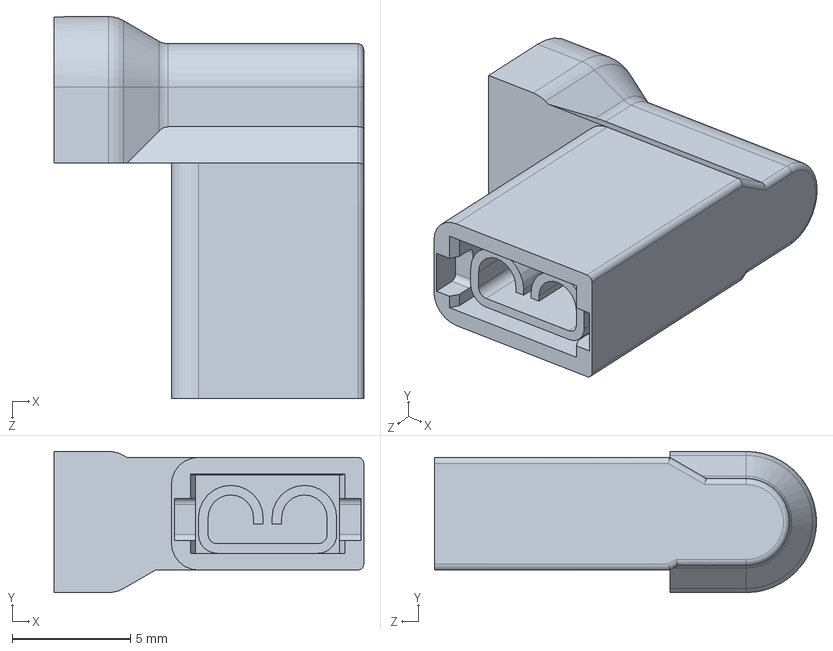
[picture p30: CAD file, 2020-04-04]
pb560-vent-files-4/BOM Drawings/PB560 PowerPack/10113688A00/2-520336-2.SLDPRT
13.1 x 5.97 x 16.1 mm
