darwinbeing/PB560/pb560-vent-files-4/BOM Drawings/PB560 PowerPack/10106052C00/JST S2B-ZR-SM4A-TF.SLDPRT

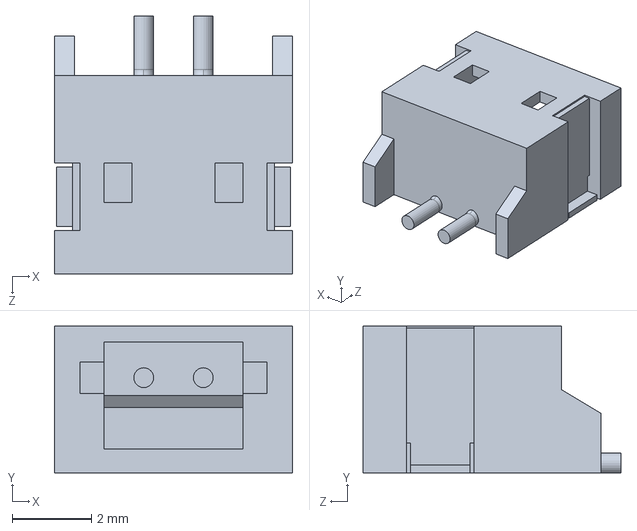
[picture p32: CAD file, 2020-04-04]
pb560-vent-files-4/BOM Drawings/PB560 PowerPack/10106052C00/JST S2B-ZR-SM4A-TF.SLDPRT
6.00 x 3.70 x 6.50 mm
