darwinbeing/PB560/pb560-vent-files-4/BOM Drawings/PB560 PowerPack/10109799A00/2-520129-2.SLDPRT

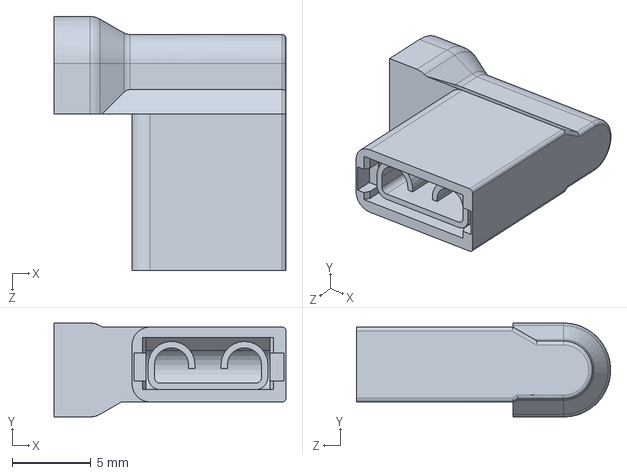
[picture p33: CAD file, 2020-04-04]
pb560-vent-files-4/BOM Drawings/PB560 PowerPack/10109799A00/2-520129-2.SLDPRT
14.7 x 5.97 x 16.1 mm
