darwinbeing/PB560/pb560-vent-files-4/BOM Drawings/PB560 PowerPack/10109802B00/Switchcraft 761KS15 Terminal spacer.SLDPRT

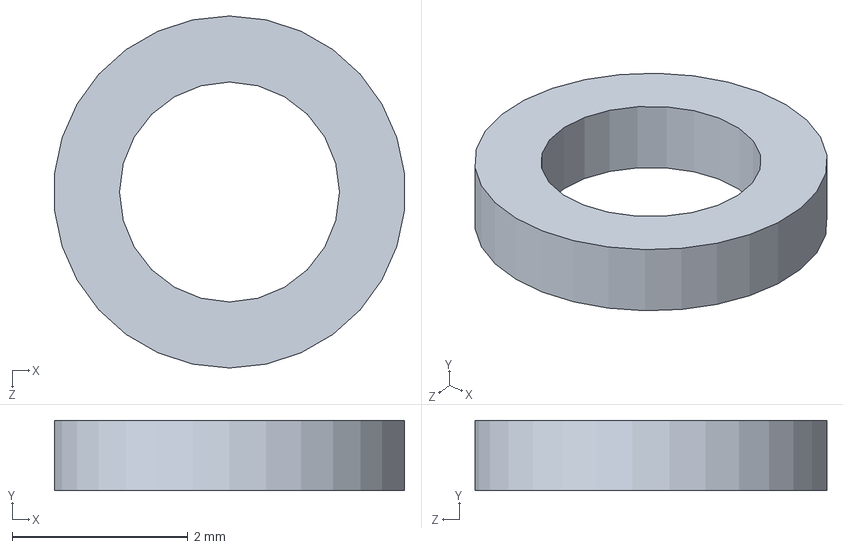
[picture p34: CAD file, 2020-04-04]
pb560-vent-files-4/BOM Drawings/PB560 PowerPack/10109802B00/Switchcraft 761KS15 Terminal spacer.SLDPRT
3.98 x 0.8 x 4.00 mm
