darwinbeing/PB560/pb560-vent-files-4/BOM Drawings/PB560 PowerPack/10110230A00 (1)/KerbKonus_307000030100.SLDPRT

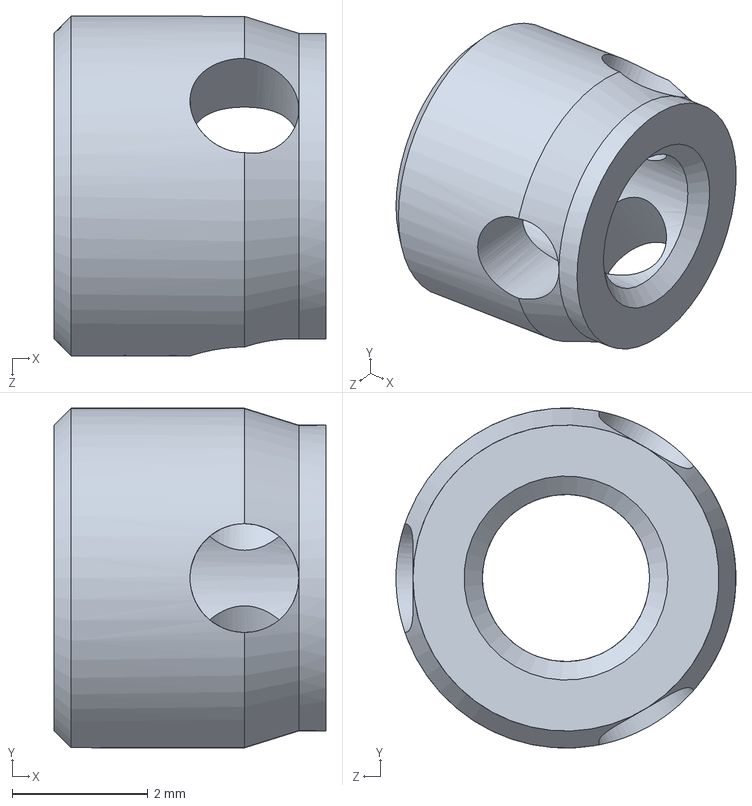
[picture p37: CAD file, 2020-04-04]
pb560-vent-files-4/BOM Drawings/PB560 PowerPack/10110230A00 (1)/KerbKonus_307000030100.SLDPRT
4.00 x 5.00 x 5.00 mm
