darwinbeing/PB560/pb560-vent-files-4/BOM Drawings/PB560 PowerPack/10109800A00/TE 62109-2.SLDPRT

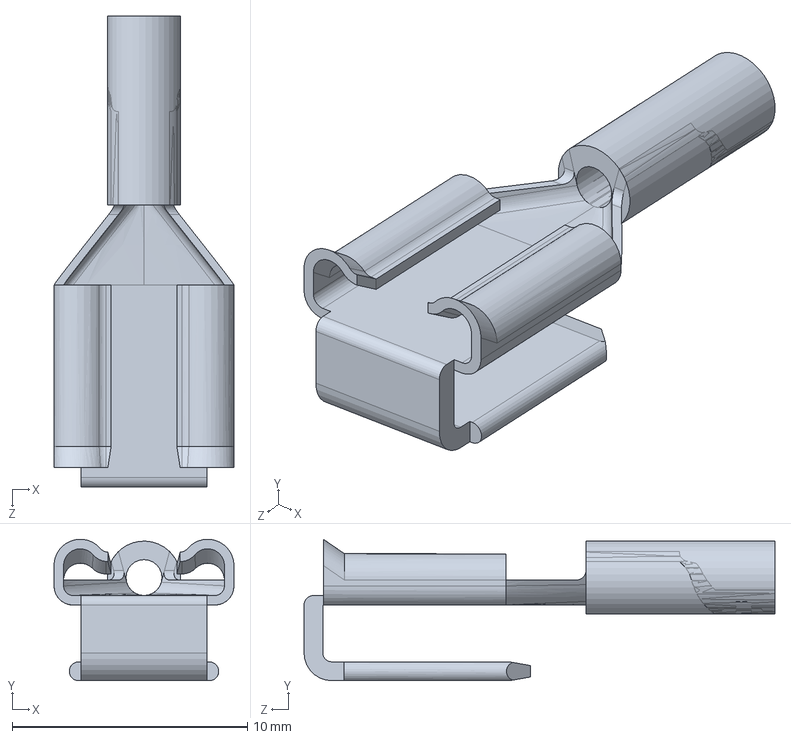
[picture p38: CAD file, 2020-04-04]
pb560-vent-files-4/BOM Drawings/PB560 PowerPack/10109800A00/TE 62109-2.SLDPRT
7.65 x 6.01 x 20.0 mm
