darwinbeing/PB560/pb560-vent-files-4/BOM Drawings/PB560 PowerPack/10109802B00/Switchcraft 761KS15 Terminals.SLDPRT

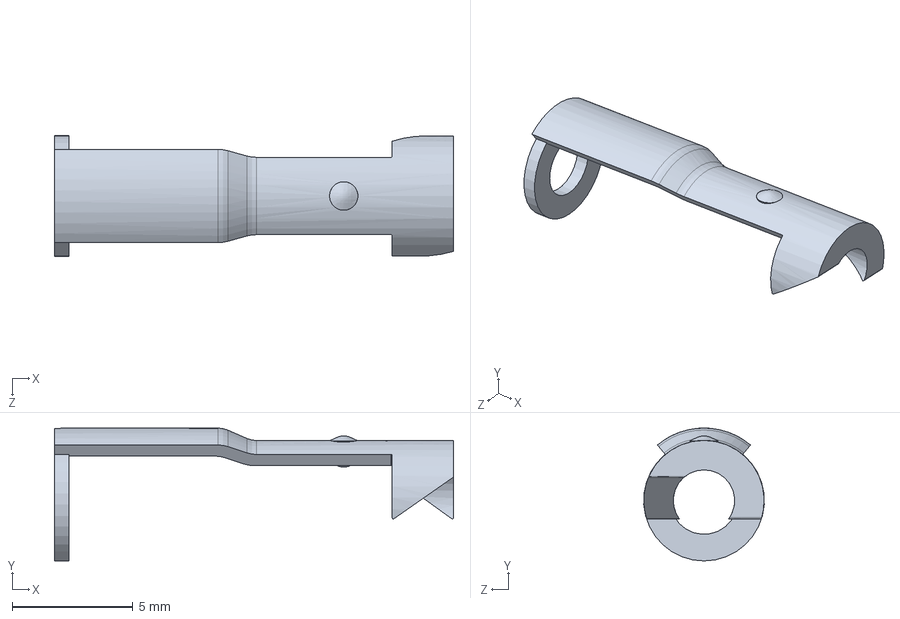
[picture p39: CAD file, 2020-04-04]
pb560-vent-files-4/BOM Drawings/PB560 PowerPack/10109802B00/Switchcraft 761KS15 Terminals.SLDPRT
16.5 x 5.50 x 4.99 mm
