darwinbeing/PB560/medtronic-pb560-ventilator-system-file-set-2/3D CAD Models/PB560 Assy/Joint blindage conducteur 72x21xép4.SLDPRT

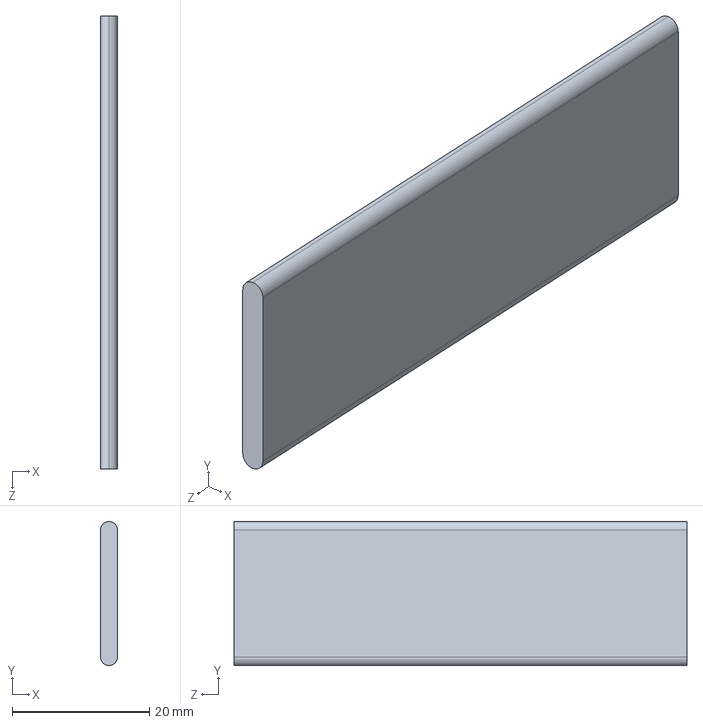
[picture p40: CAD file, 2020-04-04]
medtronic-pb560-ventilator-system-file-set-2/3D CAD Models/PB560 Assy/Joint blindage conducteur 72x21xép4.SLDPRT
2.50 x 21.0 x 66.0 mm
