darwinbeing/PB560/pb560-vent-files-4/BOM Drawings/PB560 PowerPack/10109801A00/Socket_Switchcraft L712AS.SLDPRT

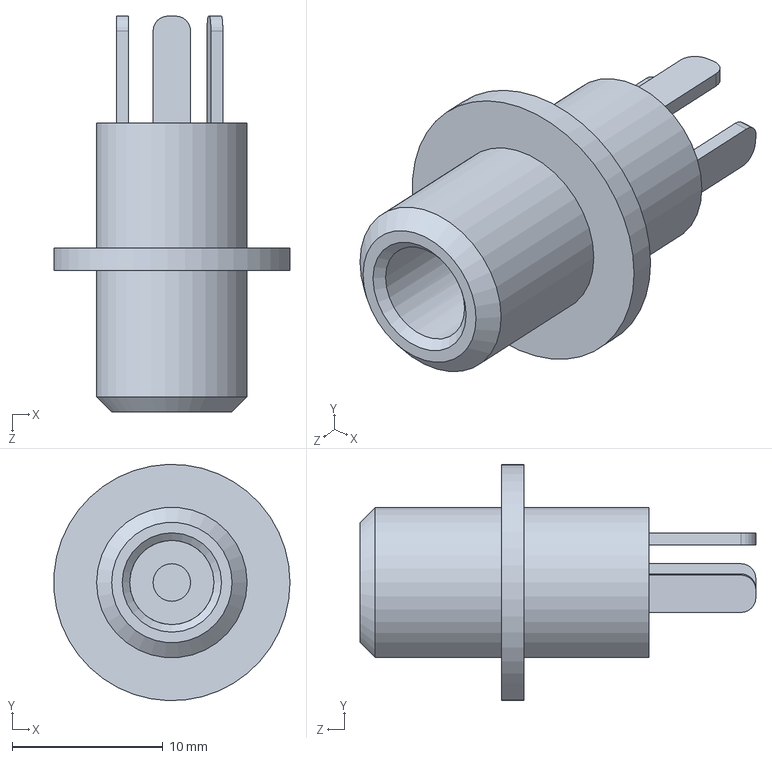
[picture p42: CAD file, 2020-04-04]
pb560-vent-files-4/BOM Drawings/PB560 PowerPack/10109801A00/Socket_Switchcraft L712AS.SLDPRT
15.7 x 15.7 x 26.3 mm
