darwinbeing/PB560/pb560-vent-files-4/BOM Drawings/PB560 PowerPack/10109802B00/Straight DC OM PLUG_Switchcraft.SLDPRT

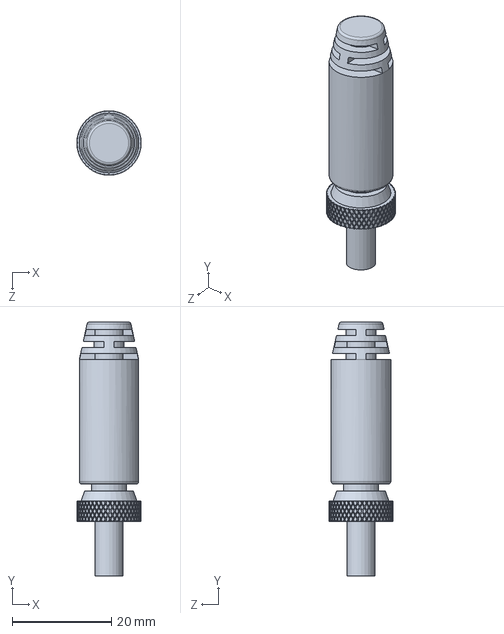
[picture p43: CAD file, 2020-04-04]
pb560-vent-files-4/BOM Drawings/PB560 PowerPack/10109802B00/Straight DC OM PLUG_Switchcraft.SLDPRT
12.9 x 51.1 x 12.9 mm
