darwinbeing/PB560/pb560-vent-files-4/BOM Drawings/PB560 PowerPack/10109802B00/Switchcraft 761KS15 Centre pin.SLDPRT

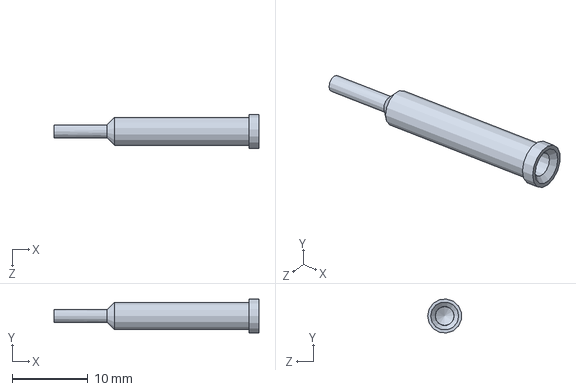
[picture p47: CAD file, 2020-04-04]
pb560-vent-files-4/BOM Drawings/PB560 PowerPack/10109802B00/Switchcraft 761KS15 Centre pin.SLDPRT
27.0 x 4.48 x 4.45 mm
