darwinbeing/PB560/medtronic-pb560-ventilator-system-file-set-2/3D CAD Models/PB560 Assy/Rondelle plate - ZU  3 x 6 EP 0.8.sldprt

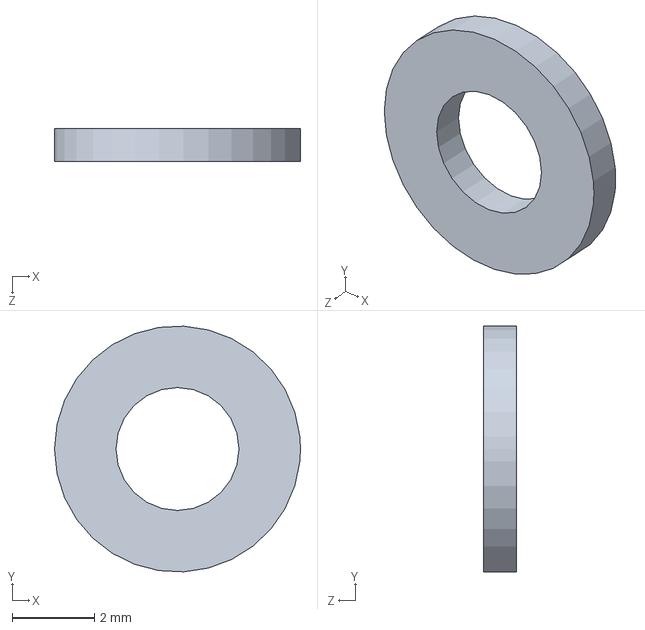
[picture p55: CAD file, 2020-04-04]
medtronic-pb560-ventilator-system-file-set-2/3D CAD Models/PB560 Assy/Rondelle plate - ZU 3 x 6 EP 0.8.sldprt
6.00 x 5.99 x 0.8 mm
