darwinbeing/PB560/medtronic-pb560-ventilator-system-file-set-2/3D CAD Models/PB560 Assy/tuyau débit expi P1.SLDPRT

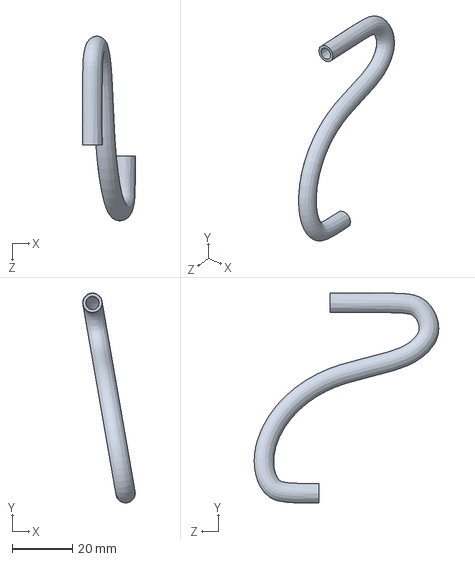
[picture p57: CAD file, 2020-04-04]
medtronic-pb560-ventilator-system-file-set-2/3D CAD Models/PB560 Assy/tuyau débit expi P1.SLDPRT
17.5 x 69.7 x 61.3 mm
