darwinbeing/PB560/medtronic-pb560-ventilator-system-file-set-2/3D CAD Models/PB560 Assy/26-48-1035.SLDPRT

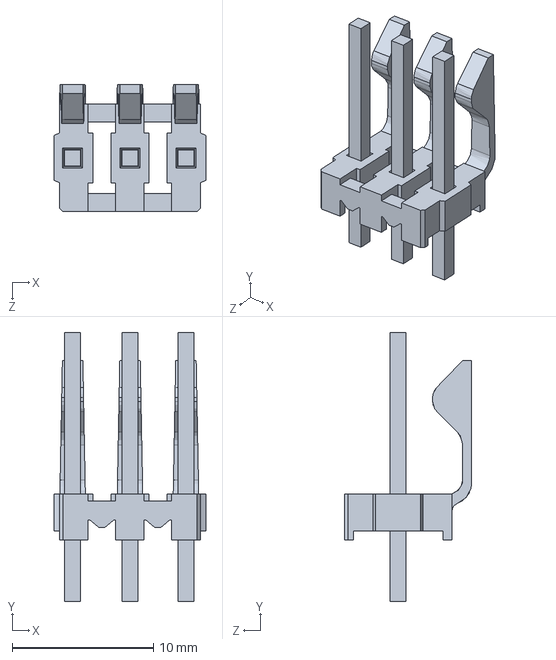
[picture p60: CAD file, 2020-04-04]
medtronic-pb560-ventilator-system-file-set-2/3D CAD Models/PB560 Assy/26-48-1035.SLDPRT
10.7 x 19.1 x 9.02 mm
