darwinbeing/PB560/medtronic-pb560-ventilator-system-file-set-2/3D CAD Models/PB560 Assy/feritte nappe afficheur.SLDPRT

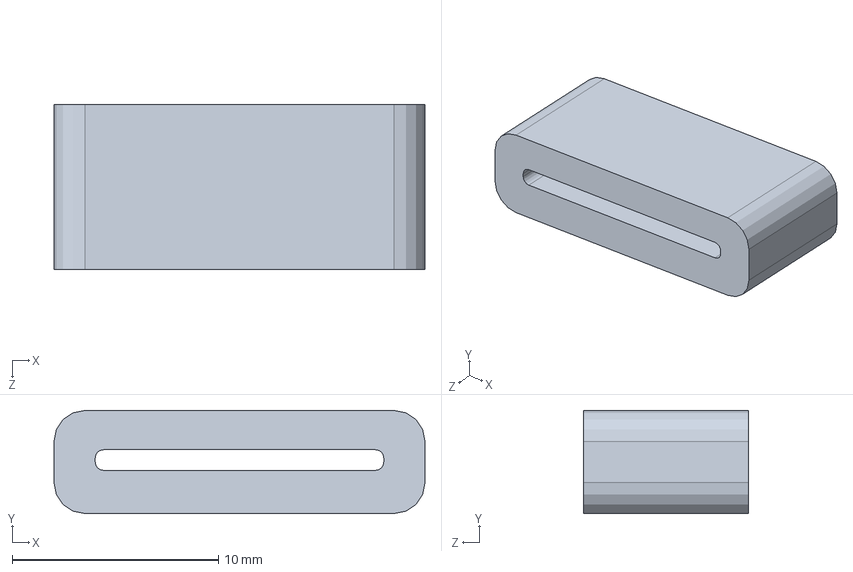
[picture p64: CAD file, 2020-04-04]
medtronic-pb560-ventilator-system-file-set-2/3D CAD Models/PB560 Assy/feritte nappe afficheur.SLDPRT
18.0 x 5.00 x 8.00 mm
