darwinbeing/PB560/medtronic-pb560-ventilator-system-file-set-2/3D CAD Models/PB560 Assy/connecteur USB A vertical.SLDPRT

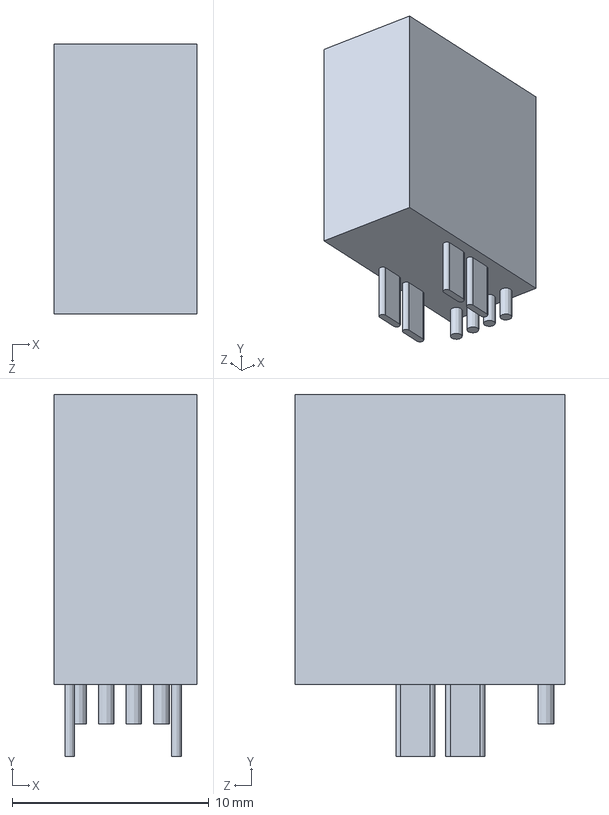
[picture p72: CAD file, 2020-04-04]
medtronic-pb560-ventilator-system-file-set-2/3D CAD Models/PB560 Assy/connecteur USB A vertical.SLDPRT
7.25 x 18.4 x 13.7 mm
