darwinbeing/PB560/medtronic-pb560-ventilator-system-file-set-2/3D CAD Models/PB560 Assy/tuyau pression vanne pilot1.6x4.8.SLDPRT

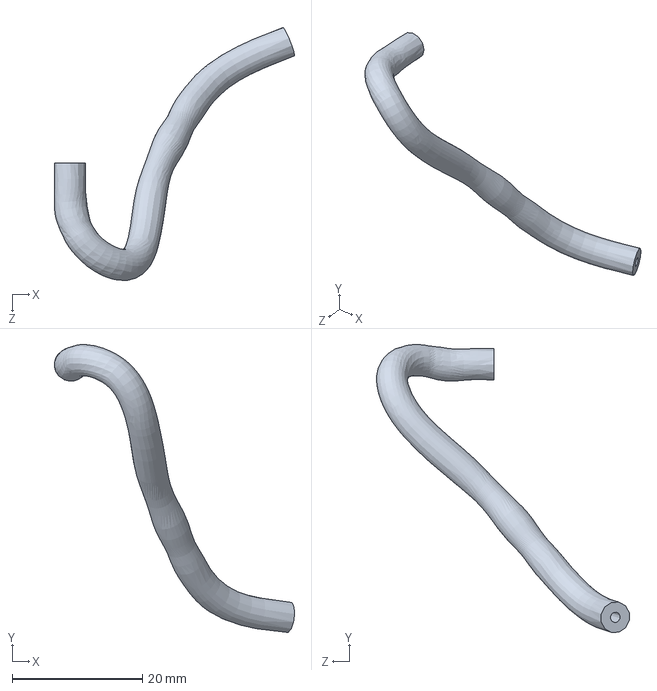
[picture p74: CAD file, 2020-04-04]
medtronic-pb560-ventilator-system-file-set-2/3D CAD Models/PB560 Assy/tuyau pression vanne pilot1.6x4.8.SLDPRT
36.8 x 44.2 x 38.7 mm
