darwinbeing/PB560/medtronic-pb560-ventilator-system-file-set-2/3D CAD Models/PB560 Assy/MOLEX 43650-0212.SLDPRT

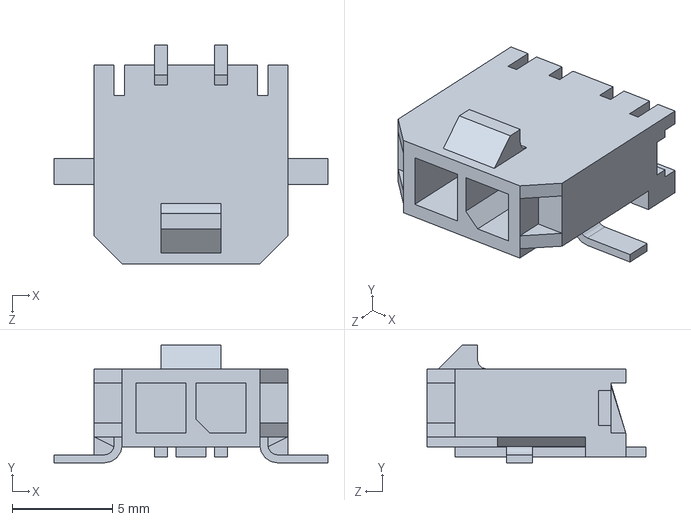
[picture p77: CAD file, 2020-04-04]
medtronic-pb560-ventilator-system-file-set-2/3D CAD Models/PB560 Assy/MOLEX 43650-0212.SLDPRT
13.6 x 5.87 x 10.9 mm
