darwinbeing/PB560/medtronic-pb560-ventilator-system-file-set-2/3D CAD Models/PB560 Assy/tuyau débit expi P2.SLDPRT

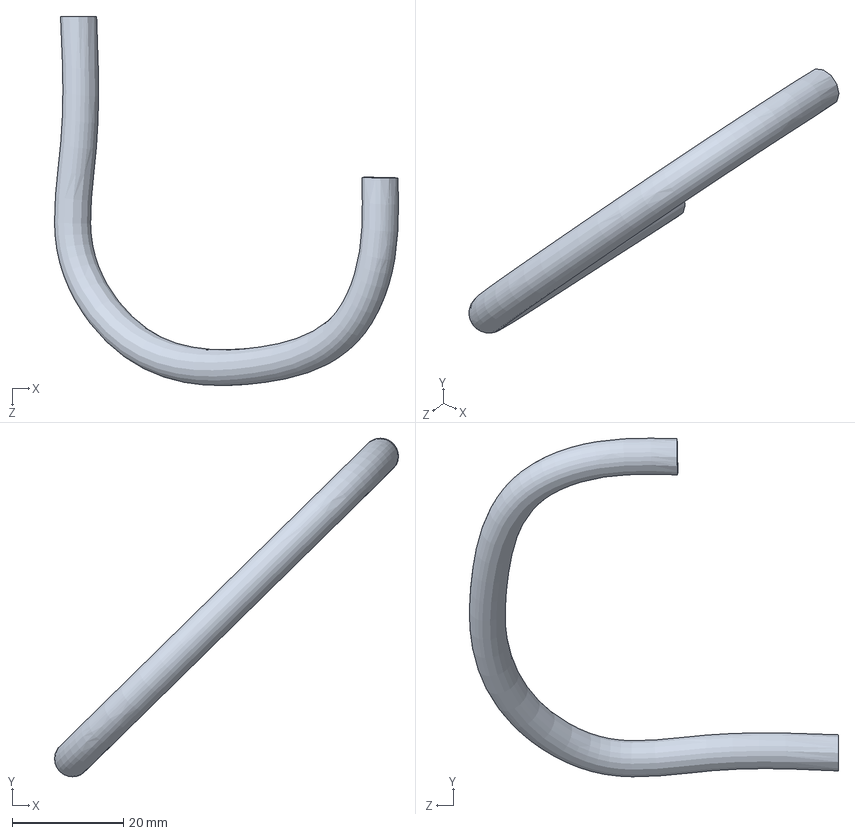
[picture p79: CAD file, 2020-04-04]
medtronic-pb560-ventilator-system-file-set-2/3D CAD Models/PB560 Assy/tuyau débit expi P2.SLDPRT
61.8 x 60.8 x 66.3 mm
