darwinbeing/PB560/medtronic-pb560-ventilator-system-file-set-2/3D CAD Models/PB560 Assy/carte clairitec.SLDPRT

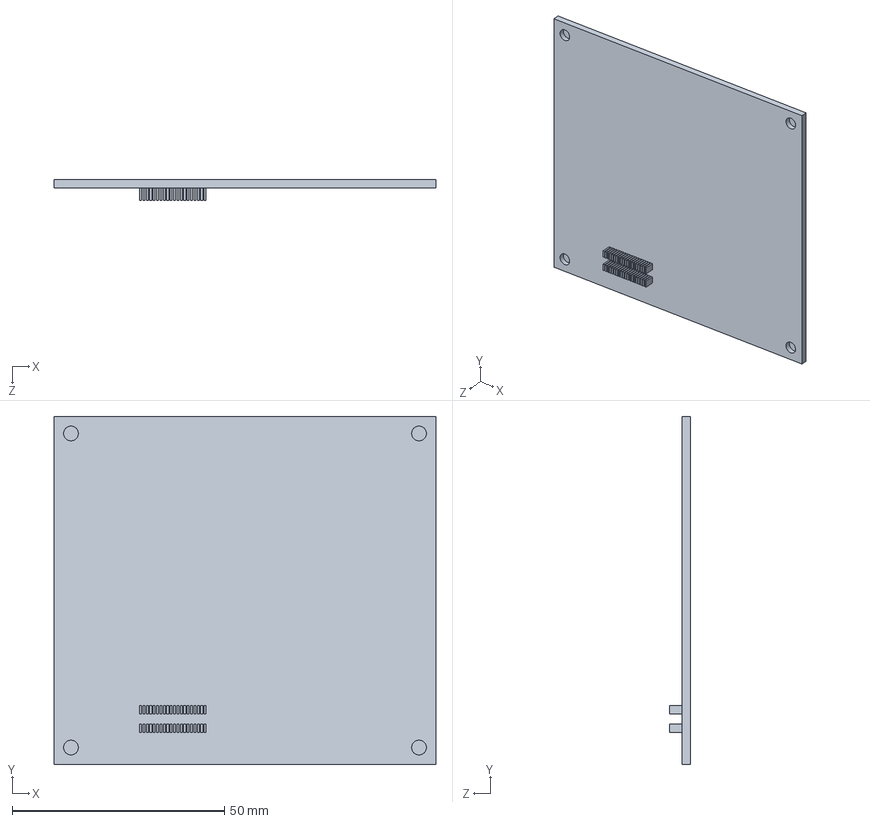
[picture p81: CAD file, 2020-04-04]
medtronic-pb560-ventilator-system-file-set-2/3D CAD Models/PB560 Assy/carte clairitec.SLDPRT
90.0 x 82.0 x 5.00 mm
