darwinbeing/PB560/medtronic-pb560-ventilator-system-file-set-2/3D CAD Models/PB560 Assy/cache transfo.SLDPRT

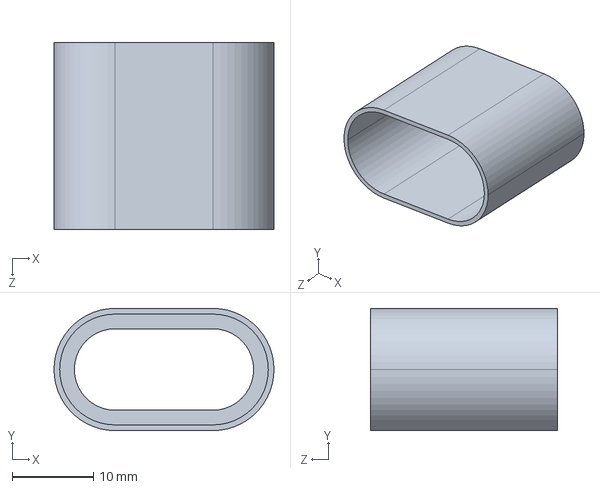
[picture p87: CAD file, 2020-04-04]
medtronic-pb560-ventilator-system-file-set-2/3D CAD Models/PB560 Assy/cache transfo.SLDPRT
27.0 x 15.0 x 23.0 mm
