darwinbeing/PB560/medtronic-pb560-ventilator-system-file-set-2/3D CAD Models/PB560 Assy/702-09 Entretoise AV Legendair.SLDPRT

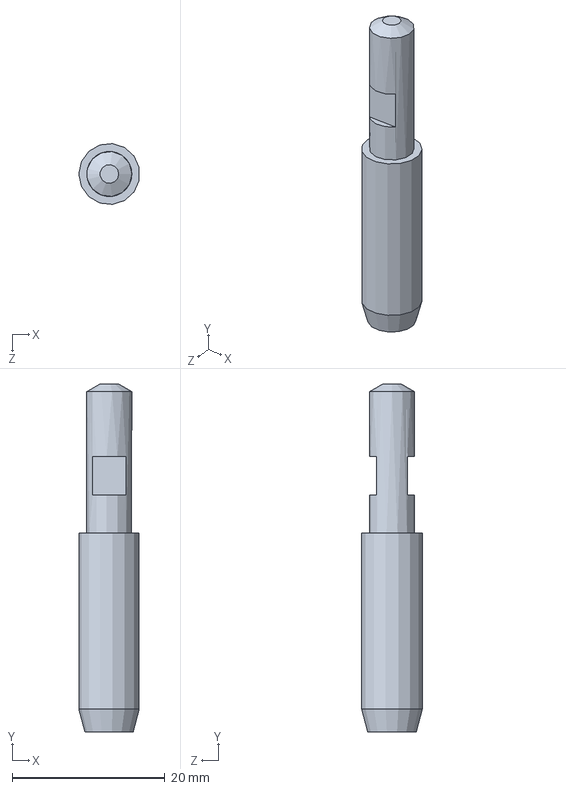
[picture p89: CAD file, 2020-04-04]
medtronic-pb560-ventilator-system-file-set-2/3D CAD Models/PB560 Assy/702-09 Entretoise AV Legendair.SLDPRT
7.91 x 45.5 x 7.96 mm
