darwinbeing/PB560/medtronic-pb560-ventilator-system-file-set-2/3D CAD Models/PB560 Assy/condensateur dia 10.SLDPRT

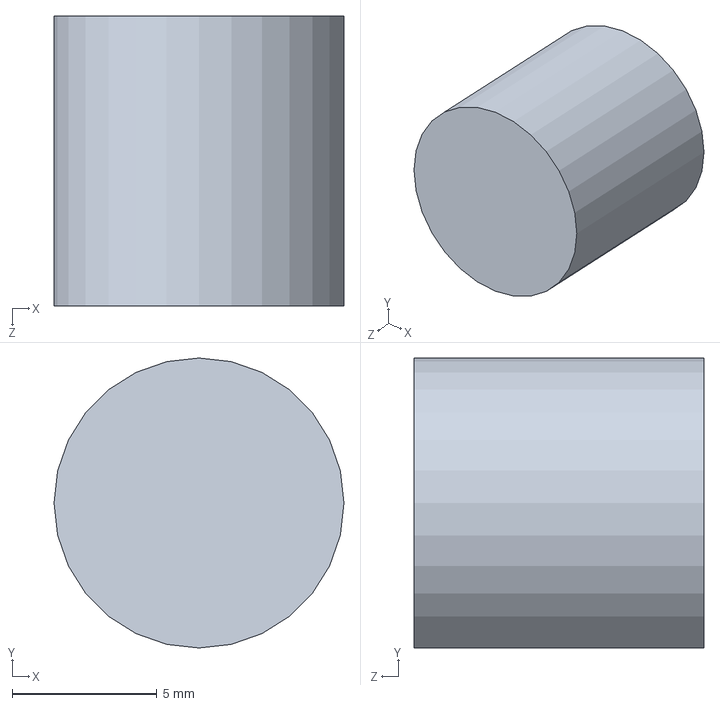
[picture p99: CAD file, 2020-04-04]
medtronic-pb560-ventilator-system-file-set-2/3D CAD Models/PB560 Assy/condensateur dia 10.SLDPRT
10.0 x 10.0 x 10.0 mm
