darwinbeing/PB560/medtronic-pb560-ventilator-system-file-set-2/3D CAD Models/PB560 Assy/tuyau pression interne1.6x4.8.SLDPRT

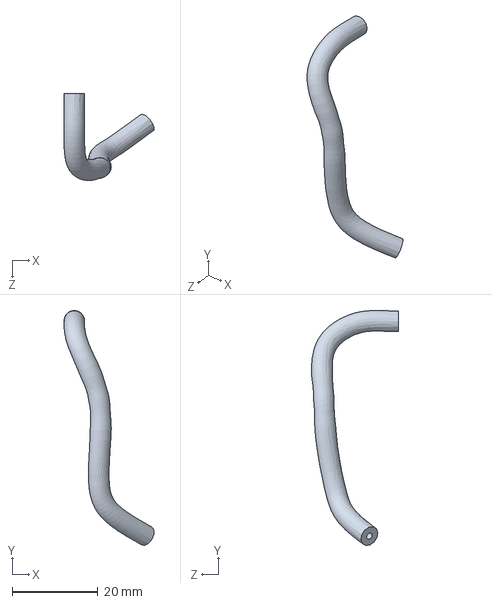
[picture p103: CAD file, 2020-04-04]
medtronic-pb560-ventilator-system-file-set-2/3D CAD Models/PB560 Assy/tuyau pression interne1.6x4.8.SLDPRT
21.0 x 54.7 x 20.3 mm
