darwinbeing/PB560/medtronic-pb560-ventilator-system-file-set-2/3D CAD Models/PB560 Assy/self debout.SLDPRT

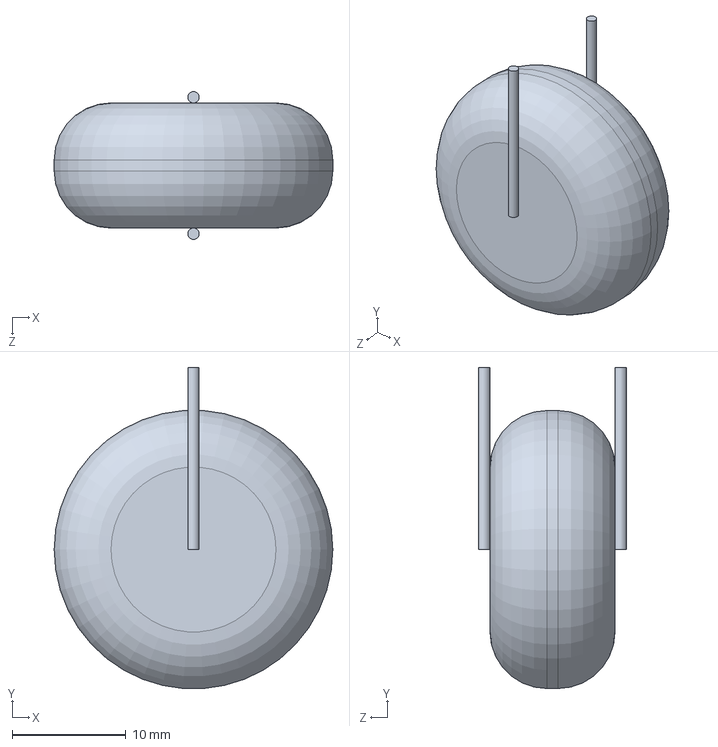
[picture p107: CAD file, 2020-04-04]
medtronic-pb560-ventilator-system-file-set-2/3D CAD Models/PB560 Assy/self debout.SLDPRT
24.5 x 28.2 x 13.0 mm
