darwinbeing/PB560/medtronic-pb560-ventilator-system-file-set-2/3D CAD Models/PB560 Assy/tuyau pression prox1.6x4.8.SLDPRT

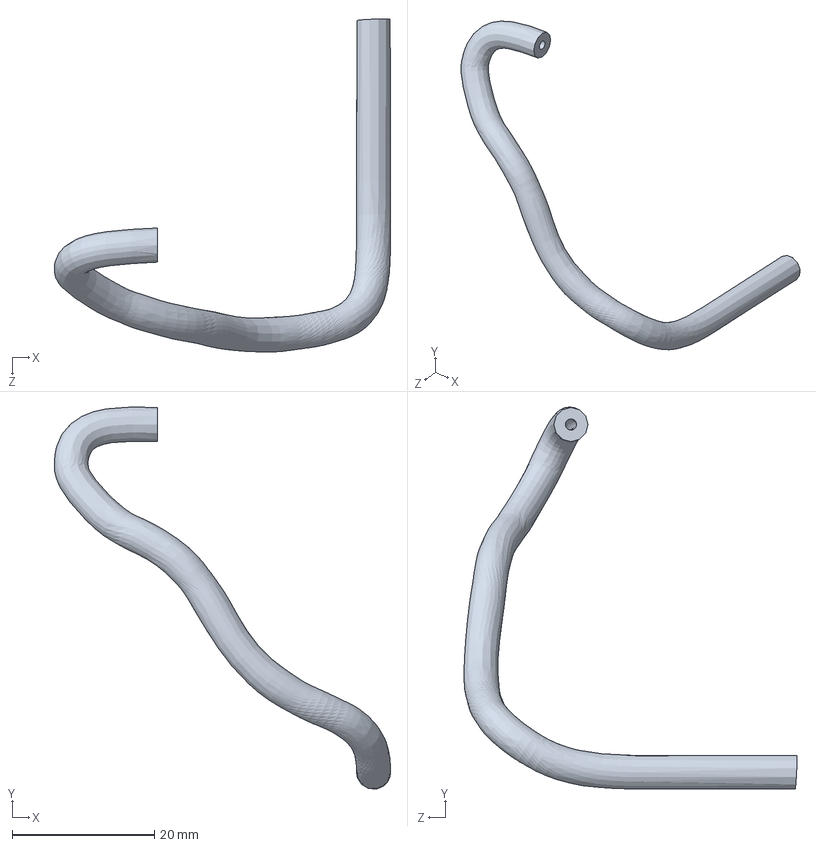
[picture p110: CAD file, 2020-04-04]
medtronic-pb560-ventilator-system-file-set-2/3D CAD Models/PB560 Assy/tuyau pression prox1.6x4.8.SLDPRT
47.2 x 53.6 x 46.8 mm
