darwinbeing/PB560/medtronic-pb560-ventilator-system-file-set-2/3D CAD Models/PB560 Assy/39-26-7265.SLDPRT

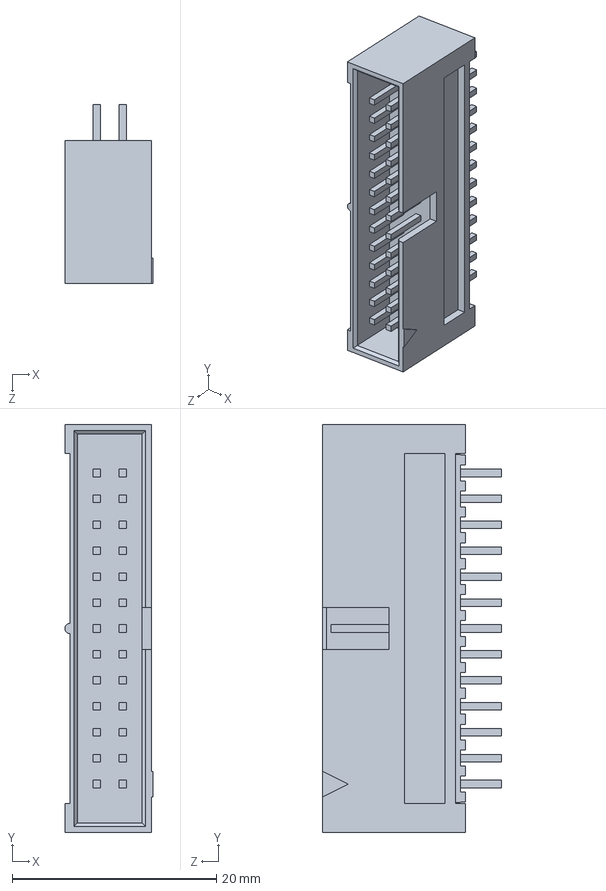
[picture p111: CAD file, 2020-04-04]
medtronic-pb560-ventilator-system-file-set-2/3D CAD Models/PB560 Assy/39-26-7265.SLDPRT
8.65 x 40.0 x 17.5 mm
