darwinbeing/PB560/medtronic-pb560-ventilator-system-file-set-2/3D CAD Models/PB560 Assy/isolant adhésif ens afficheur.SLDPRT

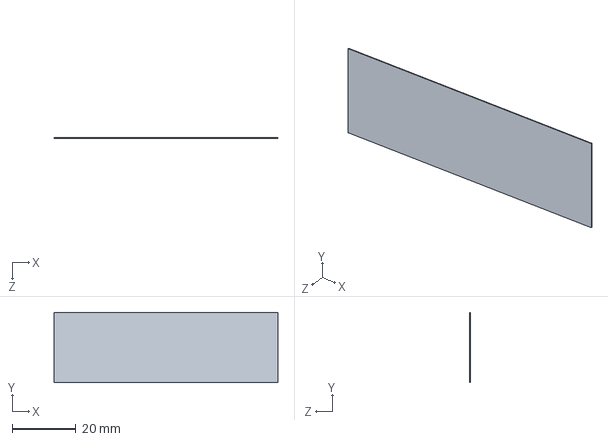
[picture p113: CAD file, 2020-04-04]
medtronic-pb560-ventilator-system-file-set-2/3D CAD Models/PB560 Assy/isolant adhésif ens afficheur.SLDPRT
70.0 x 22.0 x 0.2 mm
