darwinbeing/PB560/medtronic-pb560-ventilator-system-file-set-2/3D CAD Models/PB560 Assy/switch.SLDPRT

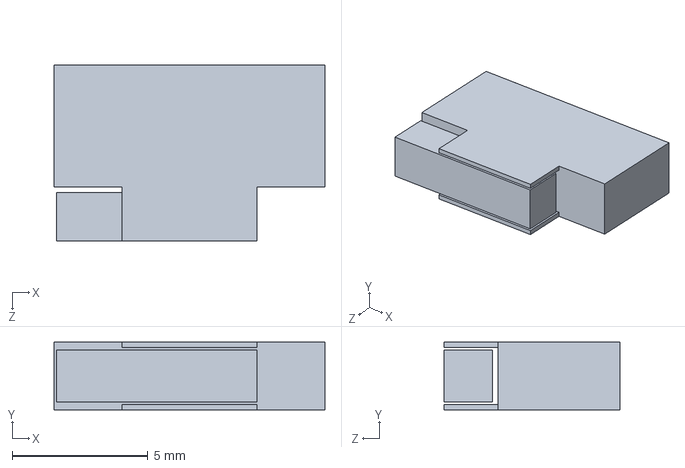
[picture p116: CAD file, 2020-04-04]
medtronic-pb560-ventilator-system-file-set-2/3D CAD Models/PB560 Assy/switch.SLDPRT
10.0 x 2.50 x 6.50 mm
