darwinbeing/PB560/medtronic-pb560-ventilator-system-file-set-2/3D CAD Models/PB560 Assy/boitier capteur pression asdx.SLDPRT

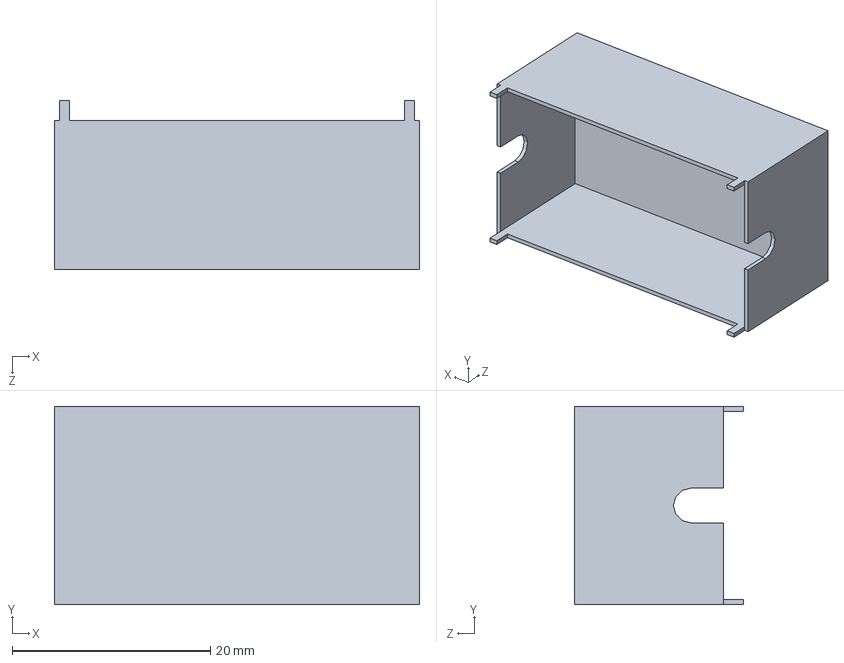
[picture p118: CAD file, 2020-04-04]
medtronic-pb560-ventilator-system-file-set-2/3D CAD Models/PB560 Assy/boitier capteur pression asdx.SLDPRT
36.8 x 20.0 x 17.0 mm
