darwinbeing/PB560/medtronic-pb560-ventilator-system-file-set-2/3D CAD Models/PB560 Assy/Insp Mod Connector.SLDPRT

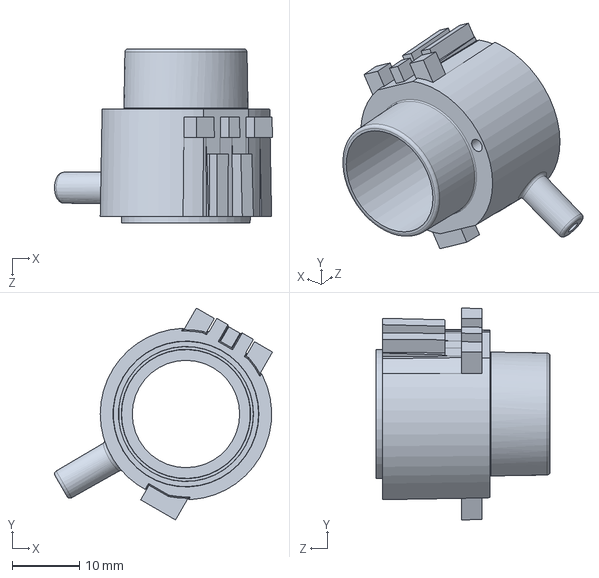
[picture p122: CAD file, 2020-04-04]
medtronic-pb560-ventilator-system-file-set-2/3D CAD Models/PB560 Assy/Insp Mod Connector.SLDPRT
32.5 x 31.6 x 26.0 mm
