darwinbeing/PB560/medtronic-pb560-ventilator-system-file-set-2/3D CAD Models/PB560 Assy/Batt PCB.SLDPRT

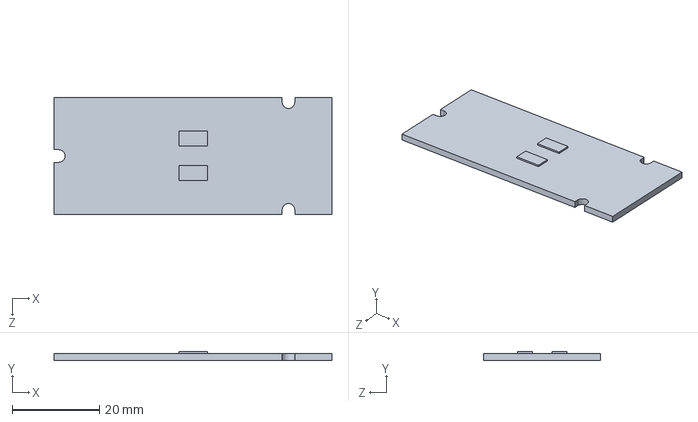
[picture p125: CAD file, 2020-04-04]
medtronic-pb560-ventilator-system-file-set-2/3D CAD Models/PB560 Assy/Batt PCB.SLDPRT
63.9 x 2.00 x 26.9 mm
