darwinbeing/PB560/medtronic-pb560-ventilator-system-file-set-2/3D CAD Models/PB560 Assy/connecteur USB miniB.SLDPRT

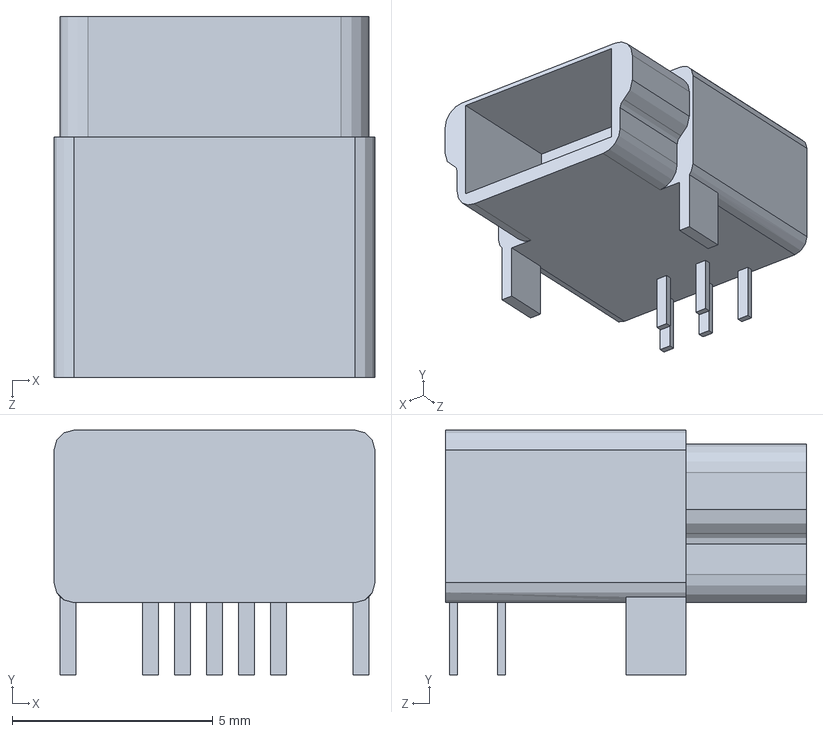
[picture p129: CAD file, 2020-04-04]
medtronic-pb560-ventilator-system-file-set-2/3D CAD Models/PB560 Assy/connecteur USB miniB.SLDPRT
8.00 x 6.10 x 9.00 mm
