darwinbeing/PB560/medtronic-pb560-ventilator-system-file-set-2/3D CAD Models/PB560 Assy/tuyau débit inspi P1.SLDPRT

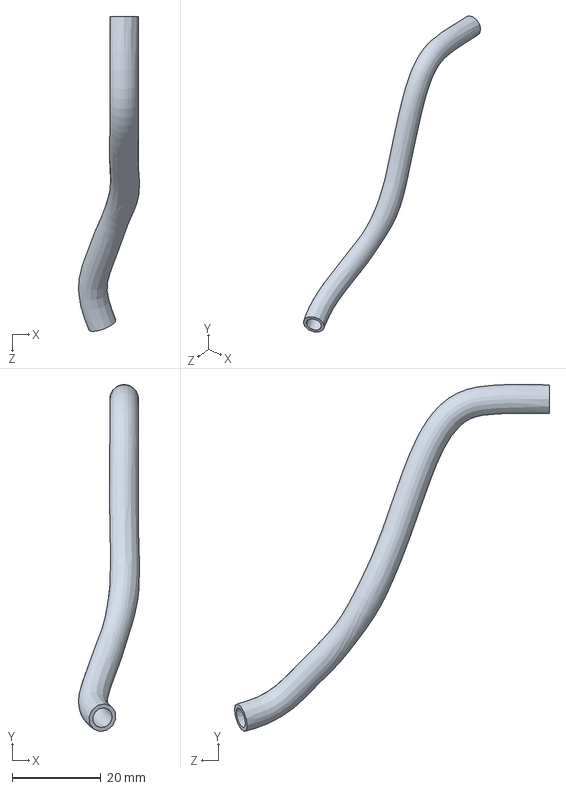
[picture p132: CAD file, 2020-04-04]
medtronic-pb560-ventilator-system-file-set-2/3D CAD Models/PB560 Assy/tuyau débit inspi P1.SLDPRT
13.7 x 78.2 x 71.1 mm
