darwinbeing/PB560/medtronic-pb560-ventilator-system-file-set-2/3D CAD Models/PB560 Assy/I0 178 Entretoise AR Legendair.SLDPRT

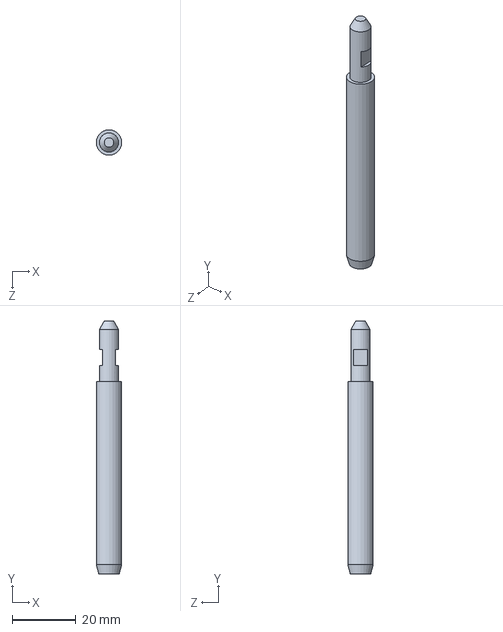
[picture p133: CAD file, 2020-04-04]
medtronic-pb560-ventilator-system-file-set-2/3D CAD Models/PB560 Assy/I0 178 Entretoise AR Legendair.SLDPRT
8.00 x 79.5 x 8.00 mm
