darwinbeing/PB560/(list of files, cad)

Other CAD files:
pb560-vent-files-4/BOM Drawings/PB560 PowerPack/10109801A00/Switchcraft L712AS.sldasm
medtronic-pb560-ventilator-system-file-set-2/3D CAD Models/PB560 Assy/PMCD1204.sldasm
medtronic-pb560-ventilator-system-file-set-2/3D CAD Models/PB560 Assy/_PMC_LATCH_4.sldprt
medtronic-pb560-ventilator-system-file-set-2/3D CAD Models/PB560 Assy/double face.SLDPRT
medtronic-pb560-ventilator-system-file-set-2/3D CAD Models/PB560 Assy/39-28-5104.SLDPRT
medtronic-pb560-ventilator-system-file-set-2/3D CAD Models/PB560 Assy/_100800_8.sldprt
medtronic-pb560-ventilator-system-file-set-2/3D CAD Models/PB560 Assy/filtre murata.SLDPRT
medtronic-pb560-ventilator-system-file-set-2/3D CAD Models/PB560 Assy/_PMCD1204_BODY_2.sldprt
medtronic-pb560-ventilator-system-file-set-2/3D CAD Models/PB560 Assy/_100901_6.sldprt
medtronic-pb560-ventilator-system-file-set-2/3D CAD Models/PB560 Assy/039281023.SLDPRT
medtronic-pb560-ventilator-system-file-set-2/3D CAD Models/PB560 Assy/10049560_Fan Assy (ref ASM).SLDASM
medtronic-pb560-ventilator-system-file-set-2/3D CAD Models/PB560 Assy/10049560_Routed wires (asm ref Part).SLDPRT
medtronic-pb560-ventilator-system-file-set-2/3D CAD Models/PB560 Assy/10049560_ventil SUNON 40x40x20.SLDPRT
medtronic-pb560-ventilator-system-file-set-2/3D CAD Models/PB560 Assy/10079556.SLDASM
medtronic-pb560-ventilator-system-file-set-2/3D CAD Models/PB560 Assy/10079556_Support.SLDPRT
medtronic-pb560-ventilator-system-file-set-2/3D CAD Models/PB560 Assy/10093284.SLDPRT
medtronic-pb560-ventilator-system-file-set-2/3D CAD Models/PB560 Assy/10096315.SLDASM
medtronic-pb560-ventilator-system-file-set-2/3D CAD Models/PB560 Assy/10096505_Board (ref ECAD).SLDPRT
medtronic-pb560-ventilator-system-file-set-2/3D CAD Models/PB560 Assy/10096509.SLDASM
medtronic-pb560-ventilator-system-file-set-2/3D CAD Models/PB560 Assy/10096510.sldasm
medtronic-pb560-ventilator-system-file-set-2/3D CAD Models/PB560 Assy/10096510_Bare Board.SLDPRT
medtronic-pb560-ventilator-system-file-set-2/3D CAD Models/PB560 Assy/10096511.SLDASM
medtronic-pb560-ventilator-system-file-set-2/3D CAD Models/PB560 Assy/10096512.SLDASM
medtronic-pb560-ventilator-system-file-set-2/3D CAD Models/PB560 Assy/10100017.SLDPRT
medtronic-pb560-ventilator-system-file-set-2/3D CAD Models/PB560 Assy/10100018.SLDPRT
medtronic-pb560-ventilator-system-file-set-2/3D CAD Models/PB560 Assy/2004200 Rondelle plate - MN INOX 3 x 8 EP 0.8.sldprt
medtronic-pb560-ventilator-system-file-set-2/3D CAD Models/PB560 Assy/2877500 mousse adhesive 3x20 Légendair.SLDPRT
medtronic-pb560-ventilator-system-file-set-2/3D CAD Models/PB560 Assy/2931200 mousse ép 10mm .SLDPRT
medtronic-pb560-ventilator-system-file-set-2/3D CAD Models/PB560 Assy/2957500 Vis TCB D 3.5 x 8 hexalobes acier zingué.sldprt
medtronic-pb560-ventilator-system-file-set-2/3D CAD Models/PB560 Assy/2957600 Vis TCB D 3.5 x 16 hexalobes acier zingué.sldprt
medtronic-pb560-ventilator-system-file-set-2/3D CAD Models/PB560 Assy/2960100 Vis TCB M3-8 hexalobes acier zingué.sldprt
medtronic-pb560-ventilator-system-file-set-2/3D CAD Models/PB560 Assy/2960600 Vis TF M4 x 10 hexalobes acier zingué.sldprt
medtronic-pb560-ventilator-system-file-set-2/3D CAD Models/PB560 Assy/2961500 Pieds autocollants 12.7x12.7 ep5.8.SLDPRT
medtronic-pb560-ventilator-system-file-set-2/3D CAD Models/PB560 Assy/2963500 batterie legendair.SLDPRT
medtronic-pb560-ventilator-system-file-set-2/3D CAD Models/PB560 Assy/2963800 Vis tête fraisée M3 x 8.SLDPRT
medtronic-pb560-ventilator-system-file-set-2/3D CAD Models/PB560 Assy/2964000 traversée cloison PMC4202.SLDPRT
medtronic-pb560-ventilator-system-file-set-2/3D CAD Models/PB560 Assy/2966100 Vis TCB M3 x 5 exalobes acier zingué .SLDPRT
medtronic-pb560-ventilator-system-file-set-2/3D CAD Models/PB560 Assy/2966300 (ref AML).SLDPRT
medtronic-pb560-ventilator-system-file-set-2/3D CAD Models/PB560 Assy/2970100 goupille cylindrique DIA 2x28.SLDPRT
medtronic-pb560-ventilator-system-file-set-2/3D CAD Models/PB560 Assy/2970300 raccord droit 2.4x3.2 plastique.SLDPRT
medtronic-pb560-ventilator-system-file-set-2/3D CAD Models/PB560 Assy/2970400 Raccord TE 2.4 plastique.SLDPRT
medtronic-pb560-ventilator-system-file-set-2/3D CAD Models/PB560 Assy/2970800 Vis TCB D 3 x 6 hexalobes acier zingué.SLDPRT
medtronic-pb560-ventilator-system-file-set-2/3D CAD Models/PB560 Assy/2970900 vanne A-M O2 FAS.SLDPRT
medtronic-pb560-ventilator-system-file-set-2/3D CAD Models/PB560 Assy/2970999 Vanne A-M O2 FAS.SLDASM
medtronic-pb560-ventilator-system-file-set-2/3D CAD Models/PB560 Assy/2971600 collier adhésif ajustable.SLDPRT
medtronic-pb560-ventilator-system-file-set-2/3D CAD Models/PB560 Assy/2973900 (ref AML).SLDPRT
medtronic-pb560-ventilator-system-file-set-2/3D CAD Models/PB560 Assy/2980100 ferrite 18.8x28.5x13.2.SLDPRT
medtronic-pb560-ventilator-system-file-set-2/3D CAD Models/PB560 Assy/3804800 Filtre entrée d'air.SLDPRT
medtronic-pb560-ventilator-system-file-set-2/3D CAD Models/PB560 Assy/3808400.SLDASM
medtronic-pb560-ventilator-system-file-set-2/3D CAD Models/PB560 Assy/3808801 support cone expiration legendair.SLDPRT
medtronic-pb560-ventilator-system-file-set-2/3D CAD Models/PB560 Assy/3809700 Bouton moleté imperdable.SLDPRT
medtronic-pb560-ventilator-system-file-set-2/3D CAD Models/PB560 Assy/3810200.SLDPRT
medtronic-pb560-ventilator-system-file-set-2/3D CAD Models/PB560 Assy/3812400 entretoise hexa M-F M3.SLDPRT
medtronic-pb560-ventilator-system-file-set-2/3D CAD Models/PB560 Assy/3812500 tole blindage toron moteur.SLDPRT
medtronic-pb560-ventilator-system-file-set-2/3D CAD Models/PB560 Assy/3814200.SLDPRT
medtronic-pb560-ventilator-system-file-set-2/3D CAD Models/PB560 Assy/3814400 ressort capot.SLDPRT
medtronic-pb560-ventilator-system-file-set-2/3D CAD Models/PB560 Assy/3822000.SLDPRT
medtronic-pb560-ventilator-system-file-set-2/3D CAD Models/PB560 Assy/3822500.SLDASM
medtronic-pb560-ventilator-system-file-set-2/3D CAD Models/PB560 Assy/3822500_WIRES.SLDPRT
medtronic-pb560-ventilator-system-file-set-2/3D CAD Models/PB560 Assy/3823200 exterieur poignée.SLDPRT
medtronic-pb560-ventilator-system-file-set-2/3D CAD Models/PB560 Assy/3823200 intérieure poignée.SLDPRT
medtronic-pb560-ventilator-system-file-set-2/3D CAD Models/PB560 Assy/3823200.sldasm
medtronic-pb560-ventilator-system-file-set-2/3D CAD Models/PB560 Assy/3824300 Assy with labels (ref Assy).SLDASM
medtronic-pb560-ventilator-system-file-set-2/3D CAD Models/PB560 Assy/3824300_Main block.SLDPRT
medtronic-pb560-ventilator-system-file-set-2/3D CAD Models/PB560 Assy/3824300_Plastic Insert.SLDPRT
medtronic-pb560-ventilator-system-file-set-2/3D CAD Models/PB560 Assy/3825500.SLDPRT
medtronic-pb560-ventilator-system-file-set-2/3D CAD Models/PB560 Assy/3825700 étiq éxpiration usage unique.SLDPRT
medtronic-pb560-ventilator-system-file-set-2/3D CAD Models/PB560 Assy/3826102 étiquette rappel alarme.SLDPRT
medtronic-pb560-ventilator-system-file-set-2/3D CAD Models/PB560 Assy/3826300 étiquette ATTENTION SECTEUR.SLDPRT
medtronic-pb560-ventilator-system-file-set-2/3D CAD Models/PB560 Assy/3827900.SLDPRT
medtronic-pb560-ventilator-system-file-set-2/3D CAD Models/PB560 Assy/3828200 etiq ident caisson turbine.SLDPRT
medtronic-pb560-ventilator-system-file-set-2/3D CAD Models/PB560 Assy/3828200.SLDPRT
medtronic-pb560-ventilator-system-file-set-2/3D CAD Models/PB560 Assy/3828299 REF ASSY (INCLUDES FOAM).SLDASM
medtronic-pb560-ventilator-system-file-set-2/3D CAD Models/PB560 Assy/3828703 étiquette US o2.SLDPRT
medtronic-pb560-ventilator-system-file-set-2/3D CAD Models/PB560 Assy/3828800 etiq entrée d'air symbolisée.SLDPRT
medtronic-pb560-ventilator-system-file-set-2/3D CAD Models/PB560 Assy/3838600 etiq ID+code barre revB.SLDPRT
medtronic-pb560-ventilator-system-file-set-2/3D CAD Models/PB560 Assy/3838600 étiquette traçabilité .SLDPRT
medtronic-pb560-ventilator-system-file-set-2/3D CAD Models/PB560 Assy/3838600.SLDPRT
medtronic-pb560-ventilator-system-file-set-2/3D CAD Models/PB560 Assy/3839402 etiq sortie d'air symbolisée.SLDPRT
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
