darwinbeing/PB560/(list of files, drawings)

Other design files:
medtronic-pb560-ventilator-system-file-set-2/Electronic PCBAs/10106052_PowerPack_PCBA/SCH/10105965B00.DSN
pb560-vent-files-4/BOM Drawings/PB560 PowerPack/10105965B00/10105965B00.DSN
pb560-vent-files-4/BOM Drawings/PB560 PowerPack/10107738A00/10106054A00.pcb
